azais-corentin/espion/docs/architecture.md

# Architecture

espion tracks markers that reflect or emit infrared light, using several camera boards. Every
board exposes its camera at the same instant, finds the bright blobs in each frame and sends
their subpixel centroids to the host over Ethernet. The host triangulates the markers in 3D.

```mermaid
flowchart LR
  subgraph board["Camera board (×N)"]
    S[OV9281<br/>global shutter, mono] -- "MIPI CSI-2<br/>2 lanes, RAW8" --> P4[ESP32-P4-Core module<br/>capture, blob detection,<br/>UDP, PTP]
    P4 -- "XVS trigger" --> S
    S -- STROBE --> G{{LED gate}}
    S -- "STROBE (ETM capture)" --> P4
    P4 -- LED_EN --> G
    G --> L[850 nm LED ring<br/>12 × Amicc A-SC880IR3C]
    P4 -- RMII --> PHY[IP101G PHY]
    PHY --> J[RJ45 + PoE PD]
    P4 <-- "I2C, INT1" --> IMU[MSA3S02 accelerometer]
  end
  J -- "UDP: espion-proto<br/>PTP (IEEE 1588)" --> SW[(PoE switch,<br/>unmanaged)]
  SW --> H[host:<br/>espion-server, viewer,<br/>calib, sync]
```

## Camera board

A baseboard for a Waveshare ESP32-P4-Core module.

| Part | Role |
|---|---|
| [Waveshare ESP32-P4-Core](https://docs.waveshare.com/ESP32-P4-Core), 16 MB flash (SKU 36096) | ESP32-P4 (rev v3.x) with 32 MB PSRAM: camera control, capture, blob detection, trigger, LED gating, Ethernet MAC with PTP clock |
| OV9281 camera module ([AliExpress](https://fr.aliexpress.com/item/1005012566040263.html)) | 1 MP mono global-shutter sensor, run at 640×400 (2×2 binned), RAW8, 120 fps, triggered on XVS |
| IP101G | 10/100 Ethernet PHY on RMII; supplies the 50 MHz RMII clock |
| HanRun HR871150C RJ45 MagJack | Ethernet jack with magnetics; passes both PoE pair sets to the PD |
| SDAPO DP1435-5V | 802.3af PoE PD module, isolated |
| TI TPS2121 | Picks PoE 5 V or USB-C VBUS, PoE first, no back-feed into USB |
| TI TLV62569 | 3.3 V buck for the module, the PHY and the camera |
| 850 nm LED ring and driver | 12 LEDs in series at a fixed sink current ([hardware/led.md](hardware/led.md)), lit only while `STROBE ∧ LED_EN`, ≤ 0.5 ms per frame at ≤ 120 fps; a hardware timeout cuts a pulse as a backstop |
| USB-C | Bench power, flashing, logs and JTAG (P4 USB Serial/JTAG, no hub) |
| Yongyu YY-0807BRGK26 RGB LED | Status LED (WS2812-type protocol), driven by RMT |
| MEMSensing MSA3S02 accelerometer | 3-axis, no gyroscope. Detects bumps (rig calibration may be stale) and gives the gravity vector |

Board design: [hardware/README.md](hardware/README.md)

## Data flow per frame

```mermaid
sequenceDiagram
  participant P4
  participant S as OV9281
  participant H as Host
  P4->>S: XVS edge at network time T(k)
  S-->>S: expose (STROBE high, LEDs on)
  S->>P4: frame k over MIPI CSI (DMA into a frame buffer)
  P4->>P4: threshold, connected components, weighted centroids (≤ 8.3 ms)
  P4->>H: UDP: espion-proto Centroids packet
  H->>H: group by frame k across boards, triangulate
```

- **Frame numbers match across boards by design.** Frame `k` is the one triggered at network
  time `T(k) = T0 + ⌊k · 10⁹ / 120⌋ ns`. Each packet carries `k` and the capture time
  ([timing.md](timing.md)).
- **Vision budget:** 8.3 ms per frame (1/120 s), end to end on the P4. Capture DMA of the next
  frame runs while the CPU processes the current one. Reference point on the ESP32-P4-ETH dev
  board, 2026-11-11: with live 1280 × 800 RAW8 at 120 fps in 64-line strips, the detector took
  2873 µs per frame on average (2916 µs at most) with the scalar dark skip and 762 µs (806 µs)
  with the PIE one, in a scene with no blob (`firmware/poc-p4-eth/README.md`, "Live strip
  soak, final configuration").
- **Network load:** a few hundred bytes per frame at 120 fps, well under 1 Mbit/s per board on
  a 100 Mbit/s link.

### Memory

The P4 has 768 KB of internal L2 memory, and the flash/PSRAM cache (128, 256 or 512 KB) is
carved out of it. A full frame is 640 × 400 × 1 byte = 250 KiB. With the 128 KiB L2 cache the
bootloader sets, the application has 568 KiB of internal RAM, and one such frame fits beside
`poc-p4-eth`'s other buffers; a 1280 × 800 frame (1000 KiB) is larger than all internal RAM
(`firmware/poc-p4-eth/README.md`, "Chip and memory" and "Detector benchmark (synthetic
frames)"). There is no heap on the P4: every buffer is static.

| Data | Where | Why |
|---|---|---|
| Frame buffers, 2–3 × 250 KiB (DMA fills one while the CPU reads another) | PSRAM | ≈ 61 MB/s at 120 fps (DMA write + one CPU read), under 10 % of the PSRAM's 800 MB/s peak (16-bit DDR, 200 MHz). Espressif's camera driver also keeps P4 frame buffers in PSRAM |
| Ambient mask from dark frames, 1 bit per pixel (32 KB) | Internal | Read for every pixel of every frame |
| Blob and label state, network and PTP buffers, stacks, hot code | Internal | Latency matters. Keeps Ethernet DMA off the PSRAM bus |
| Debug frame captures, calibration snapshots | PSRAM | Not used every frame |

- **Cache coherency:** CSI DMA writes PSRAM behind the CPU caches. Frame buffers are aligned
  and sized to whole cache lines, and the CPU invalidates a buffer's lines before reading a
  new frame from it. Every cache operation of our crates goes through `firmware/esp32p4-cache`,
  which serialises the ROM calls of both cores with one lock; esp-hal's own cache calls
  (Ethernet TX, DMA buffer helpers, `enable_direct`) are outside that lock. `poc-p4-stream`
  runs its own Ethernet DMA rings, which go through it.
- **Measured** (replaces the unverified 200 MB/s assumed here; `firmware/poc-p4-eth/README.md`
  unless named, ESP32-P4-ETH dev board, CPU at 400 MHz, PSRAM at 250 MHz, esp-hal 1.2.2's
  default, with which 200 MHz fails to initialise: "Chip and memory", "PSRAM tuning attempts"):
  - One core reads cold PSRAM at 163 MB/s at most (one load per 64-byte line) and at 120 MB/s
    when it sums every word; internal RAM gives 1424 to 1598 MB/s ("Read speed, one core",
    2026-11-10 and 2026-11-11).
  - The blob detector with the scalar dark skip, frames of 0 to 64 synthetic blobs, no DMA
    running, max of 50 passes ("Detector benchmark (synthetic frames)", 2026-11-10): 640 × 400
    takes 2.7–3.8 ms as a whole frame from PSRAM and 1.3–2.3 ms from 64-line strips in internal
    RAM; 1280 × 800 takes 10.0–10.9 ms from PSRAM and 4.3–5.2 ms from strips. A dark
    1280 × 800 frame costs about 3.8 cycles per pixel from cold PSRAM (about 104 MB/s) against
    1.65 from strips. The PSRAM path runs the same instructions at 0.23 instructions per cycle
    against 0.53 from strips: it waits for memory ("Detector benchmark with counters",
    2026-11-11).
  - Live, 1280-wide whole frames from PSRAM were processed at 85–106 fps instead of 120;
    strips held 120 fps in all four 120 fps modes ("Findings for the camera board").
  - With the L1 data and L2 cache autoload, a whole 1280 × 800 frame from PSRAM took 4.6 ms
    dark and 5.4 ms with 64 blobs, against 9.9 and 10.8 ms without; no DMA ran, and this
    whole-frame autoload has not run under live capture (`firmware/esp32p4-cache/README.md`,
    "Prefetch", 2026-11-11).
  - The detector of 2026-11-11 (span skip, PIE dark skip, hot code in RAM, L1 autoload per
    strip) is measured from strips only: 762 µs per live dark 1280 × 800 RAW8 frame ("Live
    strip soak, final configuration").

  What this means for the two options: at 640 × 400 RAW8, the frame size of this section,
  whole frames in PSRAM fit the 8.3 ms budget without prefetch (2.7–3.8 ms), and strips take
  1.3–2.3 ms. At 1280 × 800 whole frames in PSRAM fit only with prefetch, which is untested
  under live capture; strips fit. Every detector figure above except the last is from the
  scalar detector before the changes of 2026-11-11.
- **Fallback if that pass is too slow:** CSI DMA into a ring of line strips in internal memory
  (e.g. 64 lines, 40 KiB), processed strip by strip as the frame arrives. This also cuts
  latency. Built: the CSI bridge ends a DMA block after a set number of bursts, and
  `esp32p4-csi`'s `CsiStrips` delivers strips from a ring in internal RAM. In `poc-p4-eth` all
  four 120 fps modes ran on 64-line strips with every pixel processed, the centroids ready
  0.1–0.4 ms after the end of the frame ("Findings for the camera board").

## Firmware

| Crate | Chip / target | Runs |
|---|---|---|
| `firmware/cam-p4` | ESP32-P4, `riscv32imafc-unknown-none-elf` | One core runs the vision loop. The other runs embassy tasks: sensor control over SCCB, the XVS edge schedule (RMT), the PPS servo (ETM capture), Ethernet and embassy-net (DHCP, UDP), PTP (statime), the LED gate, and the accelerometer (bump detection, gravity) on a second I2C bus |
| `firmware/esp32p4-cache` | ESP32-P4 (no_std library) | Cache maintenance (invalidate, write-back) through the ROM, every call behind one cross-core spinlock held with interrupts masked on the calling core, because both cores share one set of cache-sync registers; and the hardware prefetch set-up (L1 data and L2 autoload, manual L1 data preload) on the `esp32p4` PAC. No esp-hal, esp-rtos or critical section, so a bare second core can call it. esp-hal's own cache calls (Ethernet TX buffers and descriptors, DMA buffer helpers, `enable_direct`) are not covered. Used by `esp32p4-csi`, `esp32p4-jpeg` and `poc-p4-stream`'s Ethernet rings; its prefetch by `poc-p4-eth` (L1 autoload per strip) and `poc-p4-stream` (L1 preload of the next datagram's bytes) |
| `firmware/esp32p4-csi` | ESP32-P4 (no_std library) | MIPI CSI-2 receiver driver on the `esp32p4` PAC, written in esp-hal style: ISP in bypass, a DW-GDMA (VDMA) channel into whole frames (`Csi`) or a ring of line strips in internal RAM (`CsiStrips`). Used by `cam-p4`, `poc-p4-eth` and `poc-p4-stream` |
| `firmware/esp32p4-jpeg` | ESP32-P4 (no_std library) | Hardware JPEG encoder driver (greyscale, baseline) and the 2D-DMA registers it needs, on the `esp32p4` PAC, in esp-hal style. Tested and measured in `poc-p4-eth` (`JPEG_PLAN`); streams the camera's frames in `poc-p4-stream` |
| `firmware/esp32p4-perf` | ESP32-P4 (no_std library) | Performance counters of the HP cores: cycles, instructions, conditional branches and their mispredictions, stores (CSRs), and the L1/L2 cache hit and miss counters; marker pins through the calling core's dedicated-IO CSRs (`marker`: enable, toggle in three instructions). No esp dependency and no lock, so a bare second core can call it. Used by the benchmarks of `poc-p4-eth`, by `espion-core1` and by the feature `markers` of the PoCs |
| `firmware/esp32p4-pie` | ESP32-P4 (no_std library), encoders host-testable | PIE (Xespv 2.2) vector kernels without compiler support: `const fn` encoders produce the instruction words, `asm!` emits them with `.insn`. `Pie::enable` turns PIE on for the calling core and hands out one token per core; esp-rtos saves no PIE state, so one thread per core may use it and no interrupt handler. Four kernels, each with a scalar reference and a self-test that passed on the board: the dark-skip scan for RAW8 and for RAW10, a copy at any alignment, the Internet-checksum sum. Feature `ram` puts the skip kernels in internal RAM. Used by `espion-vision`, `poc-p4-eth` and `poc-p4-stream` |
| `firmware/espion-core1` | ESP32-P4 (no_std library) | The blob detector on a bare core 1, started through esp-hal's `CpuControl` with no scheduler, no interrupts, no critical section and no logging there: its own trap vector, a loop that polls `esp32p4-csi`'s `StripReader`, runs `espion-vision` (PIE skip on core 1's own token, the L1 data autoload over each strip) or a row-checksum pixel check, and publishes one result per frame through a single-producer single-consumer queue of atomics; core 0's handle hands the reader over, calls `StripControl::service()`, drains the results, logs core 1's figures once a second and watches its heartbeat and trap record. Feature `markers`: core 1 toggles two dedicated-IO channels (strip taken, frame done), and core 0 routes marker channels of either core to pads and reads them back at boot. Used by `poc-p4-eth` (`RUN_CORE1`) and `poc-p4-stream` (`Service::BenchVision`) |
| `firmware/espion-vision` | no_std library, host-testable | The blob detector: threshold, runs per row, 8-connected components with union-find, intensity-weighted centroids in 1/32 pixel, area and peak; RAW8 and CSI-2 RAW10, whole frames or strips of rows. The dark skip is a `Skip` trait passed to each call: `Scalar` (the reference) or, with feature `pie`, `esp32p4-pie`'s token; feature `ram` puts the hot functions in internal RAM. Its tests compare it with a flood-fill reference on random frames. For `poc-p4-eth` (benchmarks and soaks), `espion-core1` (core 1) and `cam-p4` |
| `firmware/poc-p4-eth` | ESP32-P4 on the Waveshare ESP32-P4-ETH, `riscv32imafc-unknown-none-elf` | Throwaway proof of concept, not part of the product, without Ethernet: OV9281 capture in 12 modes (whole frames in PSRAM or strips in internal RAM) and soaks, the detector's benchmarks, the JPEG encoder's test |
| `firmware/poc-p4-stream` | ESP32-P4 on the Waveshare ESP32-P4-ETH, `riscv32imafc-unknown-none-elf` | Throwaway proof of concept, not part of the product: Ethernet with IPv6 link-local only (esp-hal brings the EMAC and the IP101GRI PHY up; the crate's own EMAC DMA rings carry the data, and the stream's datagrams go straight onto the TX ring beside smoltcp, the body copied by PIE), and the `espion-proto` camera stream service on UDP 5009: the OV9281 through `ov9281` and `esp32p4-csi`, frames sent raw or encoded by `esp32p4-jpeg`, every setting taken from the host. Viewed with `host/poc-viewer` |
| `firmware/ov9281` | no_std library, host-testable | OV9281 sensor driver: the mode solver (format, size, crop or binning, frame rate → clock, HTS, VTS and registers, refusing what the measured limits do not allow) and SCCB control over `embedded-hal-async` I2C. For `poc-p4-eth` and `cam-p4` |

`cam-p4` uses `esp-hal` and `esp-rtos` (embassy executor). The XVS edge schedule reuses the
RMT technique from the private
[esp-wifi-sync](https://github.com/azais-corentin/esp-wifi-sync) experiments (`wave.rs`).

### Network

- **Addressing:** DHCP only. The rig network needs a DHCP server (the host or the router).
- **Finding the host:** the host is whoever sent the last Config or FrameEpoch. Until a host
  is known, Status is broadcast ([protocol.md](protocol.md)).
- **PTP:** statime as an ordinary clock over UDP/IPv4 multicast, with hardware timestamps from
  the EMAC ([timing.md](timing.md)). The board joins the PTP multicast group with IGMP
  (embassy-net `multicast`).

## Host

| App | Role |
|---|---|
| `espion-server` | CLI. Receives UDP packets, groups centroids by frame number, triangulates with the current calibration |
| `espion-viewer` | egui live view: blobs per camera, 3D markers, sync health |
| `espion-calib` | Lens model per camera (intrinsics) and rig extrinsics |
| `poc-viewer` | egui live view and control of the `poc-p4-stream` camera stream: every sensor and stream setting, JPEG frames decoded off the UI thread (`zune-jpeg`) and shown through wgpu, statistics; a fake camera that speaks the protocol (`jpeg-encoder`); the board test. Proof of concept, not part of the product |
| `espion-sync` | Watches and coordinates time sync. The network clock is PTP, and the boards elect the grandmaster among themselves. espion-sync sets the frame epoch `T0`, maps network time to host time, and reports the grandmaster and each board's sync health. It never becomes grandmaster |

`crates/espion-proto` is the single source of truth for the UDP wire format
([protocol.md](protocol.md)).

## Pinned versions

Checked on 2026-10-28; the `esp-rom-sys` row and the notes on PIE, cache calls and `memcpy`
added on 2026-11-11. The firmware crates commit their `Cargo.lock`.

| Component | Version | Notes |
|---|---|---|
| Rust | 1.99.1 (stable) | `rust-toolchain.toml`; esp-hal needs ≥ 1.95. rustc's LLVM knows no PIE instructions: `esp32p4-pie` emits encoded words |
| esp-hal | ~1.2.2 | `unstable` feature needed for RMT, DMA, PSRAM and Ethernet. Its ROM cache calls take no cross-core lock (see `esp32p4-cache`) |
| esp-rom-sys | 0.1.5 | Through esp-hal. Binds `memcpy` to the ROM routine, which copies byte by byte when source and destination differ modulo 4 ([gaps](#esp-hal-support-and-gaps)) |
| esp-rtos | 0.4.0 | embassy integration (replaces esp-hal-embassy). Saves no PIE state on a thread switch (see `esp32p4-pie`) |
| esp-bootloader-esp-idf | 0.6.0 | App descriptor for the ESP-IDF second-stage bootloader |
| esp-println / esp-backtrace | 0.18.0 / 0.20.0 | |
| esp32p4 (PAC) | 0.3.x | Same major as esp-hal 1.2.2; used by the CSI driver, ETM, the EMAC PTP clock, and the cache, JPEG and PIE crates |
| embassy-executor / embassy-time / embassy-net | 0.10.0 / 0.5.1 / 0.9.1 | embassy-net with `dhcpv4`, `udp`, `multicast`, `medium-ethernet` (`cam-p4`); `poc-p4-stream`: `proto-ipv6`, `udp`, `medium-ethernet`, `auto-icmp-echo-reply` |
| embassy-sync / embassy-futures / embassy-net-driver | 0.8.0 / 0.1.2 / 0.2.0 | `poc-p4-stream`; the versions esp-hal 1.2.2 and embassy-net 0.9.1 use |
| static_cell | 2.1.1 | Static task and buffer storage (`poc-p4-stream`) |
| statime | 0.4.0 | `default-features = false`: no_std, no `alloc`. Builds for `riscv32imafc-unknown-none-elf` |
| serde / postcard | 1.0.229 / 1.1.3 | `default-features = false` on firmware |
| espflash / probe-rs | 4.6.0 / 0.32.0 | From nixpkgs (flake.lock) |
| embedded-hal-async | 1.0.0 | I2C and delay traits of `firmware/ov9281`; the version esp-hal 1.2.2 implements |
| eframe (egui, wgpu) | 0.37.0 | Host GUI (`poc-viewer`); the `egui_mcp` version in `flake.nix` must match |
| zune-jpeg | 0.5.15 | Host JPEG decoder (`poc-viewer`): pure Rust, SIMD on x86; chosen against libjpeg-turbo by measurement (`host/poc-viewer/README.md`) |
| jpeg-encoder | 0.7.1 | Host JPEG encoder of the fake camera (`poc-viewer`); licence `(MIT OR Apache-2.0) AND IJG` |

## esp-hal support and gaps

Status from the esp-hal 1.2.2 support table and `esp-metadata` (✔ supported, ⚒ partial,
❌ not supported). Only what espion needs is listed.

| Need | esp-hal 1.2.2 | Plan |
|---|---|---|
| MIPI CSI-2 receiver | ❌ | Own driver in `firmware/esp32p4-csi` on the `esp32p4` PAC. Written like an esp-hal driver (`Config`, typed pins, DMA buffers, blocking and async APIs, HIL-testable), but not meant for upstream. On the ESP32-P4-Core the MIPI PHY runs from `ESP_LDO_VO3`, which is 0 V by default: the driver sets it to 2.5 V before starting the CSI host |
| ISP | ❌ | Bypassed: RAW8 goes straight to memory. Blob detection needs no demosaicing (mono sensor). `esp32p4-csi` disables the ISP pipeline; its header and tail stay in the CSI → memory path. Captures worked so in all 12 modes of `poc-p4-eth` |
| DMA for CSI | ⚒ (DMA partial) | The CSI bridge feeds a DW-GDMA ("VDMA") channel. esp-hal has the `VDMA_CH0`..`VDMA_CH3` singletons but no driver for this path, so `esp32p4-csi` programs it: one block per frame into PSRAM, or blocks of strips that the bridge ends after a set number of bursts (see [Memory](#memory)). The driver does the cache invalidation |
| I2C master (SCCB, accelerometer) | ✔ | Two buses: SCCB to the camera, and the accelerometer on its own pins |
| Ethernet (EMAC, RMII) | ⚒ `unstable` ([esp-hal#5556](https://github.com/esp-rs/esp-hal/pull/5556), "basic") | `esp_hal::ethernet::Ethernet` with an `RmiiPinBundle`, `ExternalRefClock` on GPIO50 and its embassy-net driver. **Verified on the ESP32-P4-ETH** (`firmware/poc-p4-stream`, IP101GRI PHY, 100 Mbit/s full duplex, IPv6 only): board to host at the wire limit (11.80 MB/s of 1452-byte UDP datagrams, from internal RAM and from cold PSRAM, none lost or wrong); host to board at the wire limit for 60 s with every byte checked (RX-buffer cache maintenance works) and 100 small datagrams/s beside full-rate TX, none lost. Needs three workarounds in the firmware, each a defect to take upstream: (1) TX store-and-forward, which the driver turns on, breaks frames above a few hundred bytes on the P4 (lost, wrong checksums): switch the DMA to threshold mode, as ESP-IDF does; (2) then the EMAC inserts no checksums (the driver sets CIC 3 and tells smoltcp to skip them), so smoltcp computes the UDP and ICMPv6 checksums (`Checksum::Tx`); (3) the driver's DMA-buffer check takes esp-metadata's DRAM range, which assumes a 256 KiB L2 cache: with the 128 KiB the bootloader sets, statics below 0x4FF40000 panic, so the DMA storage goes in a linker section at or above it. Since 2026-11-11 `poc-p4-stream` uses esp-hal's driver only to bring the EMAC and the PHY up, then starts the DMA on its own rings (`net/eth.rs`, no esp-hal change): threshold mode from the start, one cache call per frame through `esp32p4-cache` where esp-hal's rings made one or two ROM cache calls per token request (about 1 200 cycles), and a TX completion interrupt on every 8th frame instead of every frame; the runner went from 27 100–27 400 to 14 700–15 800 cycles per datagram in the bench (`firmware/poc-p4-stream/README.md`, "Measured: step 2, the Ethernet ring" and "The Ethernet driver"). Workaround (3) then covers only the 3 200 B descriptor storage `Ethernet::new` still needs. `GenericPhy` wakes the runner on every poll and reads three MDIO registers each time: use a PHY driver that polls the link on a timer. smoltcp 0.13 (embassy-net 0.9) can panic in `send_to_with` when a socket's TX metadata ring is the limit: size it above the payload ring. Not verified: 10 Mbit/s and half duplex, link loss and re-negotiation, multicast, PTP |
| EMAC IEEE 1588 (PTP clock, timestamps, PPS) | ❌ | The clock (sub-second increment, addend, time update) and PPS are EMAC registers at the MAC base + 0x700. The `esp32p4` 0.3 PAC has no block for them (only `EMAC_MAC` and `EMAC_DMA`), so `cam-p4` writes them through raw pointers, with the offsets from ESP-IDF. The TRM does not document the PPS control and auxiliary snapshot fields that ESP-IDF's register struct has: check them on the first board. The RX/TX timestamps sit in the DMA descriptors that esp-hal's driver owns, and it ignores descriptor words 4–7. That needs an esp-hal change: carry it as a `[patch.crates-io]` fork and upstream it. Measured alternative: `poc-p4-stream` owns its descriptor rings (32-byte enhanced format) after esp-hal's bring-up, without changing esp-hal ("The Ethernet driver" in its README) |
| Per-packet timestamps to statime | n/a | embassy-net sockets carry no per-packet metadata. The driver matches PTP event frames (UDP 319) to their descriptor timestamps by message type and `sequenceId` and hands them to statime |
| RMT | ⚒ | XVS edge schedule, as in esp-wifi-sync `wave.rs` (TX channel 0), the status LED (WS2812-type protocol, channel 2 or 3) and the 50 kHz `BST_EN` PWM that sets the LED boost's output (a third TX channel in loop mode, [hardware/firmware-rules.md](hardware/firmware-rules.md) FW-8) |
| ETM | ❌ | Needed from day one: the PPS edge and the STROBE edge (GPIO events) trigger timer capture tasks. PAC-level code in `cam-p4`. Per the TRM, SYSTIMER has no capture task; timer 0 of each timer group has one (TG0's is taken by esp-rtos, so TG1 timer 0), and MCPWM capture (three registers per unit, 6.25 ns) is the alternative ([timing.md](timing.md) section 2). The VDMA, the CSI host and bridge, the ISP, the EMAC and RMT have no ETM event or task, so strip and frame completion stay interrupts or polls. Still to measure on the board: ETM latency, and whether a GPIO event fires on a pad the EMAC drives as PPS output (the board also loops PPS into a second GPIO through R34, so either way works) |
| MCPWM / PCNT / LEDC | ❌ (no LEDC or MCPWM driver for the P4) | Not needed: STROBE gates the LEDs, and the `BST_EN` PWM runs on RMT |
| ADC (one-shot) | ⚒ `unstable` | ADC1 channel 7 (`LED_K_SENSE`). It is read late in each LED pulse for the boost headroom loop (FW-22), so the conversion is timed from the STROBE capture; check the one-shot conversion time against that window. It also confirms the boost is up before the LEDs run (FW-7) |
| SYSTIMER, TIMG | ⚒ | Local timebase, embassy time driver |
| PSRAM | ⚒ | Frame buffers (CSI DMA target) and data not used every frame; see [Memory](#memory) |
| USB Serial/JTAG | ⚒ | Flashing and logs. The board has no VBUS sense, so the D+ pull-up stays on ([hardware/firmware-rules.md](hardware/firmware-rules.md), FW-4 removed) |
| Chip revision | v3.0+ only | The ESP32-P4-Core carries an ESP32-P4NRW32X, rev v3.x |
| JPEG codec (hardware encoder) | ❌ (the PAC has the `JPEG` block, but marks the quantisation-table registers `T0QNR`..`T3QNR` read-only, which the TRM and ESP-IDF write) | Own driver in `firmware/esp32p4-jpeg` on the PAC: greyscale baseline JPEG from a frame in PSRAM or internal RAM, header and IJG quality tables built by the CPU, async wait on the `JPEG` interrupt, cache maintenance and error recovery in the driver. Colour formats, decoding and restart markers are not covered |
| 2D-DMA | ❌ (no driver; no register block in the `esp32p4` 0.3 PAC; its interrupt sources 104..=108, 133, 134 are missing from the PAC's `Interrupt` enum, so esp-hal cannot bind them) | Register offsets from ESP-IDF `hw_ver3/soc/dma2d_reg.h` (TRM chapter 8) in `esp32p4-jpeg` (`dma2d` module): TX channel 0 (2D, macroblock reordering) and RX channel 1 (1D) connected to the JPEG codec, nothing else. Its own interrupts are not used: the driver polls their raw bits after the codec's interrupt. PPA and memory-to-memory transfers are not covered |
| PIE (Xespv 2.2 SIMD) | n/a (rustc's LLVM knows no PIE instructions) | `firmware/esp32p4-pie`: `const fn` encoders, the words emitted with `.insn` in `asm!` on stable Rust, checked against Espressif's assembler. Nothing saves PIE state: not the trap entry (riscv-rt, esp-riscv-rt), not esp-rtos 0.4.0's thread switch. So one PIE-using thread per core and none in an interrupt handler; the per-core token enforces the first part |
| Cache maintenance from two cores | ❌ (the ROM cache calls run without a lock; both cores share one set of cache-sync registers) | `firmware/esp32p4-cache`: every call behind one cross-core spinlock, as ESP-IDF does. esp-hal's own calls stay outside it (see [Memory](#memory)) |
| Cache prefetch (L1 data and L2 autoload, L1 data preload) | ❌ (no config key on the P4) | `esp32p4-cache`'s `prefetch` module writes the `CACHE` registers through the PAC. Run under live DMA in `poc-p4-eth` (per strip) and `poc-p4-stream` (per datagram); see its README |
| Performance counters | ❌ (esp-hal 1.2.2 has no API; its source does not touch `mhpmevent`, `minstret` or `mcountinhibit`) | `firmware/esp32p4-perf`: `mcycle`, `minstret`, the branch, misprediction and store counters (their selectors `mhpmevent8/9/13` are 0 at boot, so they count nothing until written) and the `CACHE` block's L1 and L2 hit and miss counters |
| Dedicated IO (CPU GPIO channels) | ⚒ `unstable` (`gpio::dedicated`, 8 channels per core; its drivers pick the signal of the core they are created on and must stay there, so core 0 cannot set up core 1's channels with them) | Marker pins (`esp32p4-perf` `marker`, `espion-core1` `markers`): either core's channel routed from core 0 with `OutputSignal::CPU_GPIO_n::connect_to` (core 0 signals 214 to 221, core 1 222 to 229), the output enabled by the driving core through its own `cpu_gpio_oen` CSR. The enable is active low, as esp-hal and ESP-IDF have it and against the TRM (p.175): checked on the board |
| `memcpy` | n/a (esp-rom-sys 0.1.5 binds it to the ROM routine by a plain assignment, `memcpy = 0x4fc0026c;`, so a definition in a crate does not replace it; only a link option could) | The ROM routine copies byte by byte when source and destination differ modulo 4: 9.06 cycles per byte against 1.71 aligned (`firmware/esp32p4-pie/README.md`, "Kernels"). Hot copies use `Pie::copy`: the stream bench's datagram copy from internal RAM went from 13 041 to 1 349 cycles (`firmware/poc-p4-stream/README.md`, "Measured: step 1, the datagram copy through PIE") |

Tooling: esp-generate 1.4.0 has no ESP32-P4 template. `cam-p4` was adapted from the C9 template
and the esp-hal 1.2.2 examples.
