azais-corentin/espion/docs/hardware/ethernet.md

# Ethernet

10/100 Ethernet for the P4's EMAC: an IP101G PHY (U1) on RMII, and a HanRun HR871150C MagJack
(J1) that also hands both PoE pair sets to the PD module ([power](power.md#poe-input)). The PHY
supplies the 50 MHz RMII clock.

| Signal | U6 pin | GPIO | Use |
|---|---|---|---|
| RMII_CRS_DV | U6.40 | GPIO28 | RMII receive data valid (PHY strap FX_HEN) |
| RMII_RXD0 / RXD1 | U6.41 / U6.42 | GPIO29 / GPIO30 | RMII receive data |
| RMII_TXD0 / TXD1 | U6.46 / U6.47 | GPIO34 / GPIO35 | RMII transmit data (P4 straps) |
| RMII_TX_EN | U6.67 | GPIO49 | RMII transmit enable |
| RMII_REF_CLK | U6.68 | GPIO50 | 50 MHz clock input from the PHY |
| MDC / MDIO | U6.43 / U6.70 | GPIO31 / GPIO52 | PHY management (GPIO matrix) |
| PHY_RST_N | U6.18 | GPIO22 | PHY reset, active low |

Firmware use of these pins and the PHY: [firmware-rules](firmware-rules.md#gpio-map),
[rules](firmware-rules.md#rules).

## PHY

U1 is an IC Plus IP101G (QFN-32, 0.4 mm pitch; the IP101GRI industrial grade, rated to 85 °C ambient,
p.57), on the top side next to J1.
The source is the IP101G datasheet IP101G-DS-R01 (2014-05-20), cited below by page. VDDIO (pin 13) and
AVDD33 (pin 31) are on +3V3, so the 3.3 V I/O and timing rows apply. The PHY and the P4's I/O share
one rail, so neither can back-power the other.

- **Part choice.** IC Plus publishes no MSL or reflow rating for the IP101G. JLCPCB lists MSL 3, but
  that is distributor data. The part is kept, and the missing maker statement is an accepted risk
  (user decision, 2026-10-31: "Keep IP101GRI, accept risk"). There is no drop-in alternative, and a
  0.4 mm QFN can't be hand-soldered reliably.
- **Decoupling.** C7 sits at AVDD33 and C9 at VDDIO, with C8 as the local bulk capacitor. The datasheet
  sets no values here, only "decoupled carefully" (p.18) and "as close as possible" (p.56). The
  `near` entries C9/C7 → U1, C6 → U1.28 and C4 → C6 carry the "close" distance. The exposed pad (pin 33,
  ground) is stitched to GND with vias.
- **Unused pins.** TXD3/TXD2 (pins 6/7) and TXER (pin 1) go to GND (p.16). RXD2/RXD3 and RXER/INTR_32
  are outputs and stay open. TEST_ON (pin 24) stays open on its internal pull-down (p.18).

### Crystal

Y1 is a 25 MHz Epson TSX-3225. RMII with a crystal takes 25 MHz (Table 3, p.45).

| Item | Y1 (Epson p.1) | IP101G needs (Table 14, p.58) |
|---|---|---|
| Load capacitance C_L | 12 pF | — |
| ESR | ≤ 40 Ω | ≤ 40 Ω |
| Drive level | 10–100–200 µW | 100 µW typ |
| C0 / C1 | 1.39 pF / 3.78 fF | C0 ≤ 7 pF |
| Tolerance | ±10 ppm at 25 °C, ±20 ppm over −40…+85 °C | ±50 ppm |

Load capacitors C2 and C5 (C0G):

- C = 2 × (C_L − C_stray). C_stray is assumed to be 3 pF for the pin and trace, because the IP101G
  gives no pin capacitance.
- Pulling: Δf/f = (C1/2) × (1/(C0 + C_L,a) − 1/(C0 + C_L,b)), with C_L,a the effective load and C_L,b
  the nominal C_L. The effective load is C_L,eff = C/2 + C_stray, with C_stray taken over an assumed
  2–5 pF range.
- Worst sum: pull + initial tolerance (±10 ppm) + temperature tolerance (±20 ppm) must stay within the
  PHY's and RMII's ±50 ppm.

Placement:

- Y1 sits next to U1, and both XTAL lines are short. At 25 MHz both lines are electrically short.
  XTAL_X1 loops round the crystal's north side to Y1.1.
- There is no GND guard trace round the crystal. The datasheet asks for one "if possible" (§6.1 p.56),
  and here it isn't possible. The crystal relies on distance and the In1/In2 GND planes. The nearest
  other copper is a +32V track at C2's X1 pad, and the LED switch Q1's drain copper (`kicad_query distance`;
  [layout](layout.md#ethernet-and-poe-isolation)).
- MDC, MDIO, R14's +3V3 feed and the COL/RMII strap cross under Y1, C5 and the X1/X2 traces on B.Cu,
  with the In1 and In2 GND planes between. MDC crosses the X2 traces, under the Y1.3 and C5.1 pad
  corners; it runs along a clock trace only under U1.2's pad and its X1 stub, against §6.1 p.56 ("Avoid
  signals path parallel to clock signals path … such as MDC and X1"). There is no other way: U1's
  management pins face east, U6 lies south-west, and the RMII fan-out, MDI, Q1's drain zone and the
  board edge close every other B.Cu path. ETH_LED_G crosses only the X1 link C2–Y1, once, at right angles
  ([layout](layout.md#ethernet-and-poe-isolation)).

### REGOUT and ISET

- **REGOUT** (pin 28) is the PHY's internal 1.1 V regulator output, 1.07–1.18 V (p.57). C4 and C6
  decouple it, as the datasheet asks ("A 10uF and 0.1uF should be connected", p.18). Pin 28 lies between
  the two MDI pairs, so its track leaves north and reaches C6 over B.Cu through vias, then the C6/C4
  pour; C6 is close to the pin edge to edge (`near` entry C6.1 → U1.28,
  [layout](layout.md#phy-side-decoupling)). A first-board check scopes REGOUT at C6.
- **ISET** (pin 25) sets the transmit amplitude. R6 to GND is the ISET resistor; the datasheet asks
  for 6.19 kΩ ±1 % (p.18, p.53). R6 is the nearest fee-free value at ±1 % (user decision
  2026-11-09); its band ends slightly above the datasheet's (an [accepted risk](#accepted-risks)).
- Both pins sit next to the MDI pads at the 0.4 mm pitch, so their tracks leave between the MDI pairs
  (see [MagJack and MDI](#magjack-and-mdi)).

### Reset

- PHY_RST_N runs from GPIO22 (U6.18) to RESET_N (U1.32), with no pull on the board: R8, the
  pull-down that held the PHY in reset through the P4 boot, was removed (user decision
  2026-11-11, board simplification; the reset pulse moved to firmware).
  - RESET_N has an internal 222 kΩ pull-up (p.12). GPIO22 has no pull and its input is disabled
    at and after reset (ESP32-P4 datasheet v0.7 p.15). So RESET_N rises with the supply at
    power-up, and the PHY runs from then on, through the whole P4 boot.
  - That rise is not a complete reset: the IP101G wants RESET_N low ≥ 10 ms (p.54) with the
    25 MHz clock running ≥ 10 cycles before the rising edge (p.18). So the firmware resets the PHY
    before it uses it: PHY_RST_N low ≥ 10 ms with the crystal running, release, wait ≥ 2.5 ms
    (FW-11, [firmware-rules](firmware-rules.md#rules)).
  - Between power-up and that pulse the PHY drives 50 MHz (50M_CLKO, through R13) into GPIO50 and
    its receive lines (RXD0, RXD1, CRS_DV, straight from its pins) into GPIO28–30. None of these is a
    P4 strap (the straps are GPIO34–38, ESP32-P4 datasheet §3 p.36), and all have input and pulls off
    at reset (p.15–16).
  - The straps are static resistors (R1, R10) or the PHY's own pulls ([Straps](#straps)), so the
    PHY latches the same values at its power-up and at the firmware's pulse. FX_HEN (on CRS_DV)
    latches at power-up with GPIO28 high impedance (the P4 in reset or booting, no pull).
- TP1 (silkscreen "PRST") is on the net.
- **Firmware order.** While in reset, the PHY drives no 50 MHz clock (50M_CLKO is Hi-Z), and the
  EMAC has no other clock. So after the reset pulse the firmware waits ≥ 2.5 ms before it touches
  the EMAC or MDIO ([firmware-rules](firmware-rules.md#rules)).
- PHY_RST_N is a long net with several vias. It runs round the lens inside the LED ring, partly close
  to the ring pads. Until the firmware drives it, only the PHY's 222 kΩ pull-up holds it high, while
  the LEDs are still off (their enables default off, [led](led.md#bst_en)). Once driven it
  is a low-impedance push-pull line. A first-board check confirms the LED pulses don't disturb it.

## MagJack and MDI

### J1

J1 is a HanRun HR871150C: an RJ45 with magnetics (1CT:1CT), PoE centre taps
brought out, Bob-Smith termination, two LEDs and a shield. It is a through-hole part on the bottom
side at the east edge, soldered by hand ([layout](layout.md#assembly)).

- **J1 pin field.** HanRun rates the jack at 2250 V dc from the cable side to the chip side (p.1),
  which is why the "PoE isolation" rule exempts pad pairs inside J1
  ([layout](layout.md#ethernet-and-poe-isolation)).
  - The J1 lands are trimmed below the stock pad sizes, so the gaps between the chip-side pins, the
    cable-side pins and the shield stay open (`kicad_query distance`).
- **PoE.** J1.7–J1.10 (VC1+, VC1−, VC2+, VC2−) carry the cable voltage from both pair sets (mode A
  and mode B) to U2 pins 1–4 (POE_VA1, POE_VA2, POE_VB1, POE_VB2). These four nets are class POE_CABLE:
  tracks sized for the jack's 350 mA centre-tap rating (p.1), in a lane of their own on In1. The PD
  side and the board's isolation (some isolation only, no level rated or tested) are in
  [power](power.md#poe-input).
- **Chip-side centre tap.** J1.3 (ETH_CT) goes only to C3, to GND. The IP101G has internal
  terminations and wants no bias on the centre tap ("Do not connect to any power", p.7), and it asks
  for decoupling there (p.56).
- **Shield.** J1's shield (J1.SH) is tied straight to GND: its through-hole pads join the In1/In2 GND
  planes. There is no RC network to GND (user decision 2026-11-09, "replace R2, R3 and C1 by a
  wire"); the Bob-Smith termination stays inside the jack (HanRun p.1). Cable-shield and ESD
  currents return through board GND ([Accepted risks](#accepted-risks)).
- **Hand-soldering trial.** J1's lands are close to a reflowed part, C3. J1's hand-assembly note
  asks for a conical tip ≤ 1 mm and Kapton over it.

### MDI pairs crossed at J1

The pairs are swapped at J1, and inside each pair P and N are inverted on purpose, so that both pairs
route on F.Cu without crossing each other or themselves, and without vias:

| U1 pin | PHY function | Net | J1 pin | Jack function |
|---|---|---|---|---|
| U1.30 | MDI_TP (transmit +) | ETH_RD_N | J1.5 | RD− (RJ45 6) |
| U1.29 | MDI_TN (transmit −) | ETH_RD_P | J1.4 | RD+ (RJ45 3) |
| U1.27 | MDI_RP (receive +) | ETH_TD_N | J1.2 | TD− (RJ45 2) |
| U1.26 | MDI_RN (receive −) | ETH_TD_P | J1.1 | TD+ (RJ45 1) |

- The PHY transmits on RJ45 pins 3/6. That is MDI-X wiring, and it works because the IP101G swaps its
  pairs itself.
- The net names follow the J1 pin they reach. Each PHY + pin reaches the jack's − pin and each − pin
  its + pin, so both pairs are P/N-inverted between U1 and J1. In each pair the U1 pin that leaves on
  the west ends on the south lane at J1 (J1.5, J1.2), so the pair runs straight.

IP101G register facts the wiring relies on:

- "Supports Auto MDI/MDIX function" (p.1).
- Page 16, register 16 bit 11, AUTO_MDIX_DIS: R/W, default 0. "Set high to disable the automatic switch
  of MDI and MDI-X modes" (p.25).
- With auto-MDIX on, the PHY "will switch TX and RX pairs automatically", in auto-negotiation and in
  forced mode (§5.1.6 p.46).
- Register 18 bit 9 (MDI/MDIX) and bit 8 (POLARITY) are read-only status bits (p.27). Bit 8:
  "To indicate the polarity of twist pair N/P is reversed".
- Page 16, register 30 bit 3, FORCE_MDIX: default 0, which means MDI when auto-MDIX is off (p.29).

So the firmware must never set AUTO_MDIX_DIS. If auto-MDIX ever has to be off, it must set
FORCE_MDIX = 1, because the board's wiring is the PHY's MDI-X channel
([firmware-rules](firmware-rules.md#rules)).

The P/N inversion rests on a user decision (2026-11-04): "The IP101GRI datasheet on page 27 explicitly
says: POLARITY — To indicate the polarity of twist pair N/P is reversed … This obviously means that
polarity reversion is supported." Until then each P line hopped under its N line on B.Cu through two
vias to keep P on P. Consequences:

- The PHY's receive pair arrives inverted whichever pair auto-MDIX picks. At 10 Mbit/s register 18
  bit 8 (POLARITY) is expected to read 1. At 100 Mbit/s the data doesn't depend on polarity and the
  bit may read 0 or 1: it can only come from the auto-negotiation link pulses, and p.27 doesn't say
  when it updates. The firmware must not treat a reversed reading as a fault
  ([firmware-rules](firmware-rules.md#rules)).
- Residual: the polarity-sensitive parts are 10BASE-T (Manchester data and its link pulses) and the
  auto-negotiation link pulses (FLP), which are exchanged before a 100 Mbit/s auto-negotiated link
  too. So both the IP101G (for our receive pair, p.27) and the link partner (for our transmit pair)
  must handle reversed link pulses for auto-negotiation at either speed, and reversed data at
  10 Mbit/s. 100BASE-TX data itself is unaffected: "Wrong polarity affects 10BASE-Te connections.
  100BASE-TX is immune to polarity problems because 100BASE-TX uses MLT-3 encoding" (TI DP83822
  datasheet Rev. H, https://www.ti.com/lit/ds/symlink/dp83822i.pdf, §7.4.5.4 p.41). The first-board
  link check runs at 10 and 100 Mbit/s with a straight and a crossover cable
  ([First-board checks](#first-board-checks)).

### MDI routing

- **Geometry.** Net class MDI, on F.Cu over the In1 GND plane: the same geometry as the MIPI pairs,
  100 Ω differential nominal ([layout](layout.md#impedance)). The MDI lines are short enough for
  100BASE-TX that the impedance spread without impedance control doesn't matter.
- **Vias.** IP101G §6.2 (p.56) says "it is best not use via to place anywhere other than in close
  proximity to device". The MDI lines have none: both pairs run on F.Cu only, from U1's pins to J1's,
  with no P/N crossing.
- **Length matching.** TI SNLA387 (p.2, "MDI Traces") asks for P/N matching within 50 mil for
  100 Mbit/s; the DRC rule "MDI intra-pair skew" holds it. J1.1 and J1.5 sit further west than J1.2 and
  J1.4, so TD_P and RD_N have the longer way to the jack; TD_N and RD_P carry 45° trapezoid bumps to
  match them ([layout](layout.md#mdi)).
- **Spacing.** IP101G §6.2 asks for "three times space" between an MDI pair and other signals. The DRC
  rule "MDI spacing" holds it (3 × the track width, rounded up).
  - Inside U1's escape area (the F.Cu rule area "U1 MDI escape" and U1's courtyard) the 0.4 mm pitch
    makes that impossible. ISET (pin 25), REGOUT (pin 28) and AVDD33 (pin 31) sit next to the MDI pads,
    so only the default clearance applies there. This is an accepted deviation; the datasheet grants no
    exception.
  - Outside it the closest pads (J1.13/J1.14) stay just above the rule's limit
    (`kicad_query distance`); pours keep the rule's clearance.
  - The TX and RX pairs keep 3W from each other outside the same U1 exemption (DRC rule "MDI pair to
    pair"). The closest spot is the RD_P–TD_N diagonal pair west of R6, which the DRC passes.

### LEDs

| LED | J1 pins | Driven by | Mode 1 meaning (Table 7, p.53) |
|---|---|---|---|
| Green | LEDG+ J1.13 = +3V3, LEDG− J1.14 → R4 → PHY_LED0 (U1.11) | LED0 sinks (active low) | Link |
| Yellow | LEDY+ J1.11 ← R5 ← PHY_LED3 (U1.12), LEDY− J1.12 = GND | LED3 sources (active high) | 100 Mbit/s link, blinking with traffic |

- The LED pad driver limits the current to its default 1.62 mA (LED_DRIVE, p.35). R4 and R5 limit it
  if the firmware raises the drive: I ≤ (+3V3 max − V_F)/R, with +3V3 at the top of its ±5 % envelope,
  V_F the jack LED's forward voltage, and R4/R5 as R. Each resistor's dissipation I² × R must stay
  within its 0402 rating with derating.
- Each LED's polarity follows its pin's strap value (Fig. 12, p.47): the LED goes to VDD on a pin
  strapped 1 (AD0) and to GND on a pin strapped 0 (AD3). See [Straps](#straps).

## RMII

The PHY makes the RMII clock. With COL/RMII strapped to RMII and a 25 MHz crystal, 50M_CLKO (U1.14)
puts out 50 MHz (p.45). The path:

- 50M_CLKO → R13 → net RMII_REF_CLK.
- At R13.2 the net splits in a star to U1.10 (50M_CLKI, the PHY's own timing reference, p.16) and to
  U6.68 (GPIO50, EMAC_CLK_EXT_IN). GPIO50 is input only, so the MAC can't drive the clock.

This is the datasheet's internal-clock topology (Fig. 8, p.44) and the one on Espressif's
ESP32-P4-Function-EV-Board. Its buffer (Fig. 10, p.45) is needed only for a third clock load, which
this board doesn't have.

### RMII drive and termination

R13 on REF_CLK is the only series resistor: Espressif's design guidelines recommend one on the RMII
clock (§1.3.14, p.20); it sits at the PHY's 50M_CLKO (`near` entry R13 → U1).

- **No series terminations on the data lines** (user decision 2026-11-11, board simplification; R13
  stays). RXD0, RXD1 and CRS_DV run from U1 straight to U6, TXD0, TXD1 and TX_EN from U6 straight to
  U1, each one net from driver pin to receiver pin.
- **The drivers set the edge.** Without a source resistor the edge at the receiver, and any overshoot,
  depend on the driver alone:
  - PHY outputs: the IP101G pad drive registers on page 16 register 26, RXD0_DRIVE (bits 2:0),
    RXD1_DRIVE (bits 5:3) and RXDV_DRIVE (bits 14:12, the RXDV/CRS_DV pad), default 3'b001 =
    3.24 mA, settable from 1.62 to 22.68 mA (p.39–40).
  - MAC outputs: the P4 pad drive strength, 20 mA by default (ESP32-P4 datasheet p.17 note 3), up to
    IOH 40 mA at PAD_DRIVER = 3 (Table 5-4 p.89).
  - Neither datasheet gives an edge rate or an output impedance (no IBIS model), so overshoot and
    ringing at the receivers are a first-board check ([First-board checks](#first-board-checks)).
    Remedies, without a board change: lower RXD0/RXD1/RXDV_DRIVE on the PHY, a lower pad drive on
    the P4.
- **Line lengths** are held by the [Timing](#timing) budget ([Data line lengths](#data-line-lengths)).
- **BOOT tap.** TXD0/TXD1 are also the P4's strapping pins GPIO34/GPIO35. The BOOT button through R39
  taps the TXD1 line where R36 used to sit ([mcu](mcu.md#reset-and-boot)); GPIO35 has only its
  internal pull-up. The branch to R39 is unterminated, so its round trip stays within a tenth of the
  fastest RMII edge: 2 × L × v ≤ 0.1 × 1 ns, with the 1 ns edge from RMII 1.2 §7.4.3, the factor of one
  tenth the project's heuristic for a stub that can be treated as lumped, and v the propagation delay per mm
  below ([REF_CLK branches](#ref_clk-branches)). No pad sits at the tap, so the `paths` entry "BOOT
  stub" measures U6.47 → tap → R39.1, longer than the branch itself; its limit therefore holds for
  the branch.

### REF_CLK branches

The datasheet asks for equal clock lengths to the PHY and the MAC (§6.1, p.56) but gives no
tolerance, so the difference between the two branches is kept as a note. The limit comes from signal
integrity, not from timing, and it is on the MAC branch:

- **Near-end ledge.** U1.10 sits near the source end of a source-terminated line. The incident edge
  reaches it after t_PHY, and the reflection from U6.68 after 2 × t_MAC + t_PHY, so its edge sits on
  a ledge for 2 × v × L_MAC, with L_MAC measured from the star at R13.2. No ledge forms while that
  round trip is no longer than the fastest RMII edge, 1 ns (RMII 1.2 §7.4.3): L_MAC ≤ 1 ns/(2 × v),
  with v ≈ 7.1 ps/mm as the conservative propagation delay (field-solver estimate for the MDI/RMII
  geometry, [layout](layout.md#impedance); F.Cu is faster). An allowance of 10 mm is
  reserved for the unpublished trace inside the P4 module and comes off L_MAC. The limit is the
  `paths` entry "REF_CLK MAC branch" (R13.2 → U6.68).
- **Timing.** RX/TX timing alone tolerates a far larger branch difference ([Timing](#timing)).

The clock is kept off the data lines (§6.1, "avoid signals path parallel to clock signals path"): it
shares only short stretches with CRS_DV and TXD0, and its longest close neighbour is the +3V3 trunk.
GND return vias sit at the RMII layer changes wherever one fits
([layout](layout.md#ethernet-and-poe-isolation)).

### Data line lengths

The data lines, driver pin to receiver pin, are limited by the `lengthGroups` entry "RMII data lines"
(RXD0, RXD1, CRS_DV, TXD0, TXD1, TX_EN, each measured whole). Its derivation is the
[Timing](#timing) budget below.

TI SNLA387's 50 mil matching inside the RX and TX groups is a generic checklist value. The timing
below gives no matching need: that skew is picoseconds against margins of nanoseconds. So the lines
are not meandered.

### Timing

Inputs:

- IP101G (Tables 18/19, p.61; measured with the PHY's own 50M_CLKO clock, as here):
  - TX setup Ts ≥ 4 ns and hold Th ≥ 2 ns at 50M_CLKI;
  - RX output delay Td 6–13 ns at VDDIO 3.3 V;
  - clock period T = 20 ns ± 50 ppm.
- P4 MAC: setup, hold and output delay are **not published**. The ESP32-P4 datasheet v0.7, TRM
  chapter 55 and the hardware design guidelines §1.3.14 were searched. The RMII 1.2 figures (§7.4:
  Tsu 4 ns, Thold 2 ns) are assumed for its inputs.
- Board: Δ = clock arrival at U6.68 minus at U1.10 = v × (L_MAC − L_PHY), with L_PHY and L_MAC the
  R13.2 → U1.10 and R13.2 → U6.68 lengths and v as above.

| Path | Formula | Board input |
|---|---|---|
| RX setup (PHY → MAC) | T + Δ − Td,max − t_flight − Tsu | longest RX line |
| RX hold | Td,min + t_flight − Δ − Th | shortest RX line |
| TX setup (MAC → PHY) | T − Δ − Tco,max − t_flight − Ts | longest TX line |
| TX hold | Δ + Tco,min + t_flight − Th | shortest TX line |

The lines are found with `kicad_query`.

- RX has margin of nanoseconds on setup and hold.
- TX depends on the P4's output delay Tco. The board takes a budget of 5 % of the 20 ns period (a
  heuristic) for the MAC clock branch plus one TX line: (L_MAC,max + L_data,max) × v. That budget sets
  the `paths` entry "REF_CLK MAC branch" and the `lengthGroups` entry "RMII data lines". The
  routed board stays inside it.

**Open item: RMII TX timing.** The board can't be proven by calculation until Espressif publishes the
P4 EMAC's output delay. Also unknown are the IP101G's 50M_CLKO edge rate and output impedance (no
figure and no IBIS model; default drive 4.86 mA, page 4 register 22 bits 15:13 RXC_DRIVE, p.39) and the
trace lengths inside the Waveshare module. The first-board checks close this item. If a ledge shows on
U1.10, the remedies, in order:

1. raise RXC_DRIVE;
2. lengthen the PHY branch toward equal branches;
3. give each branch its own series resistor (a schematic change).

### MDC and MDIO

- MDC (GPIO31) and MDIO (GPIO52) reach the P4 through the GPIO matrix. R14, a pull-up to +3V3, pulls up
  MDIO alongside the pin's internal pull-up (p.16). MDC is always driven by the MAC and has no pull. R14
  is the same part as the strap resistors R1 and R10 (one BOM line; user decision 2026-11-09,
  replacing the SCCB pull-up part to lower the sink current). Whichever side drives MDIO low sinks
  (+3V3 max − VOL) / R14 at R14's low tolerance. R14 sets no edge rate: it only holds MDIO while
  neither side drives it (idle and the first turnaround bit of a read, which the MAC does not
  sample); every sampled bit is driven by the MAC or the PHY (inference from IEEE 802.3 clause 22
  framing; the IP101G and P4 documents don't state their MDIO driver type).
- **Levels.** The P4's outputs into the PHY (TXD0, TXD1, TX_EN, MDC, MDIO) guarantee only
  VOH ≥ 0.8 × VDD (ESP32-P4 datasheet Table 5-4 p.89) against the IP101G's VIH ≥ 0.8 × VDDIO (p.57),
  both on +3V3: no margin on paper. PHY_RST_N has its own RESETB threshold, 0.4–0.6 × VDDIO (p.57),
  with margin. The PHY's inputs are CMOS with µA loads, so the P4 output sits
  near its rail (inference: the P4 publishes no VOH-versus-current curve). The other way the PHY's
  VOH ≥ 0.9 × VDDIO and VOL ≤ 0.1 × VDDIO (p.57) clear the P4's VIH 0.75 × VDD and VIL 0.25 × VDD.
- MDC must stay at or below 3.33 MHz: period ≥ 300 ns, high and low ≥ 150 ns (Table 20, p.62). That is a
  firmware setting ([firmware-rules](firmware-rules.md#rules)).
- MDC and MDIO are slow signals, so length doesn't matter. Both cross under the crystal on B.Cu
  ([Crystal](#crystal)).

## Straps

The IP101G latches its straps when RESET_N rises (pp.16–18):

- Internal pull-downs are 104 kΩ and pull-ups 222 kΩ (p.12). The external straps R1 and R10 use the
  datasheet latch resistor, 5.1 kΩ (Table 13, p.58). PHY_AD3 and LEDMOD have no board resistor: R7
  and R9, which set them to 0 and 1, were removed (user decision 2026-11-11, board simplification;
  the PHY address stays 1, the LEDs take the PHY's default mode 1). Their internal pull-downs set
  both to 0 (p.17, p.18).
- VIH ≥ 0.8 × VDDIO at the bottom of the +3V3 ±5 % envelope (p.57). These strap checks apply at
  reset and use the generic ±5 % envelope, which is wider than the DC set point
  ([Rails](README.md#rails)).
- LED0 and LED3 are Hi-Z during reset (p.18), so only R1, LED3's internal pull-down and the LED paths
  set them. Both LED paths pull the same way as their strap.

| Strap | U1 pin | Set by | Level | Result |
|---|---|---|---|---|
| PHY_AD0 | 11 (LED0) | R1 to +3V3 (+ green LED to +3V3) | 1 | PHY address bit 0 = 1 |
| PHY_AD3 | 12 (LED3) | internal 104 kΩ pull-down only (+ yellow LED to GND) | 0 | PHY address bit 3 = 0 |
| | | | | **PHY address 1** (Table 4, p.47, 32-pin package) |
| COL/RMII | 4 | R10 to +3V3: V = VDD,min × 104 kΩ/(104 kΩ + R10) ≥ 0.8 × VDDIO | 1 | RMII mode (p.17) |
| CRS/LEDMOD | 20 | internal 104 kΩ pull-down only; U1.20 not connected | 0 | LED mode 1 (default): LED0 link, LED3 100 Mbit/s link and activity (Table 7, p.53) |
| FX_HEN (RXDV/CRS_DV) | 19 | internal 104 kΩ pull-down only; GPIO28 has no pull at reset | 0 | Twisted-pair (copper) mode (p.16, p.55) |
| RESET_N | 32 | internal 222 kΩ pull-up only; GPIO22 high impedance at reset | 1 from power-up | PHY runs from power-up; FW-11's pulse gives it the complete reset ([Reset](#reset)) |

- The firmware addresses the PHY at MDIO address 1.
- The firmware must not enable GPIO28's internal pull-up while RESET_N rises: it fights the 104 kΩ
  pull-down and can latch FX_HEN = 1 (fiber mode).

## Accepted risks

- **IP101G without a maker MSL or reflow statement** (JLCPCB lists MSL 3 from distributor data).
  User decision, 2026-10-31: "Keep IP101GRI, accept risk".
- **RMII TX timing unproven.** The P4 EMAC output delay is unpublished, so the 5 % board budget is a
  heuristic. The 50M_CLKO edge rate is unknown too, so the `paths` entry "REF_CLK MAC branch" rests on
  the 1 ns fastest-edge assumption. See the open item under [Timing](#timing).
- **No series terminations on the RMII data lines** (user decision 2026-11-11; R13 on REF_CLK stays,
  HDG §1.3.14). The edges reach the receivers as the drivers make them; overshoot is checked on the
  first boards and lowered with the drive registers ([RMII drive and termination](#rmii-drive-and-termination)).
- **MDI relies on auto-MDIX.** The pairs are crossed at J1, so a firmware that disables auto-MDIX
  without setting FORCE_MDIX gets no link.
- **MDI spacing inside U1's escape** falls short of the "three times space" (rule "MDI spacing"),
  forced by the 0.4 mm pitch; the rule area "U1 MDI escape" marks it.
- **MDI relies on the IP101G's polarity handling.** Both pairs are P/N-inverted between U1 and J1
  (user decision 2026-11-04, [MDI pairs crossed at J1](#mdi-pairs-crossed-at-j1)); the link partner
  also receives our transmit pair inverted.
- **Crystal without a guard trace**, with a +32V track and Q1's drain copper as the nearest other copper
  (`kicad_query distance`). Q1's drain copper may get hot at full LED scale ([led](led.md#thermal)), and
  Y1's ±20 ppm holds only to 85 °C. U1 is rated to 85 °C ambient (p.57).
- **ISET resistor beside the datasheet band.** R6's ±1 % band ends slightly above the 6.19 kΩ ±1 %
  the IP101G asks for (p.53), shifting the transmit amplitude by the same small fraction (user
  decision 2026-11-09); the first-board link test covers it.
- **MDC and MDIO under the crystal** on B.Cu, behind both GND planes; MDC crosses X2 and runs along
  X1 only under U1.2's pad and stub ([Crystal](#crystal)).
- **P4 → PHY logic high at zero datasheet margin** (VOH and VIH both 0.8 × the shared rail); relies on
  the light CMOS load ([MDC and MDIO](#mdc-and-mdio)). The throughput and reset-order checks cover it.
- **Unequal crystal traces.** X1 runs round Y1 to its far-corner pin, X2 is short; the traces
  enclose a small loop over In1 GND (user decision 2026-11-03,
  [layout](layout.md#ethernet-and-poe-isolation)).
- **PHY_RST_N inside the LED ring**, close to the ring pads over part of its length; held only by
  the PHY's internal pull-up until the firmware drives it.
- **J1 lands close to a reflowed part** (C3), to be checked in the
  hand-soldering trial.
- **Shield tied straight to GND** (user decision 2026-11-09): cable-shield and ESD currents return
  through board GND, and a cable whose far end grounds its shield closes a ground loop.

## First-board checks

1. **Link at 10 and 100 Mbit/s, with both cable types.** Bring up a link at each speed (forced on the
   link partner, then auto-negotiated), once with a straight cable and once with a crossover cable.
   The auto-negotiated links must come up at full duplex at both speeds with both cables; a
   half-duplex result means the reversed link pulses weren't recognised. Read page 16 register 18
   each time: bit 9 (MDI/MDIX) must show both states across the two cables; bit 8 (POLARITY) must
   read 1 on the 10 Mbit/s links (the receive pair is inverted on purpose), and at 100 Mbit/s record
   its value.
2. **Throughput.** Run iperf at 100 Mbit/s full duplex in both directions with zero CRC errors on the
   link partner. This is the test for the RMII TX timing open item.
3. **REF_CLK.** Count the clock at R13: 50 MHz ± 50 ppm. Probe U1.10 and U6.68 for a ledge between
   0.2 and 0.8 × VDDIO on the edges. If one shows, use the remedies under
   [Timing](#timing).
4. **Straps and LEDs.** The PHY answers on MDIO address 1, the EMAC gets its clock in RMII mode, the
   green LED shows link, and the yellow LED lights at 100 Mbit/s only and blinks with traffic.
5. **Reset order.** With the firmware's reset pulse (PHY_RST_N low ≥ 10 ms, then released
   ≥ 2.5 ms before the EMAC starts, FW-11), Ethernet comes up on every boot, also after a power
   cycle and after a reset of the P4 alone (RESET button).
6. **LED interference.** Run the LEDs at 0.5 ms, 120 fps. Scope TP1: PHY_RST_N stays above
   0.6 × VDDIO. Watch the link: it never drops while the LEDs pulse.
7. **Temperatures.** In the LED thermal test (0.5 ms, 120 fps, 30 min, 30 °C ambient), put
   thermocouples on Y1 and U1 too. Accept if Y1 stays at least 5 °C under its 85 °C rating (Epson
   TSX-3225 p.1) and REF_CLK stays within ± 50 ppm; if not, lower the LED current or duty, or pull
   the east edge of the Q1 drain copper on B.Cu back from Y1
   ([layout](layout.md#thermal)).
8. **J1 hand soldering.** After soldering J1 as its assembly note says, inspect C3 for
   bridges and a shifted part.
9. **PoE.** Bring up the link on PoE power from a mode A and a mode B source.
10. **REGOUT.** With the link up at 100 Mbit/s and traffic running, scope REGOUT at C6 (short ground
    spring to C6.2): it must stay inside 1.07–1.18 V, ripple included (IP101G DS p.57). The path from
    U1.28 to C6 runs through vias ([REGOUT and ISET](#regout-and-iset)).
11. **RMII edges.** With traffic running both ways at 100 Mbit/s, scope RXD0, RXD1 and CRS_DV at
    U6.40–U6.42 and TXD0, TXD1 and TX_EN at U1.9, U1.8 and U1.5 (short ground spring): overshoot
    and undershoot must stay within the receivers' input ratings (IP101G input −0.3 to 3.63 V, p.57;
    ESP32-P4 VIH max VDD + 0.3 V and VIL min −0.3 V, Table 5-4 p.89) and the ringing must settle before the
    sampling edge. If not, lower RXD0/RXD1/RXDV_DRIVE (page 16 register 26, p.40) on the PHY side or
    the P4 pad drive strength on the MAC side
    ([RMII drive and termination](#rmii-drive-and-termination)).
