azais-corentin/espion/docs/hardware/layout.md

# espion-cam board layout

How the board is built and why: outline, stack-up, fabrication and design rules, impedance, routing style, the
placement and routing intent of each block, assembly, and the check findings that are accepted on purpose. This page
holds the requirements, decisions, reasons and risks. It holds no coordinates, measured lengths, counts or rule values:
the KiCad files are the source for those.

| What | Where it lives |
|---|---|
| Parts, positions, tracks, vias, pours, rule areas | `hardware/espion-cam/espion-cam.kicad_pcb` (`kicad_query`) |
| Track widths, clearances, diff-pair geometry | the net classes in `espion-cam.kicad_pro` |
| Spacing and fab-limit rules | `espion-cam.kicad_dru` (`kicad_query rules`) |
| Board-setup minimums | the board setup in the `.kicad_pcb` |
| Measurable placement constraints | the `layout` section of `.omp/kicad.json` (`near`, `lengthGroups`, `paths`, `viaParity`, `copperArea`, `heightZones`), enforced by `kicad_check layout` |

Distances are copper edge to edge unless stated (pad edge to pad edge for parts), as `kicad_query distance` measures
them. Where a datasheet says "as close as possible", the `near` entry holds this project's heuristic limit for "close";
it is not a source value.

## Board and stack-up

### Outline and holes

| Item | Requirement | Reason |
|---|---|---|
| Outline | 64 × 64 mm, (100, 100)–(164, 164), corners r 1 mm | Smallest outline that fits the floorplan the user approved (user decisions 2026-10-31: 64 × 64 mm, J1 on the right, DP1435 on the left, J4 at an edge) |
| FFC notch | Top edge, 18 mm wide, 3 mm deep, centred on the lens axis, inner corners rounded | The camera FFC wraps round the top edge into J4 (user decision 2026-10-31: "J4 at an edge", no slot); a 16 mm cable has 1 mm each side |
| Lens cutout | Ø16 mm round cutout; lens axis at (129.7, 130.3) | The camera module sits behind the board (bottom side) with its lens on this axis; see [Camera and CSI-2](#camera-and-csi-2) |
| Mounting holes H1–H4 | M3, Ø3.2 mm plated, Ø6.4 mm GND pad, 3.5 mm in from both edges at the four corners; no via ring round the hole (the plated barrel joins the pads and planes) | User decision 2026-10-31: "4 × M3 corners"; via ring dropped for JLCDFM's via-to-PTH spacing (user decision 2026-11-10) |
| Tooling holes TOOL1–TOOL3 | Ø1.152 mm NPTH, 0.148 mm mask expansion, in three corners | Required for Economic PCBA; see [Assembly](#assembly) |
| Other NPTH | J1 and J2 locating pegs | Part datasheets |

M3 washer clearance: no copper other than GND within the ISO 7089 M3 washer radius (Ø7.0 mm, r 3.5 mm) plus 0.3 mm, so
r 3.8 mm, of a mounting hole's centre. Parts keep their courtyards outside it too. H1 is the tight one: the +3V3 loop
at J2's west shield pads runs closest to it, which is why that loop is routed where it is ([Power](#power)). H2–H4 were
first held to a larger r 4.6 mm radius clear of non-GND copper (an earlier design margin beyond the washer); H3 does not
keep that larger radius, and only r 3.8 mm is required.

The board carries "espion-cam" with its revision and `${ISSUE_DATE}` on the bottom silkscreen. The date text follows the
title block's date, which `kicad_edit` `set_board_setup {date}` sets to the release date before the fab output is made.
Below them, a "JLCJLCJLCJLC" text on the bottom silkscreen is where JLCPCB prints its order number (user decision
2026-11-09: placeholder rather than a paid removal or a spot of JLCPCB's choosing); the order sets "Mark on PCB" to
"Order number (specify position)".

### Stack-up

JLCPCB stack-up JLC04161H-7628, 4 layers, 1.6 mm, ENIG, green mask. Source: JLCPCB "Controlled Impedance PCB Layer
Stackup" (https://jlcpcb.com/impedance) and the impedance calculator (https://jlcpcb.com/pcb-impedance-calculator),
both read 2026-10-31. The dielectric and copper thicknesses are in the board's stack-up setup.

| Layer | Use on this board |
|---|---|
| F.Cu (L1, 1 oz) | Parts (all machine-placed parts), signals, power |
| In1.Cu (L2, 0.5 oz) | GND plane, except the PoE lane ([Ethernet and PoE isolation](#ethernet-and-poe-isolation)) |
| In2.Cu (L3, 0.5 oz) | Unbroken GND plane, no tracks |
| B.Cu (L4, 1 oz) | Bottom parts (U2, U6, J1), signals |

- Solder mask is LPI on both sides and covers every impedance-controlled track.
- JLCPCB's stack-up page labels the finished thickness below 1.6 mm; its capabilities page gives ± 10 %
  (read 2026-11-02). KiCad sums the layers a little above 1.6 mm.
- Why this stack-up: it is JLCPCB's default ("No requirement" on the order page), the only 4-layer 1.6 mm stack-up its
  calculator tags "Standard", it costs no stack-up fee, and Economic PCBA accepts "standard stack-up only"
  (https://jlcpcb.com/capabilities/pcb-assembly-capabilities, read 2026-10-31; JLCPCB does not publish which named
  stack-ups count as standard).
- The loss tangent in KiCad's stack-up is a placeholder; JLCPCB publishes none. It does not affect geometry.
- Via heights count in every length on this board (`use_height_for_length_calcs`).

## Fabrication rules

Board rules in the board setup and the custom rules, with the JLCPCB entry behind each. Source unless stated: JLCPCB PCB
capabilities, https://jlcpcb.com/capabilities/pcb-capabilities, read 2026-11-02 (4-layer, 1 oz outer, 0.5 oz inner; the
page gives no separate figures for 0.5 oz inner copper). The values are in the board setup or the named rule; read them
with `kicad_query rules` and `kicad_query stats`.

| Rule | Held by | JLCPCB entry | Notes |
|---|---|---|---|
| Minimum track width / clearance | Board-setup minimums | Multilayer 0.09 / 0.09 mm; pad to track 0.1 mm | Set slightly stricter than JLCPCB's multilayer minimum; the design's narrowest track and closest copper stay above it |
| Copper to board edge | Board-setup minimum | Routed edge 0.2 mm; PCBA FAQ part 2 (https://jlcpcb.com/help/article/pcb-assembly-faqs-part-2, read 2026-10-31): "edges of the traces and components must be more than 0.3mm away from the edge" (≈ 0.2 mm routing tolerance at depanelling) | Also the plane pull-back at the FFC notch and the lens cutout |
| Via size | Board-setup minimum | "0.2mm or 0.25mm hole size with via diameter less than 0.45mm, will cost more"; preferred minimum via hole 0.2 mm | Signal vias use the minimum; power and thermal vias are larger |
| Via annular ring | Board-setup minimum | "Via diameter should be 0.1mm(0.15mm preferred) larger than Via hole size" (0.05 / 0.075 mm ring) | The signal via's ring is above the minimum |
| Via types | Rule "Through vias only" | Microvias "only available for board thickness ≤1mm"; blind and buried vias are HDI only | |
| Hole to copper | Board-setup minimum; rule "PTH hole to copper" for through-hole pads | Via hole to track 0.2 mm; inner-layer PTH hole to copper 0.3 mm (PTH to track 0.28 mm minimum) | |
| Hole to hole | Board-setup minimum (DRC severity error); rule "Pad hole to hole" for pads | Via hole-to-hole 0.2 mm; pad hole-to-hole 0.45 mm | KiCad's hole-to-hole check skips milled (oval) holes, so J2's slots are not covered |
| PTH annular ring | Rule "PTH annular ring"; the board-setup minimum covers vias | ≥ 0.15 mm absolute (1 oz multilayer), 0.20 mm recommended | J2's shell slots sit exactly at the rule's limit (stock HRO land pattern), under JLCPCB's recommended ring |
| NPTH | Rules "NPTH hole size", "NPTH slot width" | Non-plated holes ≥ 0.50 mm; non-plated slots ≥ 1.0 mm | The board has no non-plated slot |
| Plated slot | Rule "Plated slot width" | "Multi-layer: 0.35mm" and "The minimum plated slot width is 0.5mm"; slot length at least 2 × its width | J2's shell slots are over twice as long as wide. The board setting `min_groove_width` is KiCad's creepage groove width, not a slot check |
| SMD pad to pad, different nets | The net classes; rule "U12 LGA pads" | 0.15 mm | |
| Minimum SMD pad | Rule "Minimum SMD pad"; user decision 2026-11-02: "Use 0.1mm×0.1mm for minimum pad size" | "Minimum SMD pad: 0.25mm × 0.25mm" (a note under SMD pad to pad clearance) | U1's and U4's QFN pads, the manufacturers' land patterns for 0.4 mm pitch, are under JLCPCB's note and kept; the same page makes 0.2–0.25 mm BGA pads with ENIG. Custom-shape pads (U1's corner anchors) are the smallest |
| Solder mask | Board setup (`solder_mask_min_width` and mask-to-copper) | "Pad size:soldermask opening can be 1:1"; keep 0.09 mm between openings and neighbouring traces; minimum pad spacing for a mask bridge 0.10 mm (green, 1 oz) | Openings 1:1 with pads; vias tented on both sides. KiCad flags and merges openings closer than the minimum web |
| Silkscreen | Rule "Silk line width"; text height and thickness (DRC severity error) | Line width ≥ 0.15 mm, text height ≥ 1.0 mm, width:height 1:6 preferred, pad to silkscreen 0.15 mm | All silk lines and texts are at the minimum; that stroke on 1.0 mm text is slightly thinner than the preferred 1:6. The board's defaults for new silk items (Board Setup › Text & Graphics) are still below the minimum, so set new items by hand |
| Silk clearance | Board-setup edge clearance; rules "Board silk to pads" and "Silk to silk" | Pad to silkscreen 0.15 mm; no silkscreen-to-silkscreen figure | See below |
| Tolerances | | Track width ± 20 %, board thickness ± 10 %, hole position ± 0.075 mm, plated holes +0.13 / −0.08 mm | Width tolerance drives [Impedance](#impedance) |

Vias next to pads: the quote page turns "tented" into "plugged" for free, but JLCPCB plugs a via with ink only if it
is ≥ 0.35 mm from any pad opening (https://jlcpcb.com/help/article/pcb-via-covering). Signal, power and decoupling vias
are never placed in pads. Where a via must sit closer than that, its drilled hole stays outside the pad opening by at
least the mask bridge (`solder_mask_min_width`); the vias that do this (C15.2, C37.2, C40.2/U11.2, U6.55 beside C47.2 and
C6.2) are GND vias on the same net as the pad.

A via beside a pad of its own net, but not touching it, keeps a copper gap of at least 0.1 mm to that pad (user
decision 2026-11-10). JLCDFM flags a narrower gap under pad spacing and via to pad: it may not etch, and the sliver
left between the pad opening and the tented via is too thin. Three vias don't keep it, because no site nearby holds
the clearances: C18.2's, held in by a USB_C_D_P B.Cu track and the copper round it; the GND via shared by U9.1 and
U6.27 (B.Cu), which the MIPI_CSI spacing to U6.28 and R56.1 (LED_EN) hold in place; and the C40.2/U11.2 via above.

Thermal vias are the exception: they sit inside the pads they cool, open (unfilled, unplugged) on the pad side and tented
on the far side. They are in U1's exposed pad (GND) and U10's exposed pad (GND; TPS61170 DRV0006A land pattern p.35 draws
them there). Solder paste over them can wick into the holes and leave voids under the pad; that is
accepted (user decision 2026-11-03: "Accept and document"): no windowpane paste, no filled and capped vias. Inspect those
two joints on the first boards ([Assembly](#assembly)). Q1's thermal vias sit in its drain pour beside the pad, not in it.

Silk against pads: KiCad 10's `min_silk_clearance` board setting covers silk to silk and silk to the board edge, and checks
silk against pads only for overlap on the mask layer; a custom `silk_clearance` rule covers more. Rule "Board silk to
pads" holds board-level silk (texts, marks) clear of pads. Footprint silk is exempt: the stock silk stays where it is
closer (0402 resistor and capacitor outlines to their own pads, test-point rings, J4's outline to its mounting pad);
JLCPCB clips legend at pads (user decision 2026-11-02: "Keep stock silk, JLC clips it") and at holes, so stock silk
over tented vias stays too (user decision 2026-11-10). Polarity marks inside
footprints are held ≥ 0.15 mm (JLCPCB pad to silkscreen) from pads by hand ([Assembly](#assembly)). Because JLCPCB gives no silk-to-silk figure, the rule
"Silk to silk" lets two silk items touch; without it, widening the stock silk to JLCPCB's minimum line width put
neighbouring 0402/SOT outlines closer than KiCad's silk clearance, and KiCad would flag every pair.

## Net classes

Track widths and diff-pair geometry come from the net classes in `espion-cam.kicad_pro`; the spacing that depends on what
is next to a net is in [Custom rules](#custom-rules). Where a width is sized for current, the temperature rise uses
Brooks & Adam's curve fit to the IPC-2152 data for an external layer, as coded in KiCad's source
(`track_width_calculations.cpp`, coefficients `EXTERNAL_COEFFS {215.3, 2.0, −1.15, −1.0}`,
https://docs.kicad.org/doxygen/track__width_calculations_8cpp_source.html, read 2026-11-01): ΔT = 215.3 · I² · W^−1.15 ·
Th^−1, W and Th in mil, ΔT in °C. (The released KiCad 9 track-width calculator uses IPC-2221 instead, which gives lower
rises; the fit is the more conservative of the two.)

| Class | Nets | Reason |
|---|---|---|
| Default | Every signal net not listed below | Robust, yet narrow enough to enter 0.4–0.5 mm pitch pins after a short neck |
| PWR_3V3 | +3V3 | Espressif ESP32-P4 Hardware Design Guidelines (HDG) §1.4.1: module supply "at least 25 mil"; temperature rise at the +3V3 load current by the fit above |
| PWR_5V | +5V, VBUS, +5V_POE | Sized for the DP1435's 2.6 A maximum output, which the fit above keeps within a reasonable rise ([power](power.md#5v-loads)) |
| LED_PWR | +32V, LED_K, ISNS, RING_1–RING_11 | Worst-case LED pulses ([led](led.md#current-sink)); the boost output is high enough that exposed pads need extra spacing (rule "LED_PWR pad spacing") |
| POE_CABLE | POE_VA1, POE_VA2, POE_VB1, POE_VB2 | Centre-tap current 350 mA (HanRun HR871150C p.1); routed on In1 only (0.5 oz), so the width is chosen for that copper ([PoE isolation](#poe-isolation)); extra spacing from rule "PoE isolation" |
| MIPI_CSI | CSI_* pairs | 100 Ω differential ([Impedance](#impedance)); spacing from rules "MIPI_CSI spacing" and "MIPI_CSI to clocks and high-speed" |
| MDI | ETH_TD_P/N, ETH_RD_P/N | 100 Ω differential; spacing from rules "MDI spacing" and "MDI pair to pair" |
| USB | USB_C_D_P/N (connector side), USB_D_P/N (module side) | 90 Ω differential (HDG §1.4.3) |

Tracks narrower than their class are allowed only where a reason is recorded; every such case is in
[Accepted deviations](#accepted-deviations).

## Custom rules

The `.kicad_dru` rules (`kicad_query rules`; the clearances, skews and sizes are in the file), with the purpose and
source of each. The JLCPCB fabrication rules are described in [Fabrication rules](#fabrication-rules).

| Rule | Applies to | Purpose | Reason and source |
|---|---|---|---|
| MIPI_CSI spacing | MIPI_CSI copper against everything except its own partner | Clearance of 2W | HDG, PCB layout, MIPI: "maintain a minimum spacing of 2W between MIPI trace pairs". Keeps the GND pours 2W away too, which the 100 Ω geometry assumes |
| MDI spacing | MDI copper against non-MDI copper | Clearance of 3W | IP101G datasheet §6.2 p.56 "three times space". Exempt: MDI items touching U1's courtyard or lying wholly inside the F.Cu rule area "U1 MDI escape", where U1's 0.4 mm pitch puts pins 25 (ISET), 28 (REGOUT) and 31 (AVDD33) next to the MDI pads ([Ethernet and PoE isolation](#ethernet-and-poe-isolation)). A segment crossing the area edge is not exempt |
| PoE isolation | POE_CABLE copper against other nets, same layer | Same-layer gap | Keeps the PoE cable side (J1's centre taps to U2.1–U2.4) apart from the rest of the board. The layout is meant to give some isolation only; no isolation level is rated or tested (user decision 2026-11-02). The gap is a chosen value. Pad pairs inside J1 exempt: that pin field is the jack's own (HanRun HR871150C p.1 rates it 2250 V dc, cable side to chip side). Copper across layers is not checked by KiCad: see [PoE isolation](#poe-isolation) |
| MIPI_CSI intra-pair skew | Each MIPI_CSI pair | Maximum P/N skew | HDG §1.4.6 allows 10 mil P/N skew per lane; a lane is one pair from U6 to J4 |
| U12 LGA pads | Pad pairs inside U12 | Clearance between neighbouring pads | MSA3S02 land pattern keeps JLCPCB's SMD pad-to-pad minimum between different-net pads (corner lands shortened at their inner end for it); JLCPCB's mask bridge sets the lower bound |
| LED_PWR pad spacing | An exposed pad of LED_PWR or BST_SW against any other net (not POE_CABLE or MDI, which have stricter rules) | Pad clearance for the boost voltage | IPC-2221A Table 6-1, 31–50 V row: A6 (external component terminations, uncoated) for exposed pads; B4 (solder mask) 0.13 mm, so mask-covered tracks keep the class clearance. Exempt: pad pairs inside U10 (TI land pattern) and inside each LED D4–D15 (one forward voltage apart) |
| MIPI_CSI to clocks and high-speed | MIPI_CSI against USB, MDI, every /Ethernet/RMII_* net, XVS/XVS_CAM and STROBE/STROBE_CAM | Clearance of 3W | Espressif ESP32-P4 HDG, MIPI PCB layout: 3W from other high-speed and fast signals; includes both sides of the XVS series resistor R40 and of the STROBE buffer U7, and all RMII nets, with no exemptions |
| PTH hole to copper | Through-hole pads | Hole clearance | JLCPCB inner-layer PTH hole to copper 0.3 mm (PTH to track 0.28 mm minimum) |
| Pad hole to hole | Pad against pad | Hole to hole | JLCPCB pad hole-to-hole spacing 0.45 mm (vias: 0.2 mm, the board minimum) |
| Power neck-down at fine-pitch pads | PWR_5V and LED_PWR tracks touching the courtyard of U4 or U10 | Minimum track width | A class-width track cannot enter U4's fine-pitch pads (0.3 mm gaps, TI TPS2121 land pattern p.39) or U10's WSON pads (TPS61170 DRV0006A, p.35) at the class clearance; the neck is short enough that its resistance and heat are negligible ([Power](#power)) |
| LED_PWR pad spacing (other pads) | An exposed pad of any other net against LED_PWR or BST_SW copper (tracks and vias included) | Pad clearance, mirrored | The mirror of "LED_PWR pad spacing", which only fires when the exposed pad is the LED_PWR item; same IPC-2221A source. Exempt: U10's own pads against BST_SW copper inside U10's courtyard (pin 4's exit keeps TI's DRV0006A land gaps, 0.35 mm to pin 5 and 0.25 mm to the exposed pad) and ISNS_K against ISNS (the Kelvin tap through net tie NT1, same node, small drop) |
| Silk to silk | Two non-pad items on the same silk layer | Silk clearance of zero | JLCPCB gives no silkscreen-to-silkscreen spacing; see [Fabrication rules](#fabrication-rules) |
| MDI pair to pair | RD pair (ETH_RD_P/N) against TD pair (ETH_TD_P/N); same U1 exemption as "MDI spacing" (either item touching U1's courtyard or wholly inside "U1 MDI escape") | Clearance of 3W | IP101G §6.2 p.56 "three times space" also between the RX and TX pairs. The closest spot is the RD_P/TD_N diagonals west of R6, right at the limit (`kicad_query distance`); DRC passes |
| MDI intra-pair skew | Each MDI pair | Maximum P/N skew | TI SNLA387 p.2 "MDI Traces": length-match the two lines of a pair within 50 mil for 100BASE-TX |
| PTH annular ring | Plated through-hole pads | Annular width | JLCPCB absolute minimum for 1 oz multilayer (a larger ring is recommended) |
| Plated slot width | Plated pads with an oval hole | Hole size | JLCPCB "The minimum plated slot width is 0.5mm" (also "Multi-layer: 0.35mm") |
| NPTH hole size | Round non-plated holes | Hole size | JLCPCB "Min. Non-plated holes 0.50mm" |
| NPTH slot width | Non-plated oval holes | Hole size | JLCPCB "Min. Non-Plated Slots 1.0mm". A guard for future parts: the board has no non-plated slot, so nothing exercises it yet. Its condition joins the two tested ones of "NPTH hole size" (non-plated) and "Plated slot width" (oval hole) |
| Through vias only | Every via | Micro, blind and buried vias disallowed | JLCPCB: microvias only on boards ≤ 1 mm, blind/buried vias HDI only |
| Silk line width | Graphic items on F.SilkS / B.SilkS | Line width assertion | JLCPCB "Minimum Line Width ≥0.15mm"; KiCad has no board setting for it |
| Board silk to pads | Board-level silk (not in a footprint) against pads | Silk clearance | JLCPCB pad to silkscreen; footprint silk exempt by user decision ([Fabrication rules](#fabrication-rules)) |
| 0402 pour pads thermal | C17.1, R17.2 | Zone connection: thermal reliefs | Each is an 0402 with one pad inside a solid-connected local pour and the other on a thin track: a relief lets both pads heat alike in reflow (tombstoning; board review 2026-11-04). The other 0402s of the review are joined without a pour instead ([Ground and return](#ground-and-return)) |
| Minimum SMD pad | SMD pads | Size X and Y assertion | User decision 2026-11-02, below JLCPCB's note ([Fabrication rules](#fabrication-rules)). Custom-shape pads are checked on their anchor, which is smaller than the whole pad |

## Impedance

Method: JLCPCB's impedance calculator (https://jlcpcb.com/pcb-impedance-calculator, read 2026-10-31) for stack-up
JLC04161H-7628, cross-checked with an independent 2-D quasi-static field solver (trapezoidal 35 µm track with etch-back,
JLCPCB's conformal mask). Every pair runs on an outer layer over the adjacent GND plane: F.Cu over In1, B.Cu over In2
(both the same distance from their plane, so both give the same geometry). The width and gap in each net class come from
this method.

| Use | Net class | Target |
|---|---|---|
| MIPI_CSI, MDI | MIPI_CSI, MDI | 100 Ω ± 10 % (HDG, MIPI) |
| USB | USB | 90 Ω ± 10 % (HDG §1.4.3) |
| Single-ended reference | none | 50 Ω; not used: RMII is short and runs at the Default width |

- The geometry holds only with solder mask over the pairs and a solid GND plane on the adjacent layer;
  `return_path` checks the plane under every MIPI_CSI, MDI and USB track.
- Propagation delay per mm (v) for the timing budgets: see [ethernet](ethernet.md#timing).
- Where it matters: MIPI CSI-2 at its full lane rate ([camera](camera.md#csi-2-link)). USB full speed (12 Mbit/s, edges
  ≥ 4 ns) and 100BASE-TX MDI are electrically short on this board.
- No impedance control is ordered (user decision 2026-11-01: "No impedance control"). JLCPCB's ± 20 % width tolerance
  puts the MIPI pairs outside the HDG's ± 10 % at the width extremes (field solve at the extremes of width and gap); a
  ± 10 % width spread would stay inside it. Controlled impedance (± 10 %, about USD 33 more) was offered and declined;
  whether Economic PCBA accepts it on this stack-up is not known.
- First-board check: run the CSI link at full rate (2 lanes, 800 Mbit/s per lane) and count frame errors before the design is released
  ([camera](camera.md#csi-2-link)).

## Routing style

User instruction (2026-11-01, repeated 2026-11-02, exact): "For the routing, youre only allowed to 45° bends, except when
its impossible otherwise. Avoid 90° bends." Applied as:

- every straight track segment runs at a multiple of 45°; no arc tracks;
- every bend (a direction change between two consecutive segments of one net on one layer, with no via at the joint)
  is exactly 45°; a 90° direction change is two 45° bends whose 45° leg is at least the track width; no acute bends;
- T-junctions and track ends in pads or vias are not bends.

Pad and via entries (user instruction 2026-11-02, with example images):

- every track ends at the centre of the pad or via it joins, not at its edge;
- a track enters a round pad or a via radially, and a rectangular pad along one of the pad's axes, at right angles to the
  edge it crosses; its last bend lies outside the pad or via, at least max(0.2 × track width, 0.04 mm) beyond its copper;
- no acute angle between two tracks, or between a track and a pad edge;
- where power pins of one net sit close together, a pour joins them instead of several tracks
  ([Ground and return](#ground-and-return)).

Exceptions only where nothing else is possible, each recorded with location and reason: the LED ring links
([LED driver and ring](#led-driver-and-ring)) and the entries that placement blocks ([Pad entries](#pad-entries)).
Reaching a pad centre from a lane a few hundredths of a millimetre off can leave a short jog (two opposite 45° bends with
a diagonal shorter than the track width); the rules allow it.

Joints and stubs:

- every track end lies on a pad, a via, a pour of its net or exactly on another track's centreline (overlapping joints
  are rebuilt on the centreline; a 45° T keeps its angle);
- no track piece lies wholly inside one pad or via of its net with an end that joins nothing; the pours already join
  those pads and vias;
- collinear segments of one width are merged, except the U1.27 escape, whose split keeps the lower segment wholly inside
  "U1 MDI escape" as the "MDI spacing" exemption needs.

Hooks and detours (user instruction 2026-11-02, with example images of CC2 looping round J2's shield pad and XVS_CAM
hooking into TP8): a track runs from its pad or via toward where it goes, never leaving the other way and looping back,
and a via that only serves one stub sits on its pad's axis (or radial ray) so the stub is one straight segment. The
loops that stay are forced, each with its reason: U5.5 → C25.1 (round U5.4), C16.2's GND via (+5V, VBUS and +5V_POE
round it), the +5V EN feed into U3.1 (round C18.1),
+32V from C46.1 (MDC), LED_K_SENSE (round C48.2), PHY_RST_N (round R8.2's former pad: kept as
routed when R8 was removed, user decision 2026-11-11), RMII_REF_CLK on B.Cu
(+3V3), RMII_TX_EN (U6.67 drops south on B.Cu to its via, whose place U6's pad field forces, and comes back north-east
on F.Cu; kept when R37 was removed, user decision 2026-11-11), RMII_TXD1 (its via sits east of where the line turns
north and TXD0's via blocks the straight way up, so the F.Cu leg steps back west to the R39 tap before turning north;
kept when R36 was removed, user decision 2026-11-11), and the length-matched diff pairs.

The MDI pin escapes at U1 are 45°-only ([Ethernet and PoE isolation](#ethernet-and-poe-isolation)); the CSI bus crosses
its narrowest plane neck at 45° rather than the ideal 58° ([Camera and CSI-2](#camera-and-csi-2)).

## Power

Parts: U2 SDAPO DP1435-5V PoE PD module (bottom, west edge, hand-soldered), C13 bulk on +5V_POE, U4 TI TPS2121 power
mux, U3 TI TLV62569 3.3 V buck with L2. Circuit: [power](power.md).

### Placement constraints

TPS2121 (SLVSEA3F §11 p.33 "as close as possible", §12.2 layout example): `near` entries

| Pair | Reason |
|---|---|
| C15.1–U4.7 | IN1 bypass |
| C16.1–U4.2 | IN2 bypass |
| C20.1–U4.1 | OUT bypass |
| R22.1–U4.10 | R_ILM beside ILM, as the layout example draws it |

U4's periphery: OUT pins 1 and 8 tied straight across; C20 on the west OUT flare, C16 west, C15 east, C21 (SS) and
R22 straight north of U4.11/U4.10, the PR1 divider row (R18, R75, R19) south, and U4.3 (CP2) tied by a short track to
the GND of U4.4/U4.5.

C22 is `+5V` bulk, not a U4 bypass, and sits at the south of the west column, well away from U4. There was no top-side
site for it closer in when it was placed: the input filter (removed 2026-11-11) and C13 filled the west and north of U4,
the PR1 row and the boost stage the south, the LED ring the east. Its feed is a F.Cu track at the PWR_5V width from the
pour "C20/U4 +5V": west and down a 45° diagonal, through the site of the removed filter inductor, then into C22.1 (kept
as routed, user decision 2026-11-11: no footprint moves).

The west column runs C13 and C22 from north to south, with the empty sites of the removed filter parts (the π filter's
inductor and aluminium bulk, user decision 2026-11-11) north of C13 and between C13 and C22. C13's `+5V_POE` link to
its two vias is a track at the PWR_5V width.

TLV62569 buck loop (SLVSDG1C §10.1 p.13, Fig. 20; U3 is turned 180° against Fig. 20): `near` entries. Each `max` is the
placed distance rounded up, so the loop shape cannot drift.

| Pair | Reason |
|---|---|
| C10.1–U3.4 | Input capacitor's VIN end at VIN |
| C10.2–U3.5 | C10's GND end away from SW, beside the FB row where the GND copper and vias are |
| C18.2–U3.2 | Output capacitor's GND end at the GND pin (C2 in Fig. 20) |
| C18.1–L2.2 | Output capacitor's +3V3 end toward the inductor output |
| L2.1–U3.3 | Short SW node (two entries: the loop limit and the heuristic "close" limit) |
| R16.2–U3.5, R17.1–U3.5, C17.2–U3.5 | FB divider and feed-forward capacitor at FB |

C10 (the input capacitor) sits at VIN, in the role of the one input capacitor of TI's Fig. 20. The small extra input and
output capacitors C12 and C19 were removed (user decision 2026-11-11, board simplification).

### Vias at the mux

`copperArea` entries, counted on F.Cu near U4's pads (TPS2121 §12.1: vias under the input and output pins;
§12.2 p.33 draws two vias per IN pin and four on OUT; land pattern p.39 "VIA TYP" in pads 1, 2, 7, 8; one via per
ampere of input and output current):

| Entry | Net | Note |
|---|---|---|
| U4 IN1 vias | +5V_POE | |
| U4 IN2 vias | VBUS | |
| U4 OUT vias | +5V | Larger vias do not fit beside C15.2 or U4.9 at the class clearance |

U2.6 (through-hole, so on B.Cu as well) feeds the B.Cu `+5V_POE` trunk directly: a B.Cu track at the PWR_5V width runs
east past U2.5 and C11's GND via, then north onto the trunk (user decision 2026-11-11: it replaces the removed filter
inductor's path; a straight bridge across that inductor's pads would have crossed the `+5V` feed to C22 on F.Cu). C11
sits on U2.6 on F.Cu. C13 hangs off the trunk's west end through two power vias, a spur with no load current through
it.

### Track widths

Widths come from the net classes; this lists where a run is not at its class width, or is a pour, and why. Temperature
rises use the fit in [Net classes](#net-classes); the currents are in [power](power.md#5v-loads).

| Run | Width | Reason |
|---|---|---|
| +5V and +5V_POE trunks on F.Cu | PWR_5V class | Common +5V trunk carries the boost-limited and board-peak current; the DP1435 maximum bounds the class |
| +5V_POE B.Cu leg, from the U2.6 feed to U4's IN1 vias (and west of it the C13 spur to its vias) | Narrower than the class | The class width does not pass the VBUS IN2 via at U4 ([Accepted deviations](#accepted-deviations)) |
| +5V into U3: the B.Cu trunk ends at a via; the F.Cu pour "C10/U3 +5V" joins it, the via of the U11/R63 branch, C10.1 and U3.4 | Pour | Buck input peak |
| +5V B.Cu branch to R63/C44/U11 | Narrow | Only U11's supply and the R63 divider |
| +5V common node where the LED-supply switch was: the trunk vias and TP5.1 in the F.Cu pour "+5V pour 100", joined through a class-width track across the switch's site to the boost-input pour "U10/C36/L3 +5V" (user decision 2026-11-11); the B.Cu pour "+5V pour 105" brings the common trunk to the via pair | Pours | Boost and buck together, the highest +5V current |
| From "+5V pour 100" east to the buck trunk vias (pours "+5V pour 101"/"+5V pour 104" round them) and the B.Cu trunk toward U3.4 | Class width; narrower between the east via pair and leaving "+5V pour 100" | Buck branch peak only |
| +3V3 trunks | PWR_3V3 class | |
| Necks inside the U4 and U10 courtyards | The minimum of rule "Power neck-down at fine-pitch pads" | Short; their resistance and heat are negligible |
| Branches carrying no load current (enable pins, dividers, FB sense, op-amp supply, pull-up feeds, short stubs into pins) | Narrow | µA–mA |

The +3V3 feed to the north and west parts (U5, C25, J4.15 with C32, R41/R42, D1/C24) cannot take a shorter
route: the USB pair, the camera bundle, XVS and +5V_POE fence it on B.Cu, the PoE lane and U2 on F.Cu. It is fed from
the U3/U6 area by a B.Cu feed (narrowed beside a GND via), a loop along
the west edge and a F.Cu loop round J2's north side, narrow because it carries mA loads only (camera, D1, pull-ups).
Past H1 the loop drops east of J2's north-west shield pad and runs SW between the two west shield pads, then round the
south-west shield pad's top in short 45° steps, outside H1's washer clearance, with CC1 parallel on its south-east side.
There, between H1's washer clearance and that pad, both run as close as their clearances allow and the loop is narrowed
(the tightest gap on the board's top edge). The R41/R42 branch's B.Cu feed from the +3V3 via is wider
except beside CAM_IO1's former via (kept as routed when CAM_IO1 was removed, user decision 2026-11-11). The west-edge loop crosses the west column on B.Cu from a via north of the removed aluminium bulk's site down to
below C13 (routed when that 10 × 10 can left no F.Cu way past it; kept as routed when it was removed, user decision 2026-11-11), under U2's magnetics ([B.Cu under U2](#bcu-under-u2)). The
drop to J4.15 (the camera supply pin, straight on +3V3: no link, user decision 2026-11-11) follows from the network
resistance (`kicad_query copper`) and those loads.

### Ground and return

- In2 is one unbroken GND plane; In1 is GND everywhere except the PoE lane. Both pours: clearance raised by the custom
  rules near MIPI, MDI and PoE copper, thermal reliefs, islands removed.
- Local pours (on F.Cu and B.Cu, above the planes in priority) join power pins of one net that sit close together and
  carry the high-current nodes: BST_SW (U10.4, L3.2, D3.2), LED_K (Q1.3 with its thermal vias, D15.1) and ISNS (Q1.2, R69.1;
  NT1 keeps its Kelvin tap from R69.1, in a lobe of the pour that carries no load current). Each pour: clearance 0 (the
  class and custom rules still set the gap; KiCad fills to the larger), solid pad connection (no thermal reliefs),
  islands removed; names "<parts> <net>" or "<net> pour N". The In1/In2 planes keep their thermal reliefs.
- 0402 parts get no solid pour pad beside a thin-track pad (tombstoning): rule "0402 pour pads thermal" gives C17.1 and
  R17.2 reliefs; C21.2 and R22.2 join their shared GND via by two narrow tracks
  (no pour); R16.1 takes +3V3 from the trunk ending on it and a narrow neck from "C17/R16 +3V3", which stops clear of the
  pad.
- Where a rule is waived for parts' own pads, the pours are clipped to what the pads keep: "BST_SW pour 120" stays at the
  "LED_PWR pad spacing" distance off U10's other pads (pin 4 itself keeps TI's land gaps, 0.35 mm to pin 5 and 0.25 mm to the exposed pad), "U1 GND" keeps the exposed-pad
  distance off U1's MDI pins and "MDI spacing" off the MDI tracks. F.Cu pours keep the 1.0 mm sideways distance from the In1
  PoE copper ([PoE isolation](#poe-isolation), Across layers); "LED_K pour 121" stays clear of the crystal copper, so its edge
  stays the closest F.Cu LED_K copper to C2.1.
- Every decoupling capacitor's GND pad has a GND via within 1 mm, never in the pad: on its own short stub or through a
  GND pour that holds pad and via. The buck capacitors C10 and C18 and U3.2 share the F.Cu pour
  "C18/U3 GND" with their GND vias.
- U4.12 has its own GND via on a short F.Cu stub.
- `decoupling_placement` (decoupling capacitor ≤ 3 mm from its power pin, GND via ≤ 1 mm from its GND pad) is clean.

### B.Cu under U2

U2 is a bottom-side module; its flyback magnetics sit over a B.Cu box with no plane between them and the B.Cu tracks.
XVS's west run is kept out of it: B.Cu just west of the box, across on F.Cu behind the In1/In2 planes
([Ethernet and PoE isolation](#rmii)). What stays in the box on B.Cu, because the camera module area, the lens cutout
and the CSI bus leave no other way from J2 and J4 to U6: VBUS (the PWR_5V trunk), USB_C_D_P/N, CAM_EN, SCCB_SDA, a short XVS
hop, STATUS_LED, STROBE and a stub of SCCB_SCL (user decision 2026-11-04: "Partial + document"). Added on
2026-11-11 (user decision 2026-11-11): the module's own output, the B.Cu `+5V_POE` feed from U2.6 to the trunk at the
box's south end, the same net as the trunk already there. Added with the BOM
change of 2026-11-09 (user decision 2026-11-09: "Accept"): the +3V3 west-edge loop, a decoupled DC rail, runs on
B.Cu down the west column just east of XVS's west run. The aluminium bulk's larger can then closed its F.Cu way; the
loop stays as routed after that part was removed (user decision 2026-11-11: no rerouting beyond the removed parts'
copper), and west of it XVS's run and the board edge leave no B.Cu lane. First-board check
([power](power.md#first-board-checks) 9): at the PoE input's peak load (LEDs 0.5 ms / 120 fps, camera streaming,
Ethernet up), scope XVS and SCCB_SCL/SDA edges at J4 for ringing or extra edges, and run USB enumeration and a bulk
transfer; repeat on USB power alone as the reference.

## MCU and USB

Parts: U6 Waveshare ESP32-P4-Core module on the bottom, hand-soldered with the hand-solder footprint variant
([mcu](mcu.md#module)); J2 HRO TYPE-C-31-M-12 USB-C at the top edge; U5 SRV05-4 and D2 H7VHD3UA ESD protection at J2; SW1
(RESET) and SW2 (BOOT) on the bottom edge, locked like the other edge-bound parts (the enclosure reaches them there).
Circuit: [mcu](mcu.md).

### Placement constraints

`near` entries:

| Pair | Reason |
|---|---|
| C29.1–U6.75 | HDG §1.4.1: capacitor at the power entry (ESP_3V3) |
| R33.2–U6.1, C27.1–U6.1 | HDG §1.3.3: RC at CHIP_PU (ESP_EN), short trace |
| R31.2–U6.38, R32.2–U6.37 | HDG §1.3.12 / §1.4.3: USB series resistors at the chip end (D+ / D−) |
| C48.1–U6.19 | HDG §1.3.10: filter capacitor at an ADC pin (LED_K_SENSE). Smaller than the HDG's 0.1 µF, so the reading settles within an LED pulse ([led](led.md#led_k-sense)) |
| U5–J2.A6 | TI SLVA680A p.4: protection as near to the connector as design rules allow, short I/O tracks. The limit was raised when J2 moved out to its overhang: U5 cannot follow it north, D2's courtyard abuts it (user decision 2026-11-04: "Raise the limit") |
| D2.1–J2.A4, D2.1–J2.A9 | TI SLVA680A p.4: "place the TVS as near to the connector as design rules allow"; the limit reaches both VBUS pad pairs |
| `paths` "BOOT stub": U6.47 → R39.1 | The BOOT strap R39 hangs on the 50 MHz RMII_TXD1 line as an unterminated branch from a tap at the former R36 position; its round trip stays within a tenth of the fastest RMII edge: 2 × L × v ≤ 0.1 × 1 ns (the 1 ns edge from RMII 1.2 §7.4.3; the factor of one tenth is the project's heuristic for a stub that can be treated as lumped; v the propagation delay per mm, [ethernet](ethernet.md#ref_clk-branches)), rounded down to whole millimetres. No pad sits at the tap, so the entry measures driver → tap → R39.1, longer than the branch, and the bound holds for the branch |

C29 sits over U6.74–76, beside the +3V3 via pair that feeds pins 74–76 on B.Cu; its ground end joins U6.73's GND via on
F.Cu. BST_EN crosses the +3V3 trunk on B.Cu north of U6.76's pad and hops to F.Cu between two vias to pass the +3V3 B.Cu
feed.

GPIO assignments that moved to make the routing possible are listed in
[firmware rules](firmware-rules.md#gpio-changes-in-this-revision).

### USB

- J2 is locked and machine-placed at the top edge with its shell overhanging the edge by HRO's recommended amount: the
  board edge on the drawing's PCB EDGE line, 5.79 mm from the pegs (HRO drawing p.1), so a plug overmold seats fully
  (user decision 2026-11-04: "HRO recommended", "Keep machine-placed, add an order note"). That puts J2 closer to the
  routed edge than JLCPCB's ≥ 0.3 mm for components (PCBA FAQ part 2); the order carries a note ([Assembly](#assembly)).
  The footprint's silk stops short of that edge line (`hardware/lib/README.md`).
- Connector side (USB_C_D_P/N, J2 → U5 → R31/R32): narrow tracks, mostly uncoupled. Full speed is electrically short here
  (edge ≥ 4 ns), so width, coupling and skew don't matter; impedance is not controlled.
- Both lines flow through U5 (TI SLVA680A p.4: no stub between the TVS and the protected line). D+: J2.A6 → U5.6 on
  F.Cu (no via), a link under the package to U5.1 (SRV05-4 pins 1 and 6 are separate channels, R+O datasheet p.1; this
  link joins them), then a via off U5.1. D−: the J2 run comes up at a via just beside U5.4's pad; a F.Cu link runs under
  the package to U5.3 (pins 3 and 4 are separate channels too; this link joins them), and the run to R32 leaves U5.3
  through a via. Each of those vias has a GND return via beside it.
- Module side (USB_D_P/N, R31/R32 → U6.38/U6.37): short, one via each, sharing a GND return via (HDG §1.4.3: return vias at
  USB via transitions).
- USB vias near U5 stay the PoE-isolation gap away from the In1 PoE copper.
- USB_C_D_N's J2 branch leaves U5's pocket on B.Cu through a via; no GND via fits within 1 mm of it (D2, the VBUS link
  and the D+ track surround it), In2 is solid GND under it. USB_C_D_P's link to U5 crosses the In1 gap of the PoE lane,
  with In2 GND below. Both are accepted for full-speed edges ([Accepted deviations](#accepted-deviations)).
- VBUS: J2.A9/B4 (one pad, west) and a power via share the F.Cu pour "J2 VBUS"; a B.Cu link reaches a second via, and a
  narrow F.Cu stub runs from it into the centre of J2.A4/B9 (one pad, east). From there a F.Cu run goes south into D2.1's
  centre. The protected feed leaves inside D2.1's east side, bends 45°, then reaches a power via. A B.Cu return goes
  north, north-west, west and south-west; only there does the PWR_5V trunk start toward U4's IN2 via. Thus neither J2 VBUS
  contact bypasses D2.1's junction (TI SLVA680A p.4: flow-through TVS routing, no protected-line stub); D2.2's short GND
  via is unchanged. The narrow connector stub is the only exit between J2's pegs and pads ([Accepted deviations](#accepted-deviations)).
- U5.5 (clamp supply) reaches C25.1 on F.Cu; U5.2 has a GND via between the pin rows.
- CC1 and CC2 (Rd R25/R23): CC2 runs from R23.1 east under J2's pad row and 45° up into B5's centre. CC1 leaves A5
  north-west into the corridor between J2's west shield pads, then steps SW round the south-west shield pad, parallel to
  the +3V3 loop on its south-east side ([Power](#power)), down into R25.1.
  R23's GND pad joins J2's west shield pad through the pour "GND pour 96".

### Buttons and boot

- SW1 (RESET) and SW2 (BOOT) stay on the bottom edge (user decision 2026-11-01: "Keep on the bottom edge"); the enclosure
  must give access to both there. Labels "BOOT" and "RST" sit between them.
- BOOT_SW leaves SW2's west pin-1 pad westward on F.Cu directly to a via; SW2's two pin-1 pads keep their F.Cu link. The
  button has no clamp (user decision 2026-11-09: D16 removed, [mcu](mcu.md#reset-and-boot)). On B.Cu the net runs
  south-east, south, then east along the bottom edge below U6's bottom pad row, tented, with copper clear of the edge.

### Module pads

- U6's GND pads 20, 27, 34 and 55 have their own GND vias. U6.55's via touches C47.2's pad edge (same net; the REF_CLK
  F.Cu leaves no other spot), U6.27's via sits against U9.1 (same net).
- Top-side reflowed parts lie above U6's pads (C47, C50, U12 among them). U6 is soldered with an iron only, pad by
  pad, no hot air (user decision 2026-11-01: "Iron only, pad by pad"), so they are not reflowed again.

## Camera and CSI-2

Parts: J4 JUSHUO AFA07-S15FCA-00 (bottom-contact 15-way 1.0 mm FFC connector) at the notch, rotated 180°; the camera
module behind the board on the lens axis. Circuit and cable: [camera](camera.md); cable
orientation: [camera](camera.md#ffc-orientation).

### Keep-outs

Rule areas in the board file (`kicad_query` lists them with their regions):

| Rule area | Layers | Keeps out | Reason |
|---|---|---|---|
| Camera module | B.Cu | Footprints | Module 25 ± 0.2 × 23.86 ± 0.2 mm around the lens axis, FFC edge toward the notch (module drawing WX-1M-9281-79). U2's body face sits close to the module's west edge (it fits at the module tolerance); J1's body starts beyond its east edge |
| FFC lane | B.Cu | Footprints | The cable's path from the notch to the module edge (16 mm cable; width assumed, not on the drawing) |
| FFC notch | F.Cu, B.Cu | Tracks, vias, pours | Cable wrap at the edge |
| FFC notch inner | In1, In2 | Tracks, vias | Same; the In1/In2 GND pours run to the board-edge clearance (user decision 2026-11-01: "Pull planes to 0.3 mm") |
| Lens cutout | All copper | Tracks, vias, pads, pours, footprints | The Ø16 cutout plus margin; the planes end at the board-edge clearance from the cutout |
| CSI link vias south | F.Cu | Footprints | Keeps the CSI via field south of the former link row free (name from the links removed by user decision 2026-11-11) |
| CSI link vias north | F.Cu | Footprints | Keeps the J4-side via-2 corner free |

### Lens view cone

`heightZones` entry "lens view cone", centred on the lens axis. A top-side part h mm tall must keep its courtyard at
least r0 + slope · h from the lens axis, so it stays out of the lens's field of view:

- slope = tan(79.3° / 2) (lens view angle, module drawing);
- r0 = lens rim 2.5 mm + slope × 5.4 mm: the lens tip may sit up to 5.4 mm below the top face (user decision 2026-10-31:
  "Tip ≤ 5.4 mm below top face"; the module's front face is ≥ 2.1 mm behind the board because its FFC connector, 2.1 mm
  high, is on the lens face);
- bottom-side parts (U2, U6, J1) do not count;
- heights are the current parts' datasheet maxima, in the entry's `heights` map; a new part type needs a height there.

Every top part, the 12 ring LEDs included, passes; `layout` is clean.

### Lane order

The ESP32-P4 cannot remap CSI lanes or swap P/N (ESP32-P4 TRM v0.7 Register 42.2 p.2611, §42.5.3.2 p.2603), and the
camera's lane order at J4 differs from U6's:

- U6 pads west → east: D0_N, D0_P, CLK_P, CLK_N, D1_N, D1_P.
- J4 west → east: CLK_P (pin 9), CLK_N (8), D1_P (6), D1_N (5), D0_P (3), D0_N (2).

Each lane is one pair, CSI_*, from J4 to U6, with no series-resistor positions (user decision 2026-11-11, board
simplification; Espressif's HDG §1.3.15 recommends reserving them, [camera](camera.md#no-series-resistor-positions)).
The lanes pass in U6 order, west → east D0_N, D0_P, CLK_P, CLK_N, D1_N, D1_P, through a short straight F.Cu run where
the links stood (the former link row). The reordering is done on B.Cu between J4 and that row, without crossings:

- D1 runs north of J4's pads, east under J4 and back south into the row; the U-turn mirrors the pair, so P (west at J4)
  arrives east, as U6's order needs.
- CLK runs on F.Cu north under J4 to its vias; on B.Cu N wraps west of the P via to swap sides, then the pair runs east
  and south into the row.
- D0 goes south of J4's pads as a B.Cu serpentine (west and back); the U-turn mirrors the pair, so D0_N (east at J4)
  arrives west, as U6's order needs.

### Via fields and return vias

Via counts are equal within each pair (`viaParity` entry "CSI lanes", TI SPRAAR7J §3.9 p.12):

| Stretch | Vias per leg | Where |
|---|---|---|
| J4 → the former link row | The same on every leg | One under J4's body north of its pad, on the pad axis; one north of the row. The lane-order crossing happens on this stretch |
| The former link row → U6 | The same on every leg | One south of the row (D0_N's via is fed west from the row, because the PoE lane leaves no legal spot for its return via on the row's own axis) |

Every signal via has a GND through via within 1.0 mm centre to centre (`via_return` limit; the D0/D1 via-1s sit on J4's
pad axes; TI SPRAAR7J §3.9 p.12: a return via at each transition, p.8: stitching vias "within 200 mils" of the signal
vias). Neighbouring legs share one where the in-row spots are taken. The GND vias under J4 have F.Cu stubs to J4's GND
pads 10/7/4/1.

### CSI bus and the plane neck

The CSI legs run on B.Cu over In2 to U6.28–U6.33 as a three-pair bus, CLK between D0 and D1. Spacing: 2W to everything but
the partner, 3W to USB, MDI, all RMII, XVS/XVS_CAM and STROBE/STROBE_CAM (rules "MIPI_CSI spacing" and "MIPI_CSI to
clocks and high-speed"). The CLK pairs have no GND guard copper (HDG §1.4.6 p.28 asks for the MIPI CLK pair to be
surrounded by ground copper); a B.Cu guard each side would widen the bus and leave less room at the neck below (user
decision 2026-11-01: "Accept 2W, no guard").

The bus passes through a neck of the In2 reference between the lens plane edge and the antipad of J1.9. The neck is
narrower than TI SPRAAR7J p.9's 90 mil from bus to plane edge on each side asks for. Widening it would mean moving J1
(locked at the edge) or the lens and ring (approved floorplan). The bus crosses the neck at 45° (route rule) rather than
the ideal 58°, which costs a little more plane-edge distance on each side (user decision 2026-11-01: "Use 45°, accept
71.7 mil"; the ideal crossing gave more room).

At the FFC notch the In1/In2 planes end at the board-edge clearance. The pairs' B.Cu run under J4 keeps less than
SPRAAR7J p.9's 90 mil from that plane edge; the D1 pair is the one materially short (CSI_D1_P over a few millimetres of
its run under J4), the CLK pair is close to the limit. Meeting it needs a new crossing plan under J4. Accepted with the
user decision above.

The J1 antipads in In2 are voids, not plane edges, and SPRAAR7J p.9 asks for ≥ 1.5 W from voids. CSI_D1_P's via antipad
joins J1.3's ETH_CT void on In1 and In2 (the web between them is under the pour's minimum width, so it is not filled): the
leg leaves its via inside that void. Further on it passes J1.5's, J1.7's and J1.9's antipads at increasing distance.

The planes stay solid under J4's MIPI pads except where the MIPI via antipads reach under them, against TI
SPRAAR7J §3.10 p.13 ("voiding the SMD mounting pads of the reference plane by 100%"):

- J4's MIPI pads 2, 3, 5, 6, 8, 9: the via-1 antipads take a sliver off pads 2, 3, 5 and 6.
- Adjacent antipads join into one slot void along each via row.

The link pads went with the links (user decision 2026-11-11). The In1/In2 voids there are the antipads of the CSI vias
north and south of the former link row; they stay and serve those vias, and the straight F.Cu runs between them lie over
solid In1/In2.

The excess capacitance of a voided pad is estimated with the parallel-plate approximation C = ε₀ · Dk · backed area /
dielectric height (Dk and height of the 7628 prepreg in the stack-up), as the part of the pad that is still backed. The
effect is a reflection of a few percent at a 150 ps edge (rectangular-pad/circular-antipad estimate, not measured);
accepted at design review 2026-11-01, covered by the first-board CSI test.

### Lengths and skew

Tracks and gap come from net class MIPI_CSI. Skew compensation uses trapezoid bumps (45° legs, a flat ≥ 0.45 mm, ≥ 0.45 mm
of straight track between same-sense bends, no copper overlap), placed next to the mismatch, so the pad-to-pad copper
path equals the net length. Lengths count via heights; pad to pad equals net length on every MIPI net. Rule "MIPI_CSI
intra-pair skew" holds each pair; read the lengths with `kicad_query lengths`.

CSI_CLK_P takes up its length difference on F.Cu between J4 and its via by a detour north of CSI_CLK_N, so the pair runs
uncoupled there instead of coupled with bumps (user decision 2026-11-04: "Accept + record"; re-coupling needs trapezoid
bumps drawn in pcbnew; [Accepted deviations](#other-accepted-deviations)).

`lengthGroups` "CSI lanes": the pair-mean spread of the whole lanes, U6 to J4, stays within the HDG §1.4.6 pair-to-pair
limit (30 mil end to end).

### Other parts near the former link row

C3 (ETH_CT) ties its GND end to a GND via by a short F.Cu track; ETH_CT runs on F.Cu from C3.1 to J1.3. J4 is marked "1"
and "CONTACTS DOWN" on the top silk.

First-board check: full-rate CSI frame-error test ([Impedance](#impedance)); FFC fit, bend and insertion depth
([camera](camera.md#ffc-orientation)).

## Ethernet and PoE isolation

Parts: U1 IP101G PHY with its MDI pins north; J1 HanRun HR871150C MagJack on the bottom, rotated −90°, locked,
hand-soldered; Y1 25 MHz crystal; U2 PoE PD module. Circuit: [ethernet](ethernet.md), [power](power.md#poe-input).

### MDI

- U1 sits next to J1 so MDI is short (IP101G §6.2 p.56: keep vias out of MDI except "in close proximity to device"). MDI
  runs on F.Cu only, with no vias, from U1 up the east strip and diagonally between J1's pegs and LED pins to J1 pins 1,
  2, 4, 5.
- The two pairs are swapped at J1 so they reach it without crossing, and each pair is P/N-inverted on purpose so it runs
  straight (U1.30/29 → J1.5/4, U1.27/26 → J1.2/1; net names follow the J1 pin: U1.30 ETH_RD_N, U1.29 ETH_RD_P, U1.27
  ETH_TD_N, U1.26 ETH_TD_P). This relies on the PHY's auto-MDIX, which firmware must never disable, and on its
  polarity handling (IP101G p.27, register 18 bit 8 POLARITY; user decision 2026-11-04)
  ([ethernet](ethernet.md#magjack-and-mdi), [firmware rules](firmware-rules.md#rules)). The inversion needs no swap vias
  and no skew bumps on the N lines. Each pair jogs east once, at 45° as a coupled pair, onto the lanes of the diagonals
  toward J1. The U1.27 escape (ETH_TD_N) keeps its split so its lower segment stays wholly inside "U1 MDI escape".
- Spacing: MDI keeps 3W to other nets (rule "MDI spacing") and RD keeps 3W from TD edge to edge (rule "MDI pair to
  pair"; the closest spot is the RD_P/TD_N diagonals west of R6, right at the limit, which DRC passes). At U1's north
  row the 0.4 mm pitch makes 3W impossible: pins 25 (ISET), 28 (REGOUT) and 31 (AVDD33, +3V3) sit next to the MDI pads and
  their tracks leave between or beside the pairs. Each MDI pin escapes a short way north inside U1's courtyard, then
  45°-only inside the F.Cu rule area "U1 MDI escape", where the rule "MDI spacing" is waived. Inside it only U1's own pin
  nets come closer than 3W: the pads (land pattern), the REGOUT track and its via, ISET's vertical, +3V3, the PHY_RST_N via.
  Every MDI point outside the area meets the rule (DRC; closest are J1.14 and J1.13, then the GND via by TD_P's
  jog). This is a deviation from IP101G §6.2's "three times space", which has no exception.
- Lengths (`kicad_query lengths`, U1 pad → J1 pad, no vias; pad to pad equals the net length): each pair is matched
  within TI SNLA387 p.2's 50 mil for 100 Mbit/s, which the rule "MDI intra-pair skew" enforces. J1.1 and J1.5 sit further
  west than J1.2 and J1.4, so TD_P and RD_N have the longer way; TD_N and RD_P carry 45° trapezoid bumps next to the
  mismatch at J1.
- Return path: In1 GND lies under every MDI track except where the tails at J1.2/J1.4 cross J1's own MDI antipads;
  accepted ([Accepted deviations](#accepted-deviations)).
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
