azais-corentin/espion/docs/hardware/led.md

# LED driver and ring

The 850 nm ring lights the markers only while the camera exposes. The chain:
+5V feeds the boost directly, the boost makes +32V, the string of
12 LEDs runs from +32V into a linear current sink, and the sink's setpoint is on only while the
sensor's STROBE and the P4's `LED_EN` are both high and the STROBE pulse is younger than a
hardware timeout. Firmware runs the boost just above what the string needs, by PWM on `BST_EN`
and a reading of the sink's drain (`LED_K_SENSE`), so the sink drops only the headroom it needs
instead of everything between +32V and the string ([Headroom control](#headroom-control)).
Sheets: *LED driver* and *LED ring*. Every passive value, result and placement figure is in the
KiCad files; this page keeps the requirements, the formulas with their datasheet constants, the
decisions, the accepted risks and the checks.

| Block | Parts | Control (U6 pin) | Test point |
|---|---|---|---|
| [LED supply](#led-supply) | – (no switch) | – | – |
| [Boost converter](#boost-converter) | U10 TPS61170, L3, D3, C36, C39, C41, C43, C45, C46, C47, R62, R65, R66 | `BST_EN` GPIO53 (U6.71), PWM | TP13 `+32V` |
| [Current sink](#current-sink) | U11 TLV9061, Q1 HL2310A, R69, NT1, R60, R61, R63, R64, R67, R68, C40, C42, C44 | – | TP12 `LED_ON`, TP14 `ISNS` |
| [STROBE gating and timeout](#strobe-gating-and-timeout) | U9 SN74LVC1G97, C33, R55, R56, R58, C37 | `LED_EN` GPIO11 (U6.13), STROBE GPIO12 (U6.14) | TP11 `LED_EN`, TP9 `STB` |
| [LED ring](#led-ring) | D4–D15 A-SC880IR3C | – | – |
| Sense | R70, R76, C48 (`LED_K_SENSE`) | GPIO23 ADC1_CH7 (U6.19) | – |

The product limits that set every number below:

- **Pulse:** ≤ 0.5 ms per frame at ≤ 120 fps, so the LED duty is t_pulse × fps (user decision
  2026-10-31: "≤ 0.5 ms at ≤ 120 fps (6 %)").
- **Ambient:** 15–30 °C, indoor (user decision 2026-10-31).
- **LED current:** on the Amicc DC derating curve at the ambient maximum (user decision
  2026-10-31, [Current sink](#current-sink)).
- **USB power alone:** the LEDs stay off by a firmware rule, with no extra hardware gate
  (user decision 2026-10-31).

Firmware rules for this block are in [firmware-rules.md](firmware-rules.md#rules). Layout details
are in [layout.md](layout.md#led-driver-and-ring).

## LED supply

The boost input is `+5V` itself, with no switch (user decision 2026-11-11, board simplification:
the load switch, its input and slew capacitors and its pull-down were removed, and its `LED_PWR_EN`
GPIO with them). A boost converter has a DC path from input to output through L3 and D3 even while
it is not switching, so whenever the board is powered +32V idles at `+5V` minus D3's drop and the
output bank is charged to that through L3 and D3 at plug-in (the inrush is under U4's soft start,
[power](power.md#current-limit-and-soft-start)). The LED side is off by `BST_EN` (U10's internal
pull-down, [BST_EN](#bst_en)) and `LED_EN` (R56).

- **The string cannot conduct at idle.** Per LED the idle rail gives (V(`+5V`) − VF(D3)) / 12;
  the Amicc IF–VF curve (ADE-880-017 p.4 Fig. 3) shows nothing below 1 mA, which it reaches far
  above that voltage, so the string current there is negligible (an extrapolation of the curve:
  an inference). The string's 1 A minimum is 12 × VF min (p.3).
- **Standing current on +32V:** V(+32V) / (R65 + R66) through the feedback divider, plus the
  `LED_K_SENSE` divider's (V(+32V) − 12 × VF(µA)) / (R70 + R76) through the string, about zero at
  idle ([LED_K sense](#led_k-sense)).

### Boost input range

The LEDs run only on PoE (firmware rule), so the boost input range is the one on PoE:

| Rail | Formula |
|---|---|
| `+5V` on PoE | `+5V_POE` range ([Rails](README.md#rails)) minus the TPS2121 drop: RON ≤ 85 mΩ at 85 °C (TPS2121, SLVSEA3F p.7) × the board peak current ([power mux](power.md#power-mux)) |

During a PoE → USB switchover `+5V` dips to the power mux's minimum at U4 OUT for a moment
([power mux](power.md#power-mux)). The boost loses regulation then, and firmware shuts the LEDs
down on the same `PWR_SRC` edge.

### Enable order

The enable order is stated once, as **FW-7** in [firmware rules](firmware-rules.md#rules). This is
a summary of it. `PWR_SRC` comes from the [power mux](power.md#power-mux); low means USB.

**Power-up (on PoE only)**
1. `BST_EN` steady high.
2. Wait until the between-pulse `LED_K_SENSE` reading has left the zero band (the ADC error) and
   then stopped rising, or for the start-up time's upper bound
   ([Recovery and start-up](#recovery-and-start-up)). There is no +32V sense: the reading follows
   +32V minus the string's µA forward voltage ([LED_K sense](#led_k-sense)), so it stays at zero
   until +32V passes about 12 × VF at µA currents. A reading still in the zero band at the
   timeout is a fault: a dead boost and an open string look the same.
3. `LED_EN` pulses.

**Normal power-down**
1. `LED_EN` low.
2. `BST_EN` low. The TPS61170 shuts down only after CTRL has been low for more than 2.5 ms
   (SLVS789D p.5, §8.3.5 p.10). In PWM mode a shorter low only lowers the reference, through a
   180 µs filter (p.5, §8.4.2 p.11).

**`PWR_SRC` falling edge (PoE lost, now on USB), taken as an interrupt**
- `LED_EN` and `BST_EN` go low back to back, with no wait.
- With no switch on the boost input, `+5V` is VBUS after the switchover and does not collapse:
  USB carries the boost from the switchover until `BST_EN` drops, plus the 180 µs t_REF filter
  (§8.4.2 p.11, p.5), and the TPS61170 shuts down once CTRL has been low for t_off, more than
  2.5 ms (p.5, §8.3.5 p.10). Accepted ([power](power.md#accepted-risks)): `LED_EN` is already
  low, so no LED current flows.

Why this order (design reasoning, apart from the datasheet timings above):

- **`LED_EN` first:** no LED pulse starts while the supply is going away.
- **`LED_EN` only once +32V is up:** a pulse on a rail that is still rising does not have the
  string's headroom.

## Boost converter

U10 (TPS61170, TI SLVS789D) boosts `+5V` to +32V for the LED string. It has an integrated
40 V switch, runs at 1.2 MHz (1.0–1.5 MHz) and limits the switch current to 0.96–1.44 A (p.5).
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
