azais-corentin/espion/hardware/espion-cam/espion-cam.kicad_pcb

## KiCad design hardware/espion-cam/espion-cam.kicad_pcb (2026-11-11)

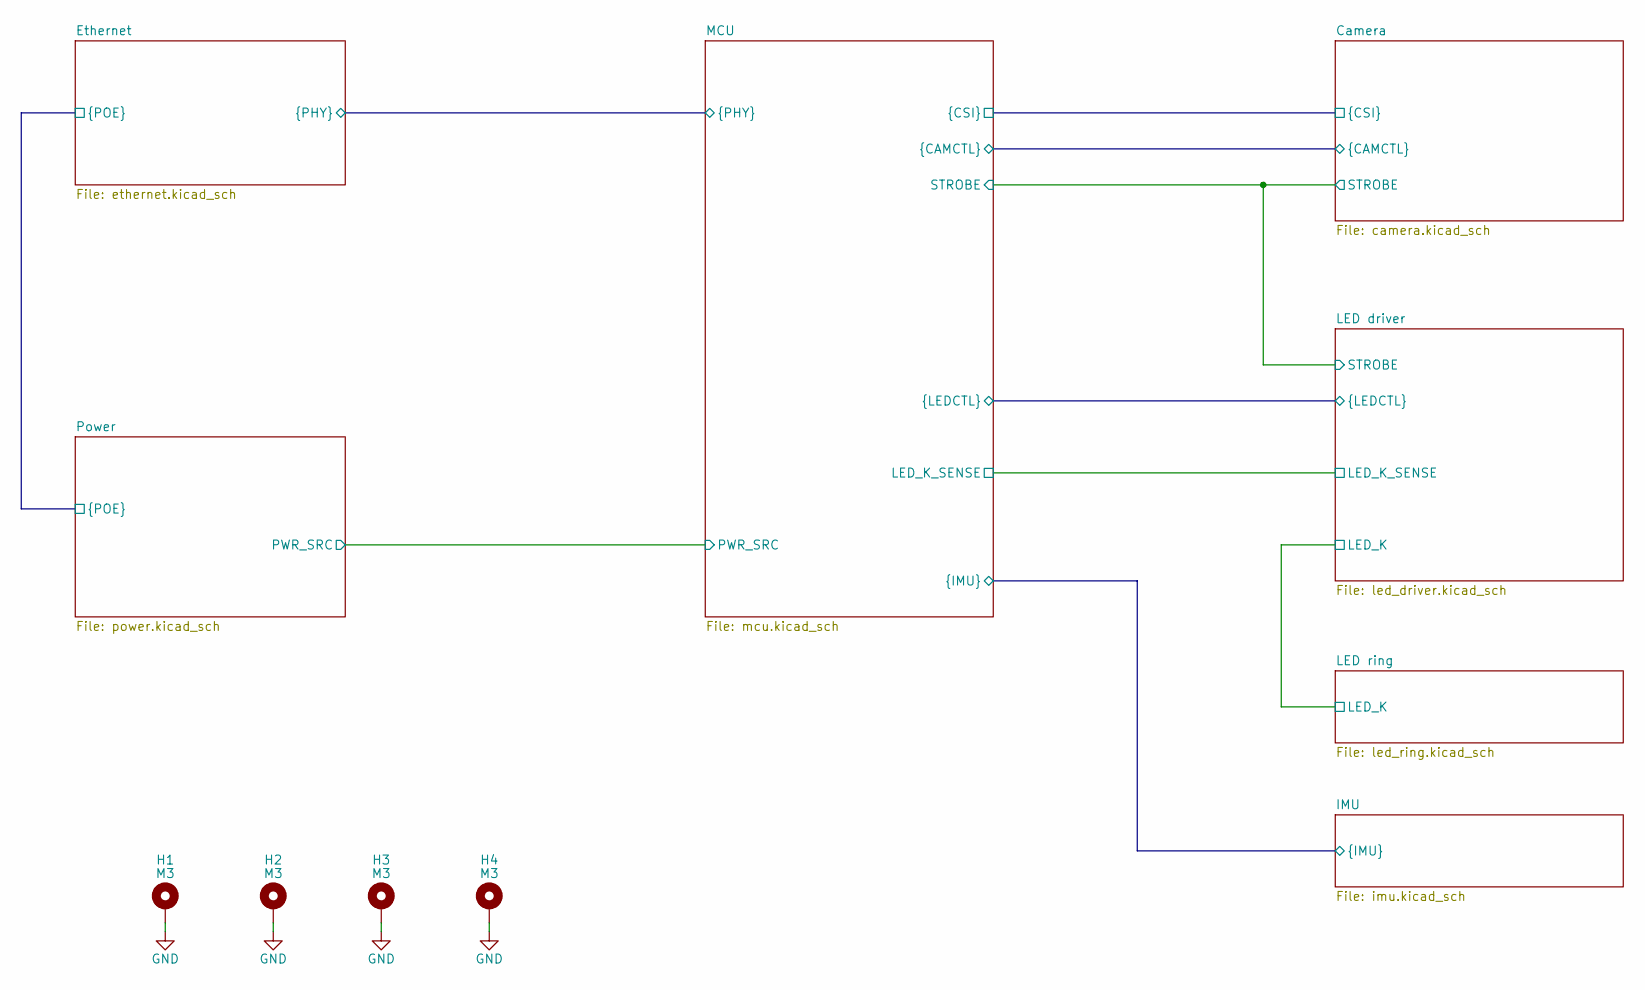
[picture p1: schematic espion-cam.kicad_sch]

Parts:
H1, H2, H3, H4: M3; MountingHole_3.2mm_M3_Pad

Connections:
GND: H1.1 (1_1), H2.1 (1_1), H3.1 (1_1), H4.1 (1_1); also elsewhere on the board

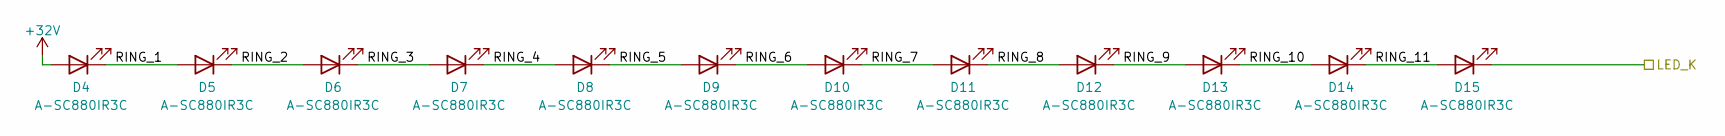
[picture p2: schematic led_ring.kicad_sch, espion-cam — LED ring]

Parts:
D4, D5, D6, D7, D8, D9, D10, D11, D12, D13, D14, D15: A-SC880IR3C; LED_Amicc_A-SC880IR3C_3.85x3.85mm; MPN A-SC880IR3C-P03-1T; LCSC C5355470

Connections:
+32V: D4.2 (A); also elsewhere on the board
/LED driver/LED_K: D15.1 (K); also elsewhere on the board
/LED ring/RING_1: D4.1 (K), D5.2 (A)
/LED ring/RING_2: D5.1 (K), D6.2 (A)
/LED ring/RING_3: D6.1 (K), D7.2 (A)
/LED ring/RING_4: D7.1 (K), D8.2 (A)
/LED ring/RING_5: D8.1 (K), D9.2 (A)
/LED ring/RING_6: D9.1 (K), D10.2 (A)
/LED ring/RING_7: D10.1 (K), D11.2 (A)
/LED ring/RING_8: D11.1 (K), D12.2 (A)
/LED ring/RING_9: D12.1 (K), D13.2 (A)
/LED ring/RING_10: D13.1 (K), D14.2 (A)
/LED ring/RING_11: D14.1 (K), D15.2 (A)

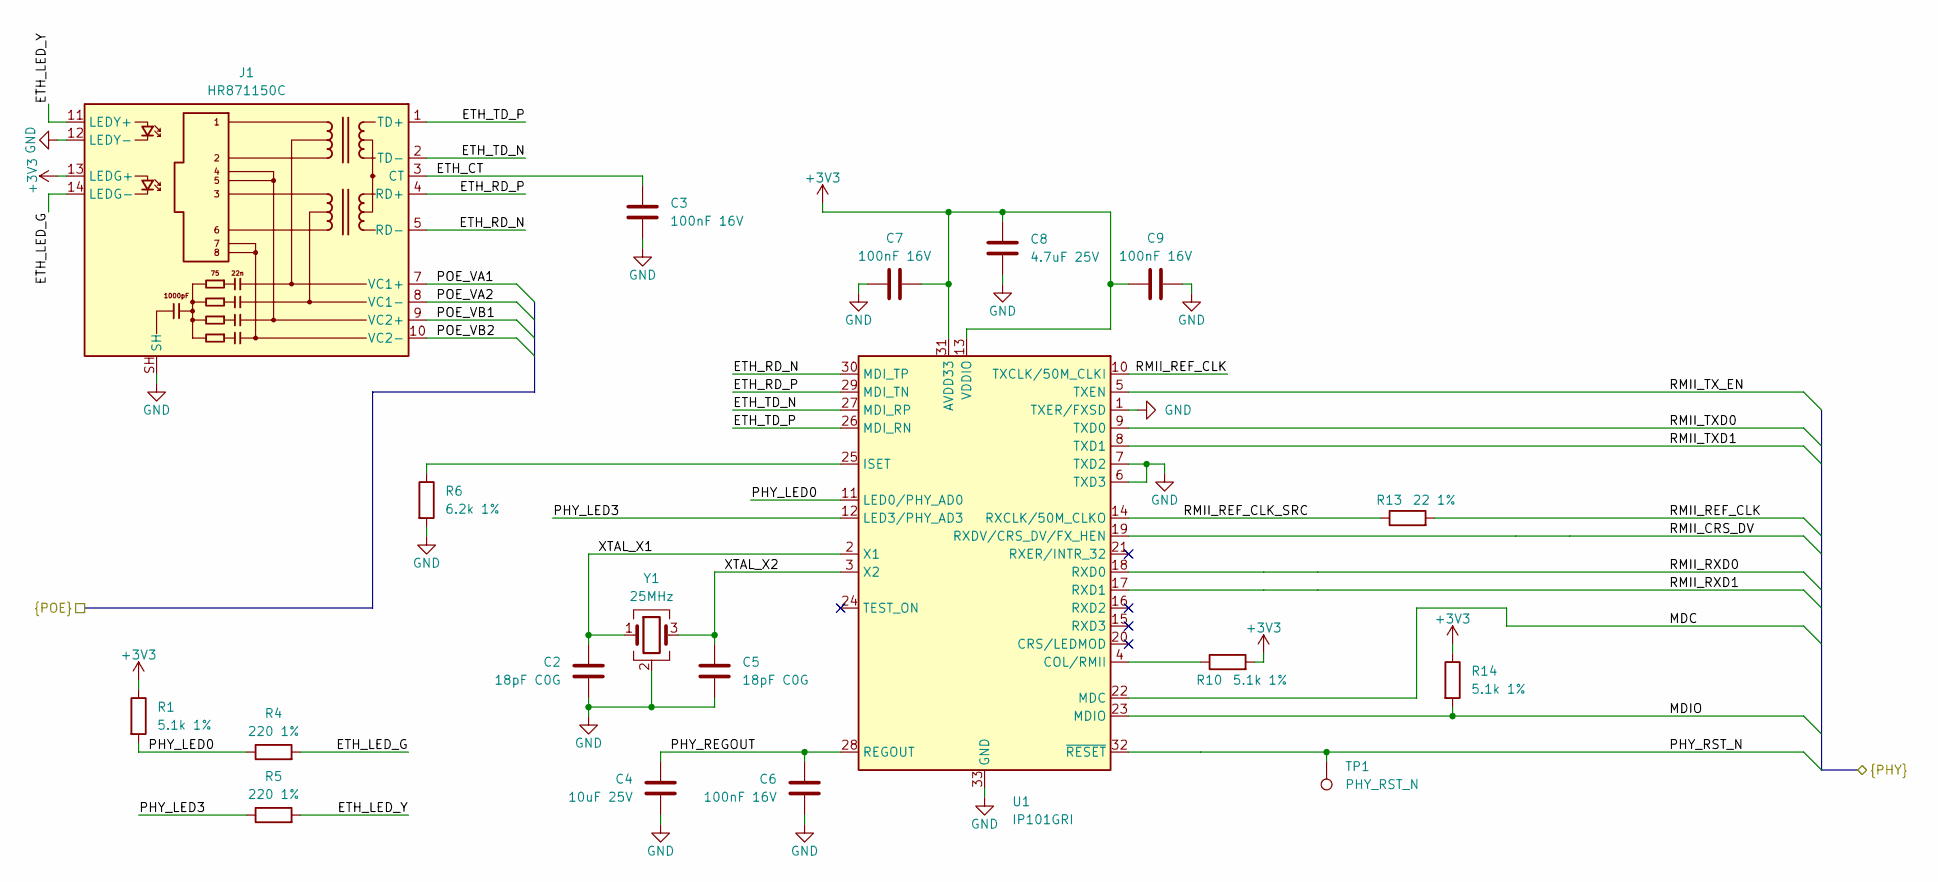
[picture p3: schematic ethernet.kicad_sch, espion-cam — Ethernet]

Parts:
C2, C5: 18pF C0G; C_0402_1005Metric; MPN 0402CG180J500NT; LCSC C1549
C3, C6, C7, C9: 100nF 16V; C_0402_1005Metric; MPN CL05B104KO5NNNC; LCSC C1525
C4: 10uF 25V; C_0805_2012Metric; MPN CL21A106KAYNNNE; LCSC C15850
C8: 4.7uF 25V; C_0805_2012Metric; MPN CL21A475KAQNNNE; LCSC C1779
J1: HR871150C; RJ45_HanRun_HR871150C_Horizontal; MPN HR871150C; LCSC C19724786
R1, R10, R14: 5.1k 1%; R_0402_1005Metric; MPN 0402WGF5101TCE; LCSC C25905
R4, R5: 220 1%; R_0402_1005Metric; MPN 0402WGF2200TCE; LCSC C25091
R6: 6.2k 1%; R_0603_1608Metric; MPN 0603WAF6201T5E; LCSC C4260
R13: 22 1%; R_0402_1005Metric; MPN 0402WGF220JTCE; LCSC C25092
TP1: PHY_RST_N; TestPoint_Pad_D1.0mm
U1: IP101GRI; QFN-32-1EP_4x4mm_P0.4mm_EP2.65x2.65mm; MPN IP101GRI; LCSC C703537
Y1: 25MHz; Crystal_SMD_3225-4Pin_3.2x2.5mm; MPN X1E0000210139; LCSC C91750

Connections:
+3V3: C7.1, C8.1, C9.1, J1.13 (LEDG+), R1.1, R10.2, R14.1, U1.13 (VDDIO), U1.31 (AVDD33); also elsewhere on the board
/Ethernet/ETH_CT: C3.1, J1.3 (CT)
/Ethernet/ETH_LED_G: J1.14 (LEDG-), R4.2
/Ethernet/ETH_LED_Y: J1.11 (LEDY+), R5.2
/Ethernet/ETH_RD_N: J1.5 (RD-), U1.30 (MDI_TP)
/Ethernet/ETH_RD_P: J1.4 (RD+), U1.29 (MDI_TN)
/Ethernet/ETH_TD_N: J1.2 (TD-), U1.27 (MDI_RP)
/Ethernet/ETH_TD_P: J1.1 (TD+), U1.26 (MDI_RN)
/Ethernet/MDC: U1.22 (MDC); also elsewhere on the board
/Ethernet/MDIO: R14.2, U1.23 (MDIO); also elsewhere on the board
/Ethernet/PHY_LED0: R1.2, R4.1, U1.11 (LED0/PHY_AD0)
/Ethernet/PHY_LED3: R5.1, U1.12 (LED3/PHY_AD3)
/Ethernet/PHY_REGOUT: C4.1, C6.1, U1.28 (REGOUT)
/Ethernet/PHY_RST_N: TP1.1 (1_1), U1.32 (~RESET); also elsewhere on the board
/Ethernet/POE_VA1: J1.7 (VC1+); also elsewhere on the board
/Ethernet/POE_VA2: J1.8 (VC1-); also elsewhere on the board
/Ethernet/POE_VB1: J1.9 (VC2+); also elsewhere on the board
/Ethernet/POE_VB2: J1.10 (VC2-); also elsewhere on the board
/Ethernet/RMII_CRS_DV: U1.19 (RXDV/CRS_DV/FX_HEN); also elsewhere on the board
/Ethernet/RMII_REF_CLK: R13.2, U1.10 (TXCLK/50M_CLKI); also elsewhere on the board
/Ethernet/RMII_REF_CLK_SRC: R13.1, U1.14 (RXCLK/50M_CLKO)
/Ethernet/RMII_RXD0: U1.18 (RXD0); also elsewhere on the board
/Ethernet/RMII_RXD1: U1.17 (RXD1); also elsewhere on the board
/Ethernet/RMII_TXD0: U1.9 (TXD0); also elsewhere on the board
/Ethernet/RMII_TXD1: U1.8 (TXD1); also elsewhere on the board
/Ethernet/RMII_TX_EN: U1.5 (TXEN); also elsewhere on the board
/Ethernet/XTAL_X1: C2.1, U1.2 (X1), Y1.1
/Ethernet/XTAL_X2: C5.1, U1.3 (X2), Y1.3
GND: C2.2, C3.2, C4.2, C5.2, C6.2, C7.2, C8.2, C9.2, J1.12 (LEDY-), J1.SH, R6.2, U1.1 (TXER/FXSD), U1.6 (TXD3), U1.7 (TXD2), U1.33 (GND), Y1.2 (G), Y1.4 (G); also elsewhere on the board
unnamed: R10.1, U1.4 (COL/RMII)
unnamed: R6.1, U1.25 (ISET)

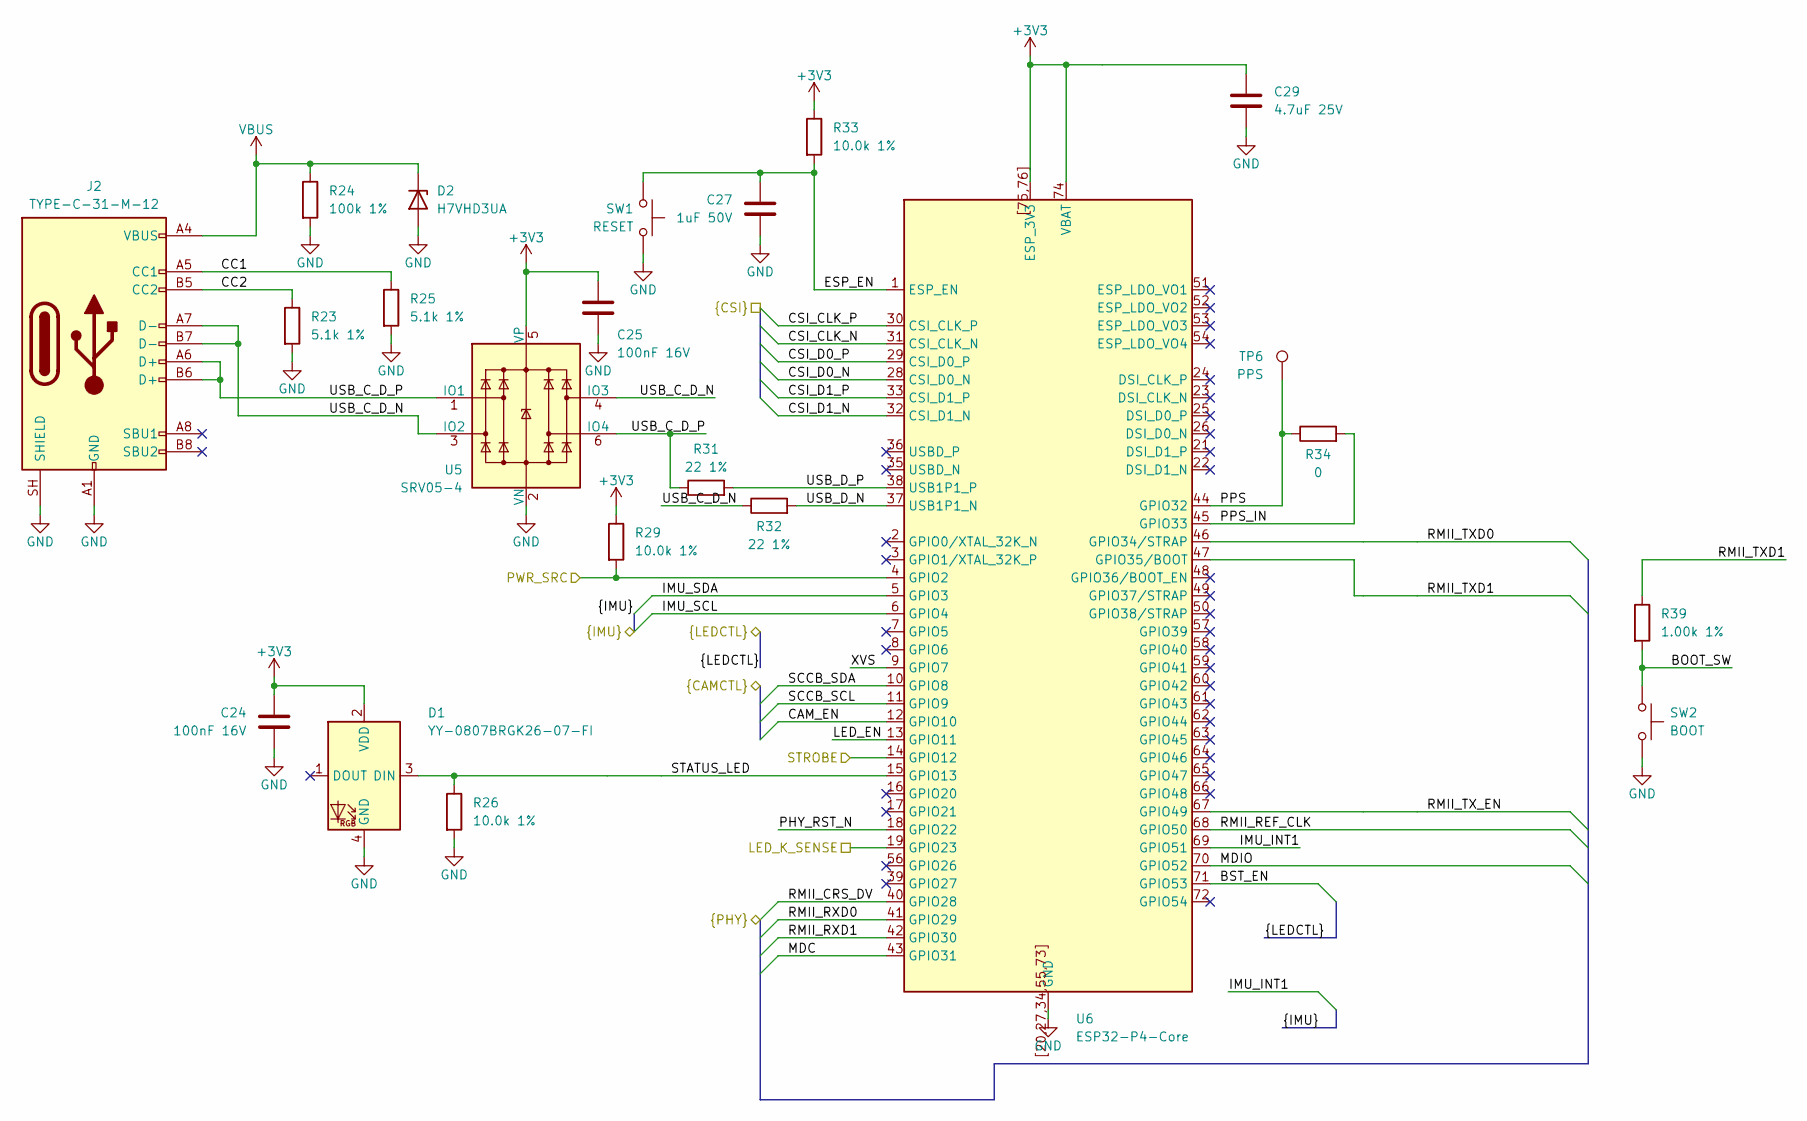
[picture p4: schematic mcu.kicad_sch, espion-cam — MCU]

Parts:
C24, C25: 100nF 16V; C_0402_1005Metric; MPN CL05B104KO5NNNC; LCSC C1525
C27: 1uF 50V; C_0805_2012Metric; MPN CL21B105KBFNNNE; LCSC C28323
C29: 4.7uF 25V; C_0805_2012Metric; MPN CL21A475KAQNNNE; LCSC C1779
D1: YY-0807BRGK26-07-FI; LED_Yongyu_YY-0807_2.0x1.7mm; MPN YY-0807BRGK26-07-FI; LCSC C54796802
D2: H7VHD3UA; D_SOD-323_HandSoldering; MPN H7VHD3UA; LCSC C20615807
J2: TYPE-C-31-M-12; USB_C_Receptacle_HRO_TYPE-C-31-M-12; MPN TYPE-C-31-M-12; LCSC C165948
R23, R25: 5.1k 1%; R_0402_1005Metric; MPN 0402WGF5101TCE; LCSC C25905
R24: 100k 1%; R_0402_1005Metric; MPN 0402WGF1003TCE; LCSC C25741
R26, R29, R33: 10.0k 1%; R_0402_1005Metric; MPN 0402WGF1002TCE; LCSC C25744
R31, R32: 22 1%; R_0402_1005Metric; MPN 0402WGF220JTCE; LCSC C25092
R34: 0; R_0402_1005Metric; MPN 0402WGF0000TCE; LCSC C17168
R39: 1.00k 1%; R_0402_1005Metric; MPN 0402WGF1001TCE; LCSC C11702
SW1: RESET; SW_Push_1P1T_XKB_TS-1187A; MPN TS-1187A-B-A-B; LCSC C318884
SW2: BOOT; SW_Push_1P1T_XKB_TS-1187A; MPN TS-1187A-B-A-B; LCSC C318884
TP6: PPS; TestPoint_Pad_D1.0mm
U5: SRV05-4; SOT-23-6; MPN SRV05-4; LCSC C7420376
U6: ESP32-P4-Core; Waveshare_ESP32-P4-Core_HandSolder; MPN ESP32-P4-Core (SKU 36096)

Connections:
+3V3: C24.1, C25.1, C29.1, D1.2 (VDD), R29.1, R33.1, U5.5 (VP), U6.74 (VBAT), U6.75 (ESP_3V3), U6.76 (ESP_3V3), U6.[75,76] (ESP_3V3); also elsewhere on the board
/Camera/CAM_EN: U6.12 (GPIO10); also elsewhere on the board
/Camera/CSI_CLK_N: U6.31 (CSI_CLK_N); also elsewhere on the board
/Camera/CSI_CLK_P: U6.30 (CSI_CLK_P); also elsewhere on the board
/Camera/CSI_D0_N: U6.28 (CSI_D0_N); also elsewhere on the board
/Camera/CSI_D0_P: U6.29 (CSI_D0_P); also elsewhere on the board
/Camera/CSI_D1_N: U6.32 (CSI_D1_N); also elsewhere on the board
/Camera/CSI_D1_P: U6.33 (CSI_D1_P); also elsewhere on the board
/Camera/SCCB_SCL: U6.11 (GPIO9); also elsewhere on the board
/Camera/SCCB_SDA: U6.10 (GPIO8); also elsewhere on the board
/Camera/STROBE: U6.14 (GPIO12); also elsewhere on the board
/Camera/XVS: U6.9 (GPIO7); also elsewhere on the board
/Ethernet/MDC: U6.43 (GPIO31); also elsewhere on the board
/Ethernet/MDIO: U6.70 (GPIO52); also elsewhere on the board
/Ethernet/PHY_RST_N: U6.18 (GPIO22); also elsewhere on the board
/Ethernet/RMII_CRS_DV: U6.40 (GPIO28); also elsewhere on the board
/Ethernet/RMII_REF_CLK: U6.68 (GPIO50); also elsewhere on the board
/Ethernet/RMII_RXD0: U6.41 (GPIO29); also elsewhere on the board
/Ethernet/RMII_RXD1: U6.42 (GPIO30); also elsewhere on the board
/Ethernet/RMII_TXD0: U6.46 (GPIO34/STRAP); also elsewhere on the board
/Ethernet/RMII_TXD1: R39.1, U6.47 (GPIO35/BOOT); also elsewhere on the board
/Ethernet/RMII_TX_EN: U6.67 (GPIO49); also elsewhere on the board
/LED driver/LED_K_SENSE: U6.19 (GPIO23); also elsewhere on the board
/MCU/BOOT_SW: R39.2, SW2.1
/MCU/BST_EN: U6.71 (GPIO53); also elsewhere on the board
/MCU/CC1: J2.A5 (CC1), R25.1
/MCU/CC2: J2.B5 (CC2), R23.1
/MCU/ESP_EN: C27.1, R33.2, SW1.1, U6.1 (ESP_EN)
/MCU/IMU_INT1: U6.69 (GPIO51); also elsewhere on the board
/MCU/IMU_SCL: U6.6 (GPIO4); also elsewhere on the board
/MCU/IMU_SDA: U6.5 (GPIO3); also elsewhere on the board
/MCU/LED_EN: U6.13 (GPIO11); also elsewhere on the board
/MCU/PPS: R34.1, TP6.1 (1_1), U6.44 (GPIO32)
/MCU/PPS_IN: R34.2, U6.45 (GPIO33)
/MCU/PWR_SRC: R29.2, U6.4 (GPIO2); also elsewhere on the board
/MCU/STATUS_LED: D1.3 (DIN), R26.1, U6.15 (GPIO13)
/MCU/USB_C_D_N: J2.A7 (D-), J2.B7 (D-), R32.1, U5.3 (IO2), U5.4 (IO3)
/MCU/USB_C_D_P: J2.A6 (D+), J2.B6 (D+), R31.1, U5.1 (IO1), U5.6 (IO4)
/MCU/USB_D_N: R32.2, U6.37 (USB1P1_N)
/MCU/USB_D_P: R31.2, U6.38 (USB1P1_P)
GND: C24.2, C25.2, C27.2, C29.2, D1.4 (GND), D2.2 (A), J2.A1 (GND), J2.A12 (GND), J2.B1 (GND), J2.B12 (GND), J2.SH (SHIELD), R23.2, R24.2, R25.2, R26.2, SW1.2, SW2.2, U5.2 (VN), U6.20 (GND), U6.27 (GND), U6.34 (GND), U6.55 (GND), U6.73 (GND), U6.[20,27,34,55,73] (GND); also elsewhere on the board
VBUS: D2.1 (K), J2.A4 (VBUS), J2.A9 (VBUS), J2.B4 (VBUS), J2.B9 (VBUS), R24.1; also elsewhere on the board

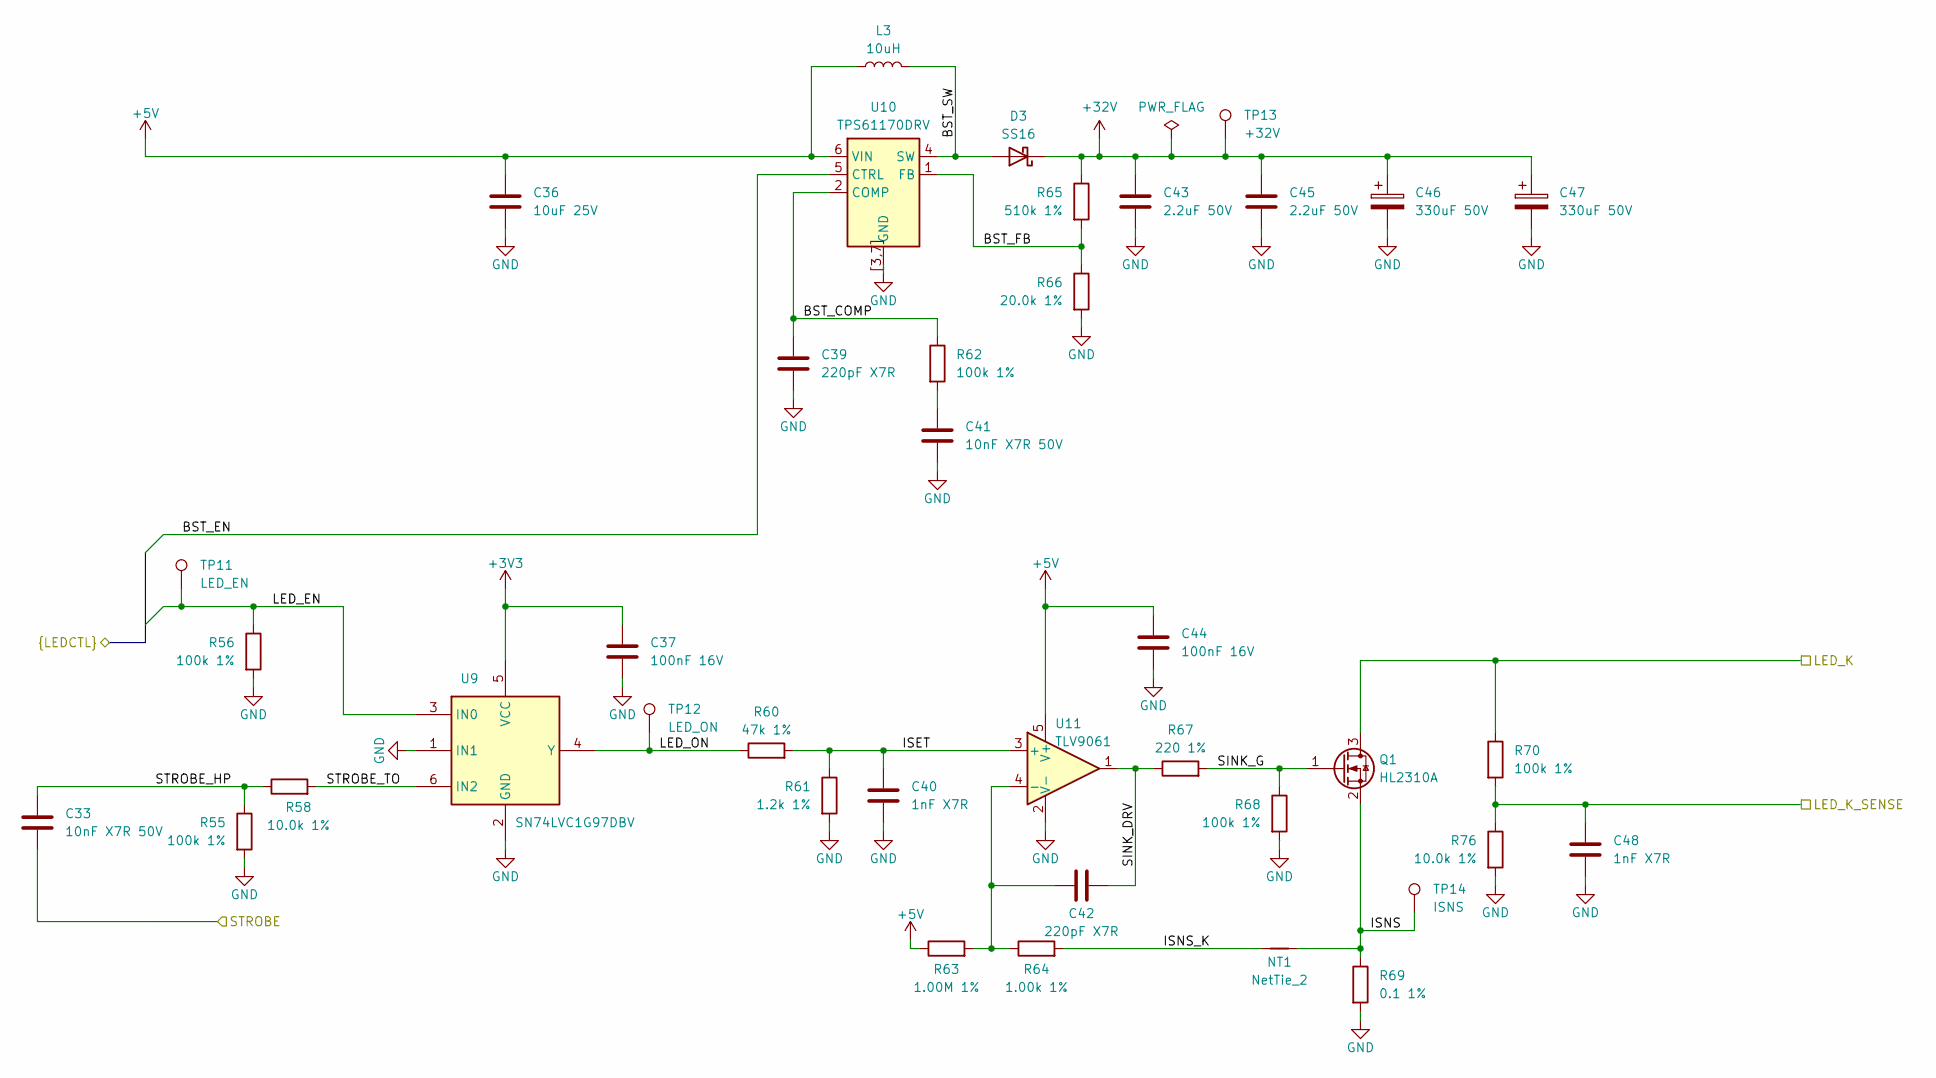
[picture p5: schematic led_driver.kicad_sch, espion-cam — LED driver]

Parts:
C33, C41: 10nF X7R 50V; C_0603_1608Metric; MPN 0603B103K500NT; LCSC C57112
C36: 10uF 25V; C_0805_2012Metric; MPN CL21A106KAYNNNE; LCSC C15850
C37, C44: 100nF 16V; C_0402_1005Metric; MPN CL05B104KO5NNNC; LCSC C1525
C39, C42: 220pF X7R; C_0402_1005Metric; MPN 0402B221K500NT; LCSC C1530
C40, C48: 1nF X7R; C_0402_1005Metric; MPN 0402B102K500NT; LCSC C1523
C43, C45: 2.2uF 50V; C_1206_3216Metric; MPN CL31B225KBHNNNE; LCSC C50254
C46, C47: 330uF 50V; CP_Elec_10x10; MPN GVZ1H337M1010CN; LCSC C22383763
D3: SS16; D_SMA; MPN SS16; LCSC C18199176
L3: 10uH; L_Changjiang_FNR4030S; MPN FNR4030S100MT; LCSC C167879
NT1: NetTie_2; NetTie-2_SMD_Pad0.5mm
Q1: HL2310A; SOT-23; MPN HL2310A; LCSC C7420347
R55, R56, R62, R68, R70: 100k 1%; R_0402_1005Metric; MPN 0402WGF1003TCE; LCSC C25741
R58, R76: 10.0k 1%; R_0402_1005Metric; MPN 0402WGF1002TCE; LCSC C25744
R60: 47k 1%; R_0402_1005Metric; MPN 0402WGF4702TCE; LCSC C25792
R61: 1.2k 1%; R_0402_1005Metric; MPN 0402WGF1201TCE; LCSC C25862
R63: 1.00M 1%; R_0402_1005Metric; MPN 0402WGF1004TCE; LCSC C26083
R64: 1.00k 1%; R_0402_1005Metric; MPN 0402WGF1001TCE; LCSC C11702
R65: 510k 1%; R_0603_1608Metric; MPN 0603WAF5103T5E; LCSC C23192
R66: 20.0k 1%; R_0402_1005Metric; MPN 0402WGF2002TCE; LCSC C25765
R67: 220 1%; R_0402_1005Metric; MPN 0402WGF2200TCE; LCSC C25091
R69: 0.1 1%; R_1206_3216Metric; MPN 1206W4F100LT5E; LCSC C25334
TP11: LED_EN; TestPoint_Pad_D1.0mm
TP12: LED_ON; TestPoint_Pad_D1.0mm
TP13: +32V; TestPoint_Pad_D1.5mm
TP14: ISNS; TestPoint_Pad_D1.0mm
U9: SN74LVC1G97DBV; SOT-23-6; MPN SN74LVC1G97DBVR; LCSC C128411
U10: TPS61170DRV; Texas_DRV0006A_WSON-6-1EP_2x2mm_P0.65mm_EP1x1.6mm; MPN TPS61170DRVR; LCSC C15163
U11: TLV9061; SOT-23-5; MPN TLV9061IDBVR; LCSC C398358

Connections:
+3V3: C37.1, U9.5 (VCC); also elsewhere on the board
+5V: C36.1, C44.1, L3.1, R63.1, U10.6 (VIN), U11.5 (V+); also elsewhere on the board
+32V: C43.1, C45.1, C46.1, C47.1, D3.1 (K), R65.1, TP13.1 (1_1); also elsewhere on the board
/Camera/STROBE: C33.1; also elsewhere on the board
/LED driver/BST_COMP: C39.1, R62.1, U10.2 (COMP)
/LED driver/BST_FB: R65.2, R66.1, U10.1 (FB)
/LED driver/BST_SW: D3.2 (A), L3.2, U10.4 (SW)
/LED driver/ISET: C40.1, R60.2, R61.1, U11.3 (+)
/LED driver/ISNS: NT1.1, Q1.2 (S), R69.1, TP14.1 (1_1)
/LED driver/ISNS_K: NT1.2, R64.2
/LED driver/LED_K: Q1.3 (D), R70.1; also elsewhere on the board
/LED driver/LED_K_SENSE: C48.1, R70.2, R76.1; also elsewhere on the board
/LED driver/LED_ON: R60.1, TP12.1 (1_1), U9.4 (Y)
/LED driver/SINK_DRV: C42.2, R67.1, U11.1
/LED driver/SINK_G: Q1.1 (G), R67.2, R68.1
/LED driver/STROBE_HP: C33.2, R55.1, R58.1
/LED driver/STROBE_TO: R58.2, U9.6 (IN2)
/MCU/BST_EN: U10.5 (CTRL); also elsewhere on the board
/MCU/LED_EN: R56.1, TP11.1 (1_1), U9.3 (IN0); also elsewhere on the board
GND: C36.2, C37.2, C39.2, C40.2, C41.2, C43.2, C44.2, C45.2, C46.2, C47.2, C48.2, R55.2, R56.2, R61.2, R66.2, R68.2, R69.2, R76.2, U9.1 (IN1), U9.2 (GND), U10.3 (GND), U10.7 (GND), U10.[3,7] (GND), U11.2 (V-); also elsewhere on the board
unnamed: C41.1, R62.2
unnamed: C42.1, R63.2, R64.1, U11.4 (-)

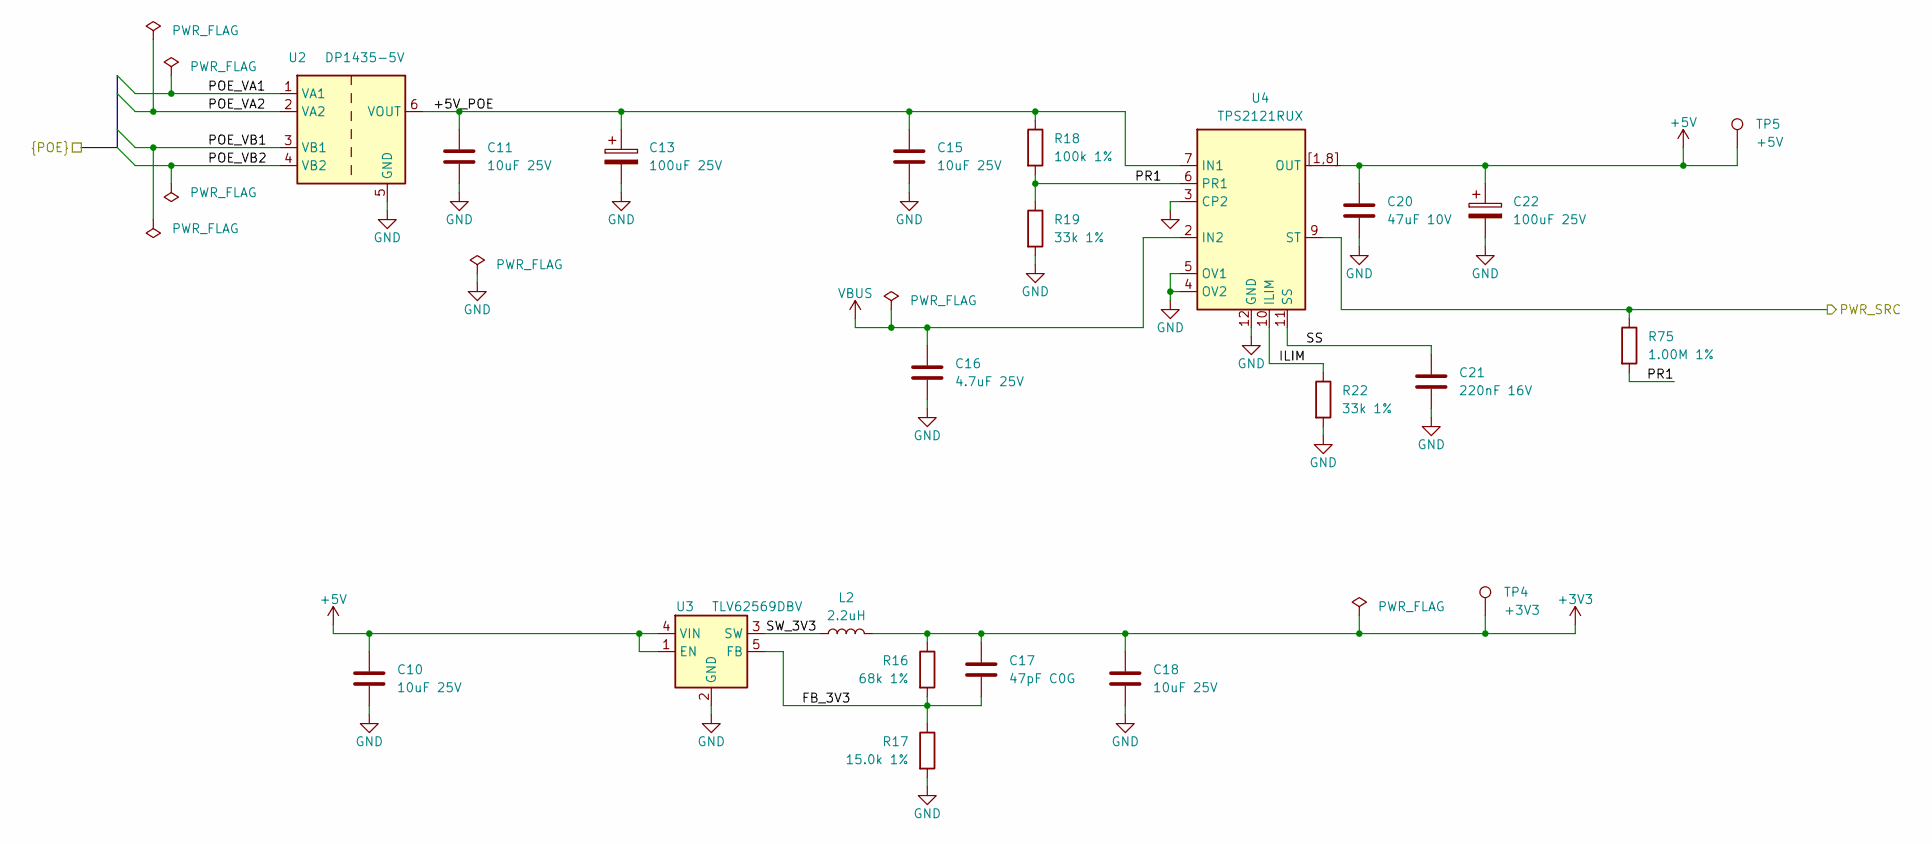
[picture p6: schematic power.kicad_sch, espion-cam — Power]

Parts:
C10, C11, C15, C18: 10uF 25V; C_0805_2012Metric; MPN CL21A106KAYNNNE; LCSC C15850
C13, C22: 100uF 25V; CP_Elec_6.3x5.8; MPN MA25V100M6x6; LCSC C46550465
C16: 4.7uF 25V; C_0805_2012Metric; MPN CL21A475KAQNNNE; LCSC C1779
C17: 47pF C0G; C_0402_1005Metric; MPN 0402CG470J500NT; LCSC C1567
C20: 47uF 10V; C_1206_3216Metric; MPN CL31A476MPHNNNE; LCSC C96123
C21: 220nF 16V; C_0402_1005Metric; MPN CL05B224KO5NNNC; LCSC C16772
L2: 2.2uH; L_Changjiang_FXL0630; MPN FXL0630-2R2-M; LCSC C167218
R16: 68k 1%; R_0402_1005Metric; MPN 0402WGF6802TCE; LCSC C36871
R17: 15.0k 1%; R_0402_1005Metric; MPN 0402WGF1502TCE; LCSC C25756
R18: 100k 1%; R_0402_1005Metric; MPN 0402WGF1003TCE; LCSC C25741
R19, R22: 33k 1%; R_0402_1005Metric; MPN 0402WGF3302TCE; LCSC C25779
R75: 1.00M 1%; R_0402_1005Metric; MPN 0402WGF1004TCE; LCSC C26083
TP4: +3V3; TestPoint_Pad_D1.5mm
TP5: +5V; TestPoint_Pad_D1.5mm
U2: DP1435-5V; Converter_DCDC_SDAPO_DP1435_THT; MPN DP1435-5V; LCSC C5380097
U3: TLV62569DBV; SOT-23-5; MPN TLV62569DBVR; LCSC C141836
U4: TPS2121RUX; Texas_RUX0012A_VQFN-HR-12_2x2.5mm_P0.5mm; MPN TPS2121RUXR; LCSC C485916

Connections:
+3V3: C17.1, C18.1, L2.2, R16.1, TP4.1 (1_1); also elsewhere on the board
+5V: C10.1, C20.1, C22.1, TP5.1 (1_1), U3.1 (EN), U3.4 (VIN), U4.1 (OUT), U4.8 (OUT), U4.[1,8] (OUT); also elsewhere on the board
/Ethernet/POE_VA1: U2.1 (VA1); also elsewhere on the board
/Ethernet/POE_VA2: U2.2 (VA2); also elsewhere on the board
/Ethernet/POE_VB1: U2.3 (VB1); also elsewhere on the board
/Ethernet/POE_VB2: U2.4 (VB2); also elsewhere on the board
/MCU/PWR_SRC: R75.1, U4.9 (ST); also elsewhere on the board
/Power/+5V_POE: C11.1, C13.1, C15.1, R18.1, U2.6 (VOUT), U4.7 (IN1)
/Power/FB_3V3: C17.2, R16.2, R17.1, U3.5 (FB)
/Power/ILIM: R22.1, U4.10 (ILIM)
/Power/PR1: R18.2, R19.1, R75.2, U4.6 (PR1)
/Power/SS: C21.1, U4.11 (SS)
/Power/SW_3V3: L2.1, U3.3 (SW)
GND: C10.2, C11.2, C13.2, C15.2, C16.2, C18.2, C20.2, C21.2, C22.2, R17.2, R19.2, R22.2, U2.5 (GND), U3.2 (GND), U4.3 (CP2), U4.4 (OV2), U4.5 (OV1), U4.12 (GND); also elsewhere on the board
VBUS: C16.1, U4.2 (IN2); also elsewhere on the board

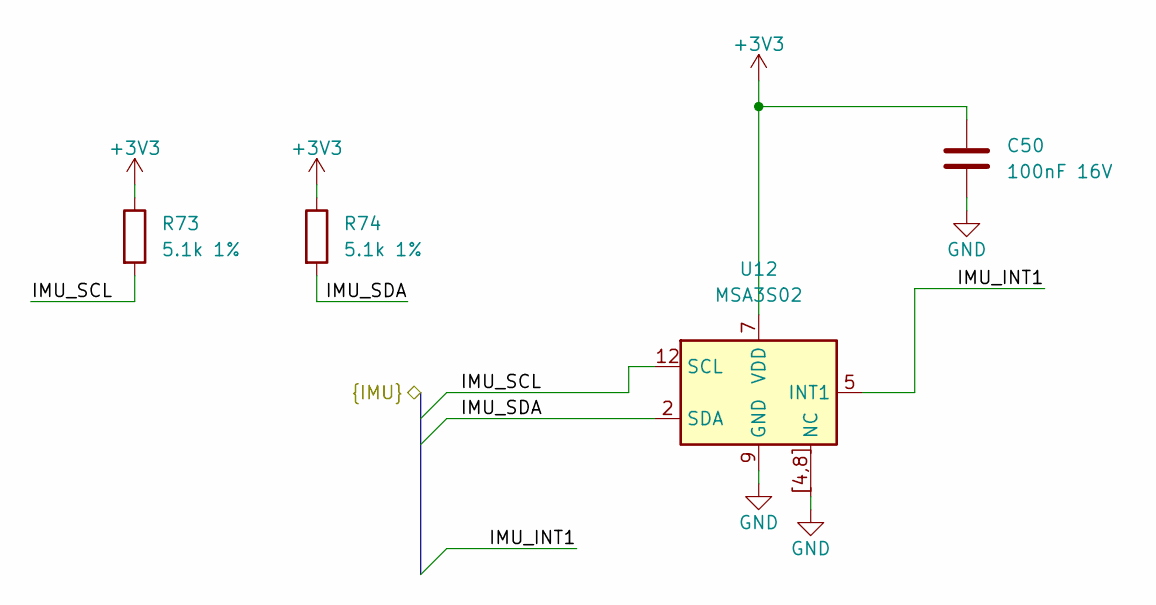
[picture p7: schematic imu.kicad_sch, espion-cam — IMU]

Parts:
C50: 100nF 16V; C_0402_1005Metric; MPN CL05B104KO5NNNC; LCSC C1525
R73, R74: 5.1k 1%; R_0402_1005Metric; MPN 0402WGF5101TCE; LCSC C25905
U12: MSA3S02; MEMSensing_LGA-12_2x2mm_P0.5mm_LayoutBorder2x4y; MPN MSA3S02; LCSC C51928204

Connections:
+3V3: C50.1, R73.1, R74.1, U12.7 (VDD); also elsewhere on the board
/MCU/IMU_INT1: U12.5 (INT1); also elsewhere on the board
/MCU/IMU_SCL: R73.2, U12.12 (SCL); also elsewhere on the board
/MCU/IMU_SDA: R74.2, U12.2 (SDA); also elsewhere on the board
GND: C50.2, U12.4 (NC), U12.8 (NC), U12.9 (GND), U12.[4,8] (NC); also elsewhere on the board

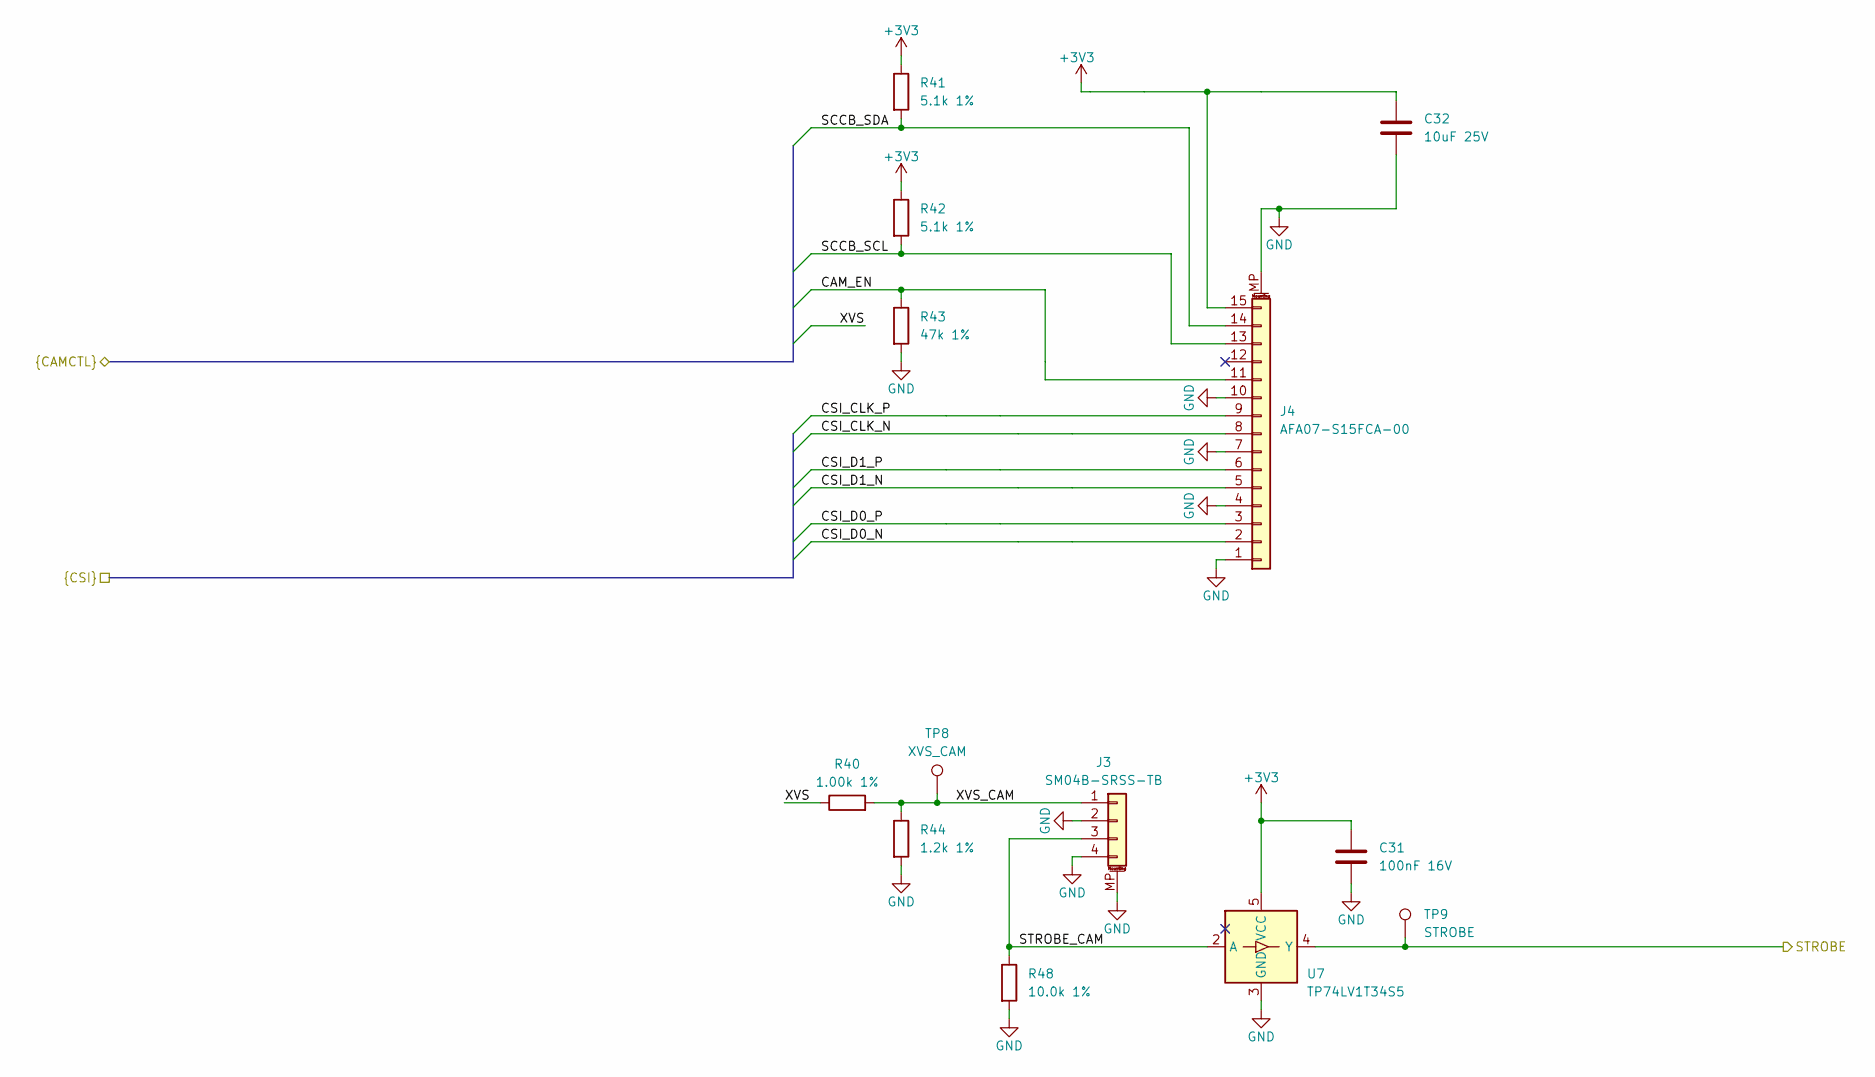
[picture p8: schematic camera.kicad_sch, espion-cam — Camera]

Parts:
C31: 100nF 16V; C_0402_1005Metric; MPN CL05B104KO5NNNC; LCSC C1525
C32: 10uF 25V; C_0805_2012Metric; MPN CL21A106KAYNNNE; LCSC C15850
J3: SM04B-SRSS-TB; JST_SH_SM04B-SRSS-TB_1x04-1MP_P1.00mm_Horizontal; MPN SM04B-SRSS-TB(LF)(SN); LCSC C160404
J4: AFA07-S15FCA-00; JUSHUO_AFA07-S15FCA-00_1x15-1MP_P1.0mm_Horizontal; MPN AFA07-S15FCA-00; LCSC C262721
R40: 1.00k 1%; R_0402_1005Metric; MPN 0402WGF1001TCE; LCSC C11702
R41, R42: 5.1k 1%; R_0402_1005Metric; MPN 0402WGF5101TCE; LCSC C25905
R43: 47k 1%; R_0402_1005Metric; MPN 0402WGF4702TCE; LCSC C25792
R44: 1.2k 1%; R_0402_1005Metric; MPN 0402WGF1201TCE; LCSC C25862
R48: 10.0k 1%; R_0402_1005Metric; MPN 0402WGF1002TCE; LCSC C25744
TP8: XVS_CAM; TestPoint_Pad_D1.0mm
TP9: STROBE; TestPoint_Pad_D1.0mm
U7: TP74LV1T34S5; SOT-23-5; MPN TP74LV1T34S5; LCSC C47117591

Connections:
+3V3: C31.1, C32.1, J4.15, R41.1, R42.1, U7.5 (VCC); also elsewhere on the board
/Camera/CAM_EN: J4.11, R43.1; also elsewhere on the board
/Camera/CSI_CLK_N: J4.8; also elsewhere on the board
/Camera/CSI_CLK_P: J4.9; also elsewhere on the board
/Camera/CSI_D0_N: J4.2; also elsewhere on the board
/Camera/CSI_D0_P: J4.3; also elsewhere on the board
/Camera/CSI_D1_N: J4.5; also elsewhere on the board
/Camera/CSI_D1_P: J4.6; also elsewhere on the board
/Camera/SCCB_SCL: J4.13, R42.2; also elsewhere on the board
/Camera/SCCB_SDA: J4.14, R41.2; also elsewhere on the board
/Camera/STROBE: TP9.1 (1_1), U7.4 (Y); also elsewhere on the board
/Camera/STROBE_CAM: J3.3, R48.1, U7.2 (A)
/Camera/XVS: R40.1; also elsewhere on the board
/Camera/XVS_CAM: J3.1, R40.2, R44.1, TP8.1 (1_1)
GND: C31.2, C32.2, J3.2, J3.4, J3.MP (MountPin), J4.1, J4.4, J4.7, J4.10, J4.MP (MountPin), R43.2, R44.2, R48.2, U7.3 (GND); also elsewhere on the board
