azais-corentin/espion/hardware/espion-cam/espion-cam.kicad_pcb

## KiCad design hardware/espion-cam/espion-cam.kicad_pcb (continued)

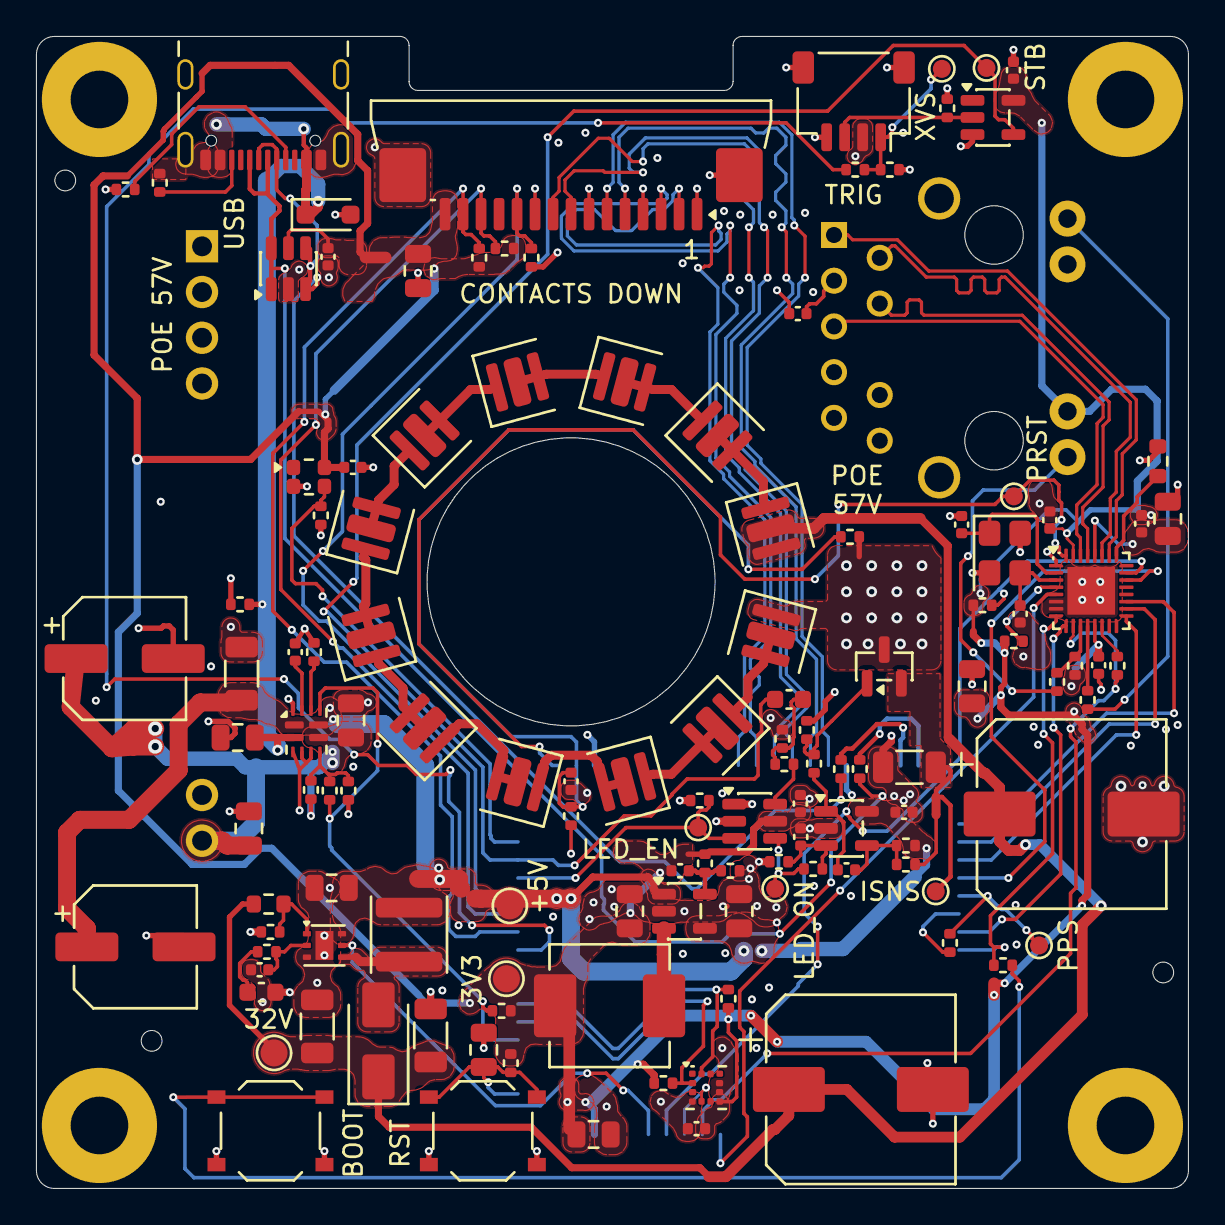
[picture p9: board espion-cam.kicad_pcb from above]

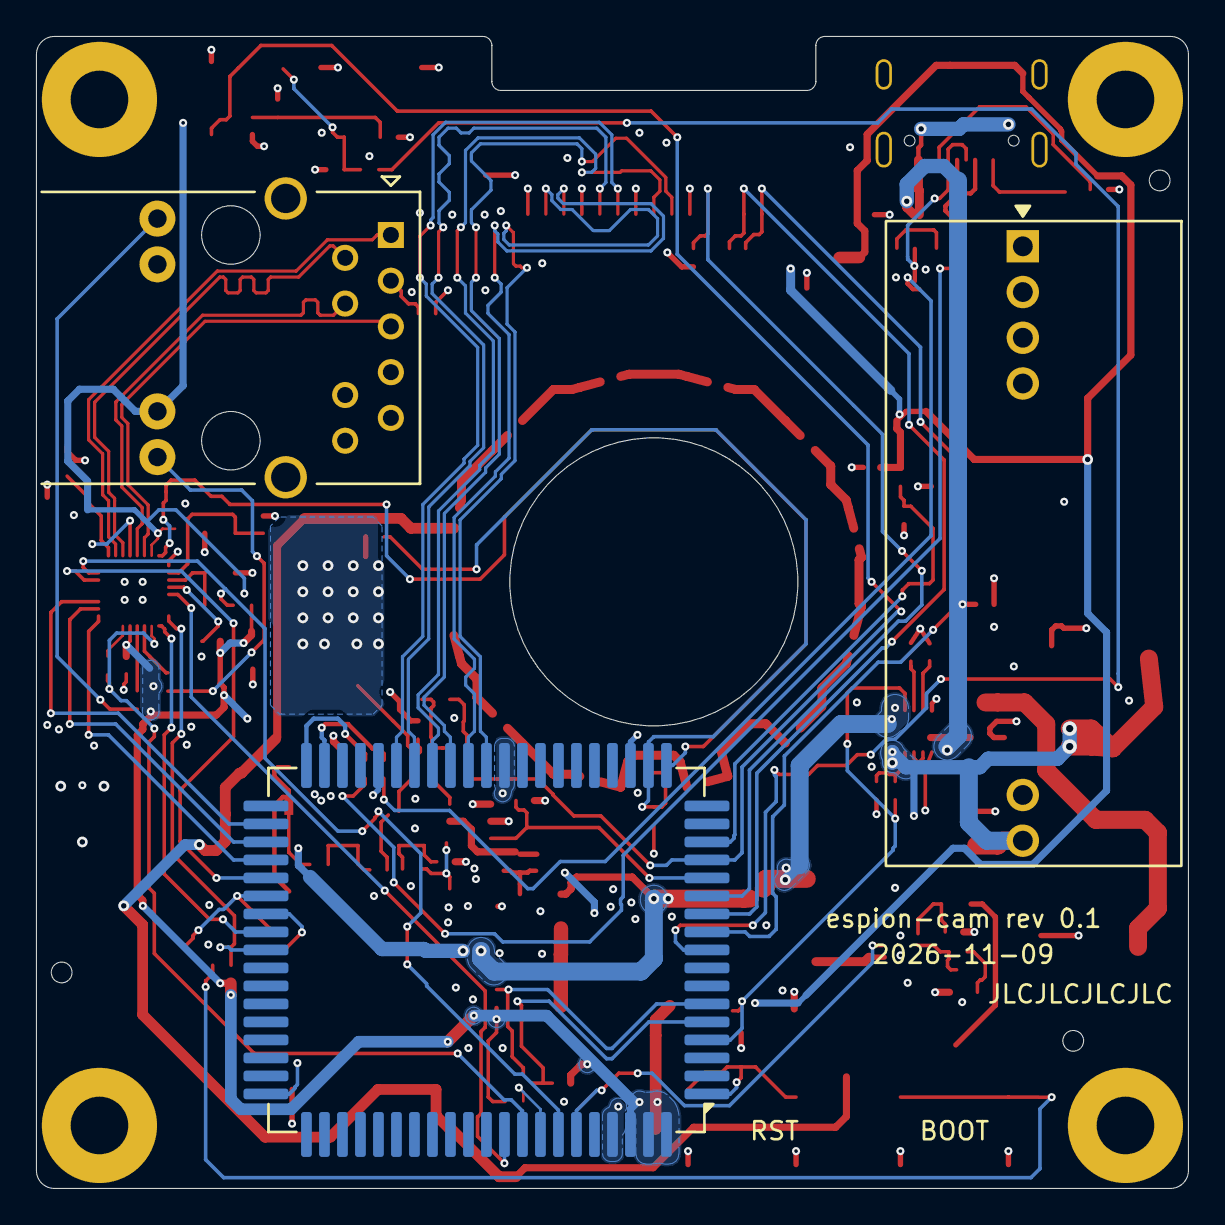
[picture p10: board espion-cam.kicad_pcb from below]

Board: 4 copper layers, 64.0 x 64.0 mm, 138 parts (3 on the bottom side), 96 nets.

Other parts of the board:
TOOL1, TOOL2, TOOL3: ToolingHole_1.152mm_JLCPCB
