azais-corentin/espion/.omp/extensions/kicad/test/fixtures/layout/layout.kicad_pcb

## KiCad design .omp/extensions/kicad/test/fixtures/layout/layout.kicad_pcb (2026-10-30)

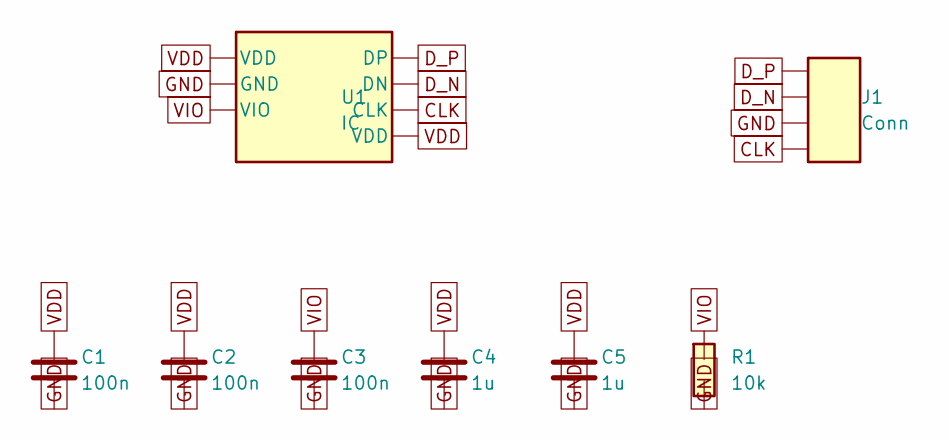
[picture p11: schematic layout.kicad_sch]

Parts:
C1, C2, C3: 100n; C
C4, C5: 1u; C
J1: Conn; J
R1: 10k; R
U1: IC

Connections:
CLK: J1.4, U1.6 (CLK)
D_N: J1.2, U1.5 (DN)
D_P: J1.1, U1.4 (DP)
GND: C1.2, C2.2, C3.2, C4.2, C5.2, J1.3, R1.2, U1.2 (GND)
VDD: C1.1, C2.1, C4.1, C5.1, U1.1 (VDD), U1.7 (VDD)
VIO: C3.1, R1.1, U1.3 (VIO)

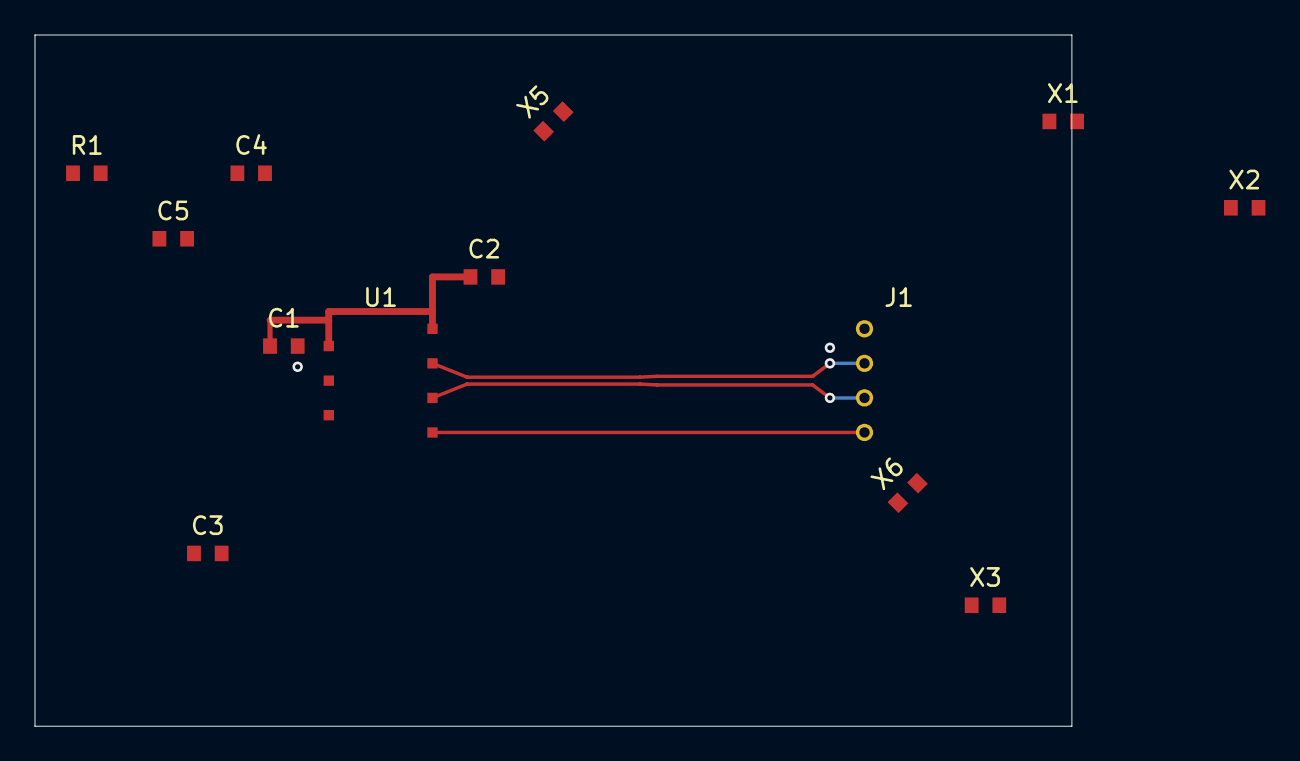
[picture p12: board layout.kicad_pcb from above]

Board: 4 copper layers, 60.0 x 40.0 mm, 14 parts (1 on the bottom side), 6 nets.

Other parts of the board:
X1: edge; C
X2: off; C
X3: keepout; C
X4: bottom; C
X5, X6: rotated; C
