azais-corentin/espion/.omp/extensions/kicad/test/fixtures/board/copper.kicad_pcb

## KiCad design .omp/extensions/kicad/test/fixtures/board/copper.kicad_pcb (2026-10-30)

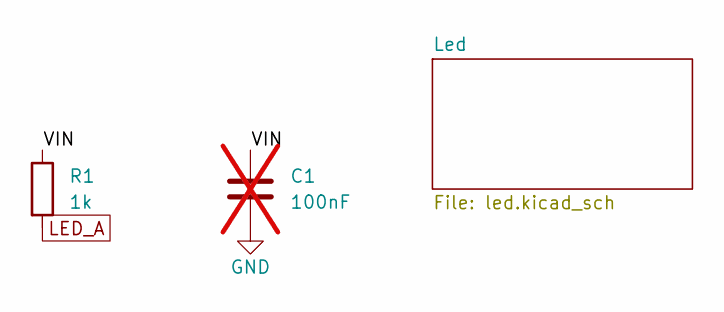
[picture p13: schematic board.kicad_sch]

Parts:
C1: 100nF; C_0603_1608Metric; MPN CC0603KRX7R9BB104; LCSC C14663; not fitted
R1: 1k; R_0603_1608Metric; MPN 0603WAF1001T5E; LCSC C21190

Connections:
/VIN: C1.1, R1.1
GND: C1.2; also elsewhere on the board
LED_A: R1.2; also elsewhere on the board

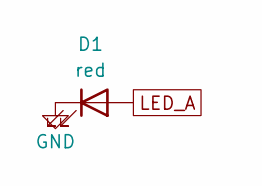
[picture p14: schematic led.kicad_sch]

Parts:
D1: red; LED_Fixture_0603; MPN 19-217/R6C-AL1M2VY/3T; LCSC C72044

Connections:
GND: D1.1 (K); also elsewhere on the board
LED_A: D1.2 (A); also elsewhere on the board

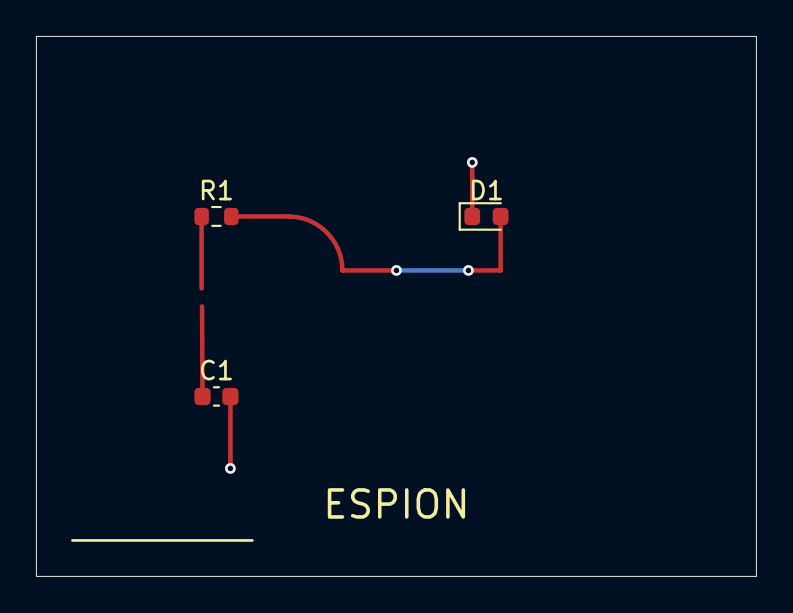
[picture p15: board copper.kicad_pcb from above]

Board: 2 copper layers, 40.0 x 30.0 mm, 3 parts (0 on the bottom side), 3 nets.
