azais-corentin/espion/(commit log)

2026-10-27 chore: Created the initial repository skeleton
    - Nix flake (rust-overlay, Rust 1.99.1 with riscv32imafc/riscv32imac,
    espflash, probe-rs, KiCad) and direnv
    - Host workspace: espion-proto, p4-c5-link (host tests), espion-server,
    espion-viewer, espion-calib, espion-sync (stubs)
    - Firmware stubs: cam-p4 (ESP32-P4) and radio-c5 (ESP32-C5) on esp-hal
    1.2.2 + esp-rtos/embassy, each with its own target, runner, toolchain
    - Vendored esp-wifi-sys-esp32c5 0.3.0 with esp32-wifi-lib 9e91edc (FTM fix)
    - Docs: architecture (incl. esp-hal gaps, version pins), protocol, timing
    - Licenses: MIT OR Apache-2.0 (code), CERN-OHL-P-2.0 (hardware)
    [build.rs, lib.rs, main.rs]
2026-10-27 docs: Recorded hardware, sync and protocol decisions
    - Board: P4 with in-package PSRAM, C5 module on 5 GHz, USB hub to both
    chips, passive markers at 2-5 m, dark frame every N, 500 us exposure
    - Timing: 10 Hz SYNC (was PPS) captured on the P4 via ETM; automatic
    master election with failover and timescale continuity; espion-sync
    only observes
    - Protocol: Announce from every C5, dark-frame flag, Q11.5 blob coords,
    exact version match, boards identified by C5 MAC
    - New firmware/esp32p4-csi stub crate used by cam-p4
    - Drop build-time FTM_MASTER_MAC
    [lib.rs, main.rs]
2026-10-27 chore(skills): Added the kicad-mcp-pro MCP server and its skills for omp
    Register kicad-mcp-pro 4.4.0 (uvx, default profile, readonly mode) in
    .omp/mcp.json, pointed at hardware/espion-cam with the workspace root
    limited to hardware/. Vendor its six KiCad skills from tag
    mcp-server-v4.4.0 into .omp/skills (MIT, provenance in VENDORED.md).
    Ignore the server's output dir and incremental cache.
2026-10-27 feat(espion-cam): Created the espion-cam KiCad project
    [espion-cam.kicad_pcb, espion-cam.kicad_sch]
2026-10-28 feat: Replaced the ESP32-C5 with Ethernet on a Waveshare ESP32-P4-Core
    The camera board becomes a baseboard for the Waveshare ESP32-P4-Core
    module (ESP32-P4NRW32X rev v3, 32 MB PSRAM, 16 MB flash). Wi-Fi and the
    C5 co-processor give way to the P4's own EMAC with an IP101GRI PHY.
    - Remove firmware/radio-c5, firmware/p4-c5-link, the vendored
    esp-wifi-sys-esp32c5, .envrc.local.example and the riscv32imac target;
    cam-p4 now depends on espion-proto directly
    - Power: 802.3af PoE PD OR-ed with USB-C 5 V; USB-C goes straight to
    the P4's USB Serial/JTAG (no hub)
    - Timing: PTPv2 with EMAC hardware timestamps via statime, grandmaster
    elected by BMCA (join without disruption, no preemption, hol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
    [build.rs, lib.rs, main.rs]
2026-10-28 feat(hardware-lib): Added a KLC-compliant symbol and footprint for the ESP32-P4-Core
    MCU_Module_Waveshare:ESP32-P4-Core and
    Module_Waveshare:Waveshare_ESP32-P4-Core, registered in the espion-cam
    project's sym-lib-table and fp-lib-table with ${KIPRJMOD}-relative paths.
    - Written through KiCad: the footprint with the pcbnew API, the symbol
    with kicad-library-utils and re-saved by kicad-cli
    - Symbol: pin names from Waveshare's pin description; alternates from
    ESP32-P4 datasheet Tables 2-3/2-5/2-7; strapping pins named per TRM
    chapter 12; native pin stacks for GND and ESP_3V3
    - Footprint: 76 castellated pads per the Waveshare outline, no pads
    under the module; 0.6x1.5 mm land pattern is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
2026-10-28 docs(espion-cam): Replaced the Ag9905M-class PoE PD with the SDAPO DP1435-5V
    - Parts table: SDAPO DP1435-5V (LCSC C5380097), 802.3af, isolated
    1.5 kV flyback, 5.15 V out, fixed Class 0, THT SIP-6
    - Hardware tasks: pinout and mechanical data from the datasheet, the
    datasheet's output LC filter before the 5 V OR-ing, MagJack
    requirements (both centre taps and spare pairs 4/5, 7/8; Bob-Smith
    termination in the jack or discrete), and a power budget of ~10.5 W
    (12.95 W x 84 %), since the 12.4 W rating exceeds 802.3af
    - Drop the discrete-flyback alternative
2026-10-28 docs(espion-cam): Selected the board BOM and the 850 nm LED ring, dropped LED_FORCE
    Add hardware/espion-cam/BOM.md with the selected LCSC parts: HR871150C
    MagJack, IP101GRI and its crystal, TPS2116 OR-ing, TLV62569 3.3 V buck,
    PoE LC filter, USB-C, buttons, and the OV9281 camera module with its FPC
    and XVS/STROBE pigtail.
    LED ring: 12 x Amicc A-SC880IR3C-P03-1T (LCSC C5355470), 850 nm, 90°,
    380 mW/sr at 1 A, 4.6 W/sr on axis against a 2.3 W/sr target for 14 mm
    markers at 5 m with the 79° lens. One series string on a ~30 V boost
    with a storage capacitor and a fixed 1 A current sink. Sizing,
    assumptions and driver numbers are in docs/architecture.md (LED ring).
    Remove LED_FORCE: the gate i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
2026-10-28 docs(espion-cam): Selected the LED driver and rechecked LCSC stock for the BOM
    Recheck all 20 LCSC parts on their product pages: all in stock, MPNs and
    prices unchanged, stock figures refreshed.
    LED driver, all parts in LCSC stock: TPS61170 boost to 32 V into
    2 x 220 uF/50 V, TLV9061 + IRLR024N + 0.1 ohm sink at 1 A, gated by an
    SN74LVC1G97 AND (STROBE and LED_EN) with an RC timeout that ends each
    pulse after about 1 ms. New board signal LED_PWR_EN enables the boost.
    Update the power budget (about 2.3 W average for the ring) and the
    hardware tasks; the on-time limit question is settled.
2026-10-28 feat(hardware-lib): Added KLC-checked library parts and 3D models for the BOM parts
    Symbols, footprints and STEP models for the LCSC parts that KiCad lacks
    or gets wrong, registered in the espion-cam lib tables with
    ${KIPRJMOD}-relative paths. Each was written through KiCad tooling
    (pcbnew API, kicad-library-utils + kicad-cli), checked against the
    manufacturer drawings and reviewed until approved.
    New: DP1435-5V (symbol, footprint, model), HR871150C (symbol,
    footprint derived from the Abracon ARJP11A, model), IP101GRI (symbol),
    Amicc A-SC880IR3C LED (footprint, model), XFCN F1004-H-15 FPC
    (footprint, model), AISHI 6.3x9 and JIERR 8x10.5 cans (footprints).
    From stock, corrected: TPS61170DRV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
2026-10-28 feat(hardware-lib): Added a 3D model for the Waveshare ESP32-P4-Core
    Built in SolidCraft from hardware/lib/3d-src/Waveshare_ESP32-P4-Core.json
    and referenced from the footprint as
    ${KIPRJMOD}/../lib/Module_Waveshare.3dshapes/Waveshare_ESP32-P4-Core.step,
    like the other project models (the old ${KICAD10_3DMODEL_DIR} path never
    resolved).
    - 24 x 20 x 0.85 mm PCB with 76 castellated half-holes on the footprint
    pads, shield can up to the drawing's 3.30 mm overall height
    - Can size, half-hole and pad size estimated from Waveshare's product
    photos (noted in the README)
    - KLC checker: only F9.3 for the project model path
2026-10-28 docs(espion-cam): Designed the espion-cam schematic architecture
    Add hardware/espion-cam/SCHEMATIC.md: hierarchical sheets (power, mcu,
    ethernet, camera, led_driver, led_ring), the hierarchical pins and power
    nets between them, GPIO groups, firmware rules, and per-sheet pin-level
    connections, component values with derivations, layout constraints and
    open checks.
    Decisions folded into the docs and BOM:
    - OV9281 XVS/STROBE at 1.8 V: XVS through a divider, STROBE through an
    SN74LV1T34 to the LED gate and a P4 GPIO (ETM capture of exposures).
    - TPS22918 load switch (LED_PWR_EN) ahead of the LED boost, which gets
    its own BST_EN, to stop the 440 uF storage charging at power-up.
    - Epson TSX-32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
2026-10-28 feat(espion-cam): Added the espion-cam hierarchical sheets
    Split the root schematic into Power, MCU, Camera, Ethernet, LED driver
    and LED ring sheets (empty for now). Ignore KiCad's local history
    directory (.history/).
    [camera.kicad_sch, espion-cam.kicad_sch, ethernet.kicad_sch, led_driver.kicad_sch, led_ring.kicad_sch, mcu.kicad_sch, power.kicad_sch]
2026-10-28 feat(espion-cam): Placed every espion-cam part and consolidated the passives
    Place all components from SCHEMATIC.md on the six sheets with their
    values, footprints (plain reflow land patterns) and MPN/LCSC fields.
    Bare-pad test points and the ISNS net tie are excluded from the BOM.
    Cut the passive BOM from 58 to 35 distinct lines with one part per
    position: the TPS22918 CT shares the 10 nF C0G timeout cap (ramp
    ~27 ms, firmware waits >= 50 ms before BST_EN), the buck uses the
    FXL0630 inductor and a 10 uF output cap, the LED set point is
    47k/1.5k, the XVS divider 1.5k/1.8k, the VLED divider 255k/10k, the
    boost compensation 10 nF/220 pF, and duplicate spellings of the same
    part are merged. SC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
    [camera.kicad_sch, ethernet.kicad_sch, led_driver.kicad_sch, led_ring.kicad_sch, mcu.kicad_sch, power.kicad_sch]
2026-10-28 feat(espion-cam): Laid out every espion-cam sheet for wiring
    Move each component to its final position following SCHEMATIC.md:
    signal flow left to right, rails up and GND down, decoupling at its
    power pin, series parts in line with the pins they join, and free
    edge bands for the hierarchical labels. Positions, rotations and
    field placement only; parts, values and BOM are unchanged.
    [camera.kicad_sch, ethernet.kicad_sch, led_driver.kicad_sch, led_ring.kicad_sch, mcu.kicad_sch, power.kicad_sch]
2026-10-28 feat(espion-cam): Wired the espion-cam schematic
    Draw the wires, power symbols, local and hierarchical labels and
    no-connect flags on all six sheets, following SCHEMATIC.md, and add
    the matching sheet pins on the root sheet. Every cross-sheet net joins
    the sheets it should, and ERC reports no violations at any severity.
    GPIO assignments follow the doc's suggested map. CAM_IO1 (J3 pad 4)
    is wired to its DNP 0 ohm option instead of carrying a no-connect.
    [camera.kicad_sch, espion-cam.kicad_sch, ethernet.kicad_sch, led_driver.kicad_sch, led_ring.kicad_sch, mcu.kicad_sch, power.kicad_sch]
2026-10-28 refactor(espion-cam): Grouped the espion-cam cross-sheet signals into buses
    Carry the multi-signal sheet interfaces as buses instead of one
    hierarchical pin per signal: POE (PoE pairs), PHY (RMII, MDIO and PHY
    reset), CSI (camera lanes), CAMCTL (SCCB, CAM_EN, XVS) and LEDCTL (LED
    supply, boost and channel enables). Each bus is an unnamed alias group,
    so member nets keep their bare names; only the sheet prefix of the
    cross-sheet nets changes. STROBE, PWR_SRC, LED_K, VLED_SENSE and
    NTC_SENSE stay single wires.
    The root sheet becomes a block diagram with buses and wires drawn
    between the sheet symbols. Pin connectivity is unchanged and ERC is
    clean.
    [camera.kicad_sch, espion-cam.kicad_sch, ethernet.kicad_sch, led_driver.kicad_sch, mcu.kicad_sch, power.kicad_sch]
2026-10-28 docs(espion-cam): Documented the espion-cam buses and fixed the CAM_IO1 note
    Add a Buses section to SCHEMATIC.md listing each bus alias, its
    members, the sheets it joins and its label shape, and explain why the
    labels use unnamed alias groups. Show the buses in the block diagram,
    add a Bus column to the cross-sheet signal table and name each sheet's
    labels above its pin table.
    J3 pad 4 (CAM_IO1) is wired to the DNP 0 ohm R36, so it has no
    no-connect flag; correct the connector table to match.
2026-10-28 style(espion-cam): Tidied the espion-cam schematic drawing style
    Apply three drawing rules on every sheet, with no electrical change:
    - Every wired pin leaves on at least 50 mil of straight wire before
    any junction, branch or bend. Parts that sat on rails or junctions
    moved 50 mil away.
    - Power symbols are upright. One wired to a single pin sits on a
    straight 50 mil wire from a vertical pin, or 50 mil out then 50 mil
    to the symbol from a horizontal pin. GND symbols stay sideways on
    pins whose neighbouring pin wire would run through an upright one
    (J3 pads 6/9/12, J4 pin 2, U6 TXER, U10 IN1).
    - Local net and bus labels sit on a wire that runs under their whole
    text; labels on v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
    [camera.kicad_sch, espion-cam.kicad_sch, ethernet.kicad_sch, led_driver.kicad_sch, led_ring.kicad_sch, mcu.kicad_sch, power.kicad_sch]
2026-10-28 chore(espion-cam): Resaved espion-cam KiCad schematic sheets
    - Reordered wire entries across camera, ethernet, LED driver, MCU, and power sheets.
    [camera.kicad_sch, ethernet.kicad_sch, led_driver.kicad_sch, mcu.kicad_sch, power.kicad_sch]
2026-10-29 chore(skills): Removed the kicad MCP server and its vendored skills
    Drop the kicad-mcp-pro entry from .omp/mcp.json, the six skills vendored from it with their license, its VENDORED.md section and its .gitignore entries. The solidcraft server and skills stay.
2026-10-29 docs: Updated AGENTS.md and README.md for the captured schematic and SolidCraft
    README: the schematic is captured and ERC clean, PCB layout not started;
    link SCHEMATIC.md and BOM.md; list KiCad 10 and SolidCraft in the dev shell;
    replace the hardware placeholder with the open, ERC and 3D-model commands.
    AGENTS.md: describe hardware/espion-cam, hardware/lib/3d-src and .omp in the
    repo map; keep SCHEMATIC.md and BOM.md in step with the schematic and ERC at
    0 violations; follow the library README and build 3D models with SolidCraft;
    ignore KiCad .history/ but commit the generated STEP models; add ERC and KLC
    checks to the finishing steps.
2026-10-29 docs(hardware): Updated the espion-cam and library READMEs for the captured schematic
    espion-cam README: the schematic is captured and ERC clean (root sheet plus
    six hierarchical sheets, buses between them), PCB layout not started; the
    board list follows BOM.md and SCHEMATIC.md (single-contact JUSHUO camera FPC
    connector, TLV9061 + IRLR024N sink, SN74LVC1G97 gate, 2 x 220 uF storage, USB
    ESD and VBUS TVS, BOOT and RESET buttons); conventions add the SCHEMATIC.md and
    BOM.md upkeep, ERC at 0 and the library README.
    lib README: mark the XFCN FFC library as no longer used by espion-cam and say
    why.
    AGENTS.md: a part change also updates the espion-cam README board list; a
    library Parts entry sa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
2026-10-29 fix(espion-cam): Applied the espion-cam review changes and generated the BOM from KiCad
    Schematic (scripted edits, to be re-saved in KiCad):
    - Power: C17 becomes a JIERR MA25V100M6x6 100 uF/25 V polymer (C46550465),
    so +5V holds ~121 uF effective at 5.67 V (was ~42 uF), meeting the TPS2116
    ~100 uF advice. D2 becomes a TI TSD05DYFR (C22396185, SOD-323): <= 50 nA at
    5.5 V instead of the SMBJ5.0A's 800 uA.
    - MCU: VBUS sense on GPIO20 (R62 47k / R63 75k, C49 10 nF), so firmware can
    drop the USB D+ pull-up when VBUS is absent.
    - Camera: R37 (CAM_3V3 link) is DNP for the first build.
    - Root: H1-H4, plated M3 mounting holes on GND.
    - Every local net named in SCHEMATIC.md now carries that la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
    [camera.kicad_sch, espion-cam.kicad_sch, ethernet.kicad_sch, led_driver.kicad_sch, led_ring.kicad_sch, mcu.kicad_sch, power.kicad_sch]
2026-10-29 feat(espion-cam): Added an LSM6DS3TR-C IMU to espion-cam
    Schematic (scripted edits, re-saved with kicad-cli sch upgrade --force):
    - New imu sheet: ST LSM6DS3TR-C (U12, LCSC C967633), the cheapest
    in-stock 6-axis IMU on LCSC, with the stock Sensor_Motion:LSM6DS3
    symbol and LGA-14 footprint. 100 nF on Vdd and Vdd_IO (C50, C51),
    10 kOhm I2C pull-ups (R64, R65). CS high (I2C), SA0/SDx/SCx to GND
    (address 0x6A, sensor hub unused), INT2 not connected.
    - New {IMU} bus (IMU_SDA, IMU_SCL, IMU_INT1) between mcu and imu: its own
    I2C bus on GPIO3/GPIO4 and INT1 on GPIO54.
    - mcu: the {LEDCTL} hierarchical label moves down one row to make room
    for the GPIO3/4 wires; connectivity is unchanged.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
    [espion-cam.kicad_sch, imu.kicad_sch, mcu.kicad_sch]
2026-10-29 chore(espion-cam): Re-saved the espion-cam sheets in KiCad's canonical form
    kicad-cli sch upgrade --force on every sheet. The netlist and ERC are
    unchanged; the libraries and the other sheets were already canonical.
    [ethernet.kicad_sch, led_driver.kicad_sch, power.kicad_sch]
2026-10-29 build(nix): Added the KiCad toolkit's tools to the dev shell
    - kicad-library-tools (flake input, at $KICAD_LIBRARY_TOOLS): the official
    KiCad symbol/footprint generators and the KLC checker scripts, which
    replaced kicad-library-utils.
    - Python with the generators' and checkers' packages.
    - bun, to run the toolkit's tests.
    - poppler-utils and imagemagick, for datasheet pages and crops.
2026-10-29 feat(kicad-toolkit): Added a KiCad toolkit for agents and made KiCad files toolkit-only
    omp extension in .omp/extensions/kicad with five tools:
    - kicad_query: hierarchy, symbols, nets, labels, net classes, rules, BOM,
    free space, and library parts (search, symbols and footprints with their
    graphics, lib_diff between two parts, lib_fp_filter).
    - kicad_edit: schematic, hierarchy (new sheets), project, rule and library
    ops (create, generate with the official generators, copy from stock,
    draw from primitives, edit pads/pins/graphics/3D model placement) in one
    transaction. It is verified in a temporary copy (KiCad re-save, expected
    connectivity, no new ERC, drawing-style or KLC findin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
2026-10-29 feat(kicad-toolkit): Added decoupling, pulls and BOM-line checks
    decoupling: every power_in pin's net needs a capacitor to ground on the same sheet. pulls: open-collector/open-emitter and SDA/SCL/MDIO nets need pull resistors, I2C pairs on one rail. bom_lines: one MPN per value and footprint, one value per R/C/L MPN, merge candidates as info. erc: exclusions without a comment are warnings. Exemptions in .omp/kicad.json carry a reason and report as info.
2026-10-29 docs(skills): Reworked the schematic review skill around a checklist
    kicad-schematic-review gets review modes (change, standard, full), an architecture pass, per-sheet and cross-cutting topic reviewers, JSON verdicts with item coverage, and an optional fix loop. The new checklist.md holds the items, drawn from the Memfault, Schemalyzer and Altium checklists and Espressif's design guidelines. kicad-schematic-edit gains a checklist self-check; kicad-library-review shares the verdict format.
2026-10-29 fix(espion-cam): Fixed the espion-cam schematic review findings
    Power: replace the TPS2116 power mux (U4) with a TPS2121RUXR (LCSC
    C485916). Its current limit (R68, 36 k) bounds the PoE-to-USB
    switchover current, and soft start (C52) cuts USB attach inrush to
    ~0.1 A. PoE priority now uses an XREF threshold: PR1 divider R17/R18
    (100 k / 47 k) against a CP2 divider from +3V3 (R66/R67, 100 k / 60.4 k).
    New project symbol Power_Management_TI:TPS2121RUX, and project
    footprint Package_DFN_QFN_TI:Texas_RUX0012A with a SolidCraft 3D model.
    Parts: remove C10; C9/C26 to 4.7 uF; C49 to 100 nF; C38/C39 to
    1 uF 100 V 1206; R58 to a +/-100 ppm/K shunt; swap the out-of-stock
    100 nF and 10 k parts board-wi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
    [camera.kicad_sch, espion-cam.kicad_sch, ethernet.kicad_sch, imu.kicad_sch, led_driver.kicad_sch, led_ring.kicad_sch, mcu.kicad_sch, power.kicad_sch]
2026-10-29 feat(kicad-toolkit): Added LCSC part data, datasheet page search and scoped connectivity diffs
    - kicad_query lcsc: LCSC's live product data (part, manufacturer,
    package, stock, price breaks, datasheet) for LCSC codes, with a
    per-code error and a small request cap.
    - kicad_datasheet: `pages` for the text of a page list and `find` for
    regex matches with page and line numbers.
    - connectivity check: `sheets` limits the diff to parts and nets on the
    given sheets; renames collapse into one count line and a net that kept
    its name shows its pin delta, `detail` restores the full lists.
    - klc check: symbol positions in mm as well as mils, the shift that
    centres a symbol for S3.1, and an in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
2026-10-29 feat(kicad-toolkit): Added library sources, library descriptions and pad settings
    - Every library entry says where it comes from (project, stock or the
    user's global libraries); ops refuse to write stock and user libraries.
    - New libraries need a description; lib_set_library sets one on an
    existing project library, with libraryDescriptionSuffix from
    .omp/kicad.json appended. Lib tables are written one line per library.
    - lib_symbol reports legacy hidden pin stacks (KLC S4.3) and their
    KiCad 10 form.
    - lib_footprint reports pad corner radii, chamfers and mask, paste,
    clearance and zone overrides, and footprint-level overrides; the pad
    inputs of lib_create_footprint and the pad edi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
2026-10-29 feat(kicad-toolkit): Added change_symbol, the wires and next_ref queries and junction cleanup
    - change_symbol swaps a placed part for another library symbol in
    place (or refreshes it from its edited library), keeping the sourcing
    fields and reporting the wiring it no longer meets.
    - remove_wire takes a from/to stretch inside one segment.
    - Junctions follow KiCad's connection count: edits drop the ones left
    joining fewer than 3 connections, and the wiring check warns on
    redundant junctions.
    - New queries: wires (a region's segments with what sits at their ends
    and middles) and next_ref, which previews exactly the references
    add_symbol assigns.
2026-10-29 feat(kicad-toolkit): Added bus editing, multi-part set_fields and field filters
    - add_bus, remove_bus, add_bus_entry and remove_bus_entry, with the
    junctions a bus T needs and none on bus entries (KiCad's
    IsExplicitJunctionNeeded); the wiring check reports bus Ts without a
    junction.
    - set_fields takes `refs` to set the same fields on several parts.
    - The symbols query filters on any field pattern and adds fields as
    columns; the rules query returns each rule's comment.
2026-10-29 fix(kicad-toolkit): Parsed shell lines in the hook and ignored stale KiCad locks
    - Hook: shell lines are split into commands outside quotes, with
    command substitutions, `sh -c` payloads and `eval` arguments read as
    commands; quoted words of ordinary commands and pkill/killall targets
    no longer count as running KiCad.
    - kicad_edit ignores a stale KiCad lock file (this host and user, no
    KiCad running) and says so; it still refuses while KiCad has the
    project open.
    - kicad_datasheet resolves an LCSC code or lcsc.com page to the part's
    PDF.
    - set_rule writes, keeps or replaces the comment lines above a rule.
2026-10-29 docs(skills): Clarified KiCad toolkit rules across agent skills and guidelines
    - KiCad files may be changed only through the toolkit, and lock file handling is described.
2026-10-29 feat(hardware): Drove the MagJack LEDs from the IP101GRI PHY
    J2's green LED shows link/activity (LED0, sinks to +3V3) and the yellow one
    shows a 100 Mb/s link (LED3, sources to GND), each through 220 ohm (R69, R70).
    R71 (5.1k) pulls CRS/LEDMOD up for LED mode 2. The wiring keeps the PHY_AD0/AD3
    straps (address 1) as IP101G DS Fig. 12 shows. SCHEMATIC.md gains a Jack LEDs
    section and the +3V3 budget the LED current (total 0.78 A).
    [ethernet.kicad_sch]
2026-10-29 docs(skills): Defined design assumptions for KiCad schematic reviews
    The review skill gains a Design assumptions section that reviewers get
    verbatim: sources within their standard, the project's accessories
    working, rails within ±5 % of nominal in spec, no TCR or 85 °C leakage
    stacking, latest silicon revision, and no firmware rules that only guard
    against misconfiguration. The merge step drops findings that rest on
    excluded cases. The checklist scopes worst case, IC-1, ANA-3, PWR-1 and
    PROT-1…4 accordingly, and the edit skill's checklist walk follows it.
2026-10-29 fix(hardware): Applied the espion-cam schematic review fixes
    - Camera: R37 fitted (the module is powered at 3.3 V from J3); XVS/STROBE
    nets renamed XVS_CAM/STROBE_CAM since the module's level is unknown;
    R31/R32 documented as an assembly option (1.8 V default, 2.8 V, 3.3 V)
    with a bring-up step; notes on J3 pad numbering and the divider.
    - MCU: D2 (VBUS TVS) moved from the Power sheet to J1; notes on U2 pin 5
    and the R27 PPS loop-back.
    - LED driver: R72 1 k in series before C43, so U7 no longer drives the
    10 nF timeout cap directly (STROBE_RC); timeout 0.78-1.32 ms.
    - Ethernet: C5/C7 drawn at pins 13/31, R11/R12 labels separated, TP14 on
    PHY_RST_N; MDI spacing rule exempts U6's c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
    [camera.kicad_sch, ethernet.kicad_sch, imu.kicad_sch, led_driver.kicad_sch, mcu.kicad_sch, power.kicad_sch]
2026-10-30 docs(hardware): Replaced SCHEMATIC.md with plain-language docs in docs/hardware
    The schematic is now the source of truth for connections and parts. docs/hardware/ keeps what it can't hold: decisions, derived values with their reasons, accepted risks, layout constraints and firmware rules (one doc per block plus layout.md and firmware-rules.md). architecture.md, protocol.md and timing.md got a shorter, plain-words pass. AGENTS.md, the READMEs, the kicad skills, the review checklist and the camera sheet notes point at the new docs. The KiCad toolkit gains set_rules_header and a header field in the rules query.
    [camera.kicad_sch]
2026-10-30 docs(skills): Counted accessible passive pads as probe points in the review checklist
    FW-4 no longer asks for a test point on a net that already has an accessible series resistor, pull, divider or decoupling capacitor: its pad is the probe point.
2026-10-30 fix(hardware): Drew PHY_3V3 with power symbols instead of labels
    The four PHY_3V3 labels on the Ethernet sheet become power symbols (stock power:+3V3 with Value PHY_3V3, mapped in .omp/kicad.json powerSymbols, as +32V uses power:+36V). The net is now the global PHY_3V3 with the same pins; the PWR_3V3 net class pattern follows it.
    [ethernet.kicad_sch]
2026-10-30 feat(hardware): Added 22 Ω series resistors on the RMII TX lines at the P4
    R73 (TXD0), R74 (TXD1) and R75 (TX_EN) terminate the P4-driven RMII lines at the source, like R11-R14 on the PHY-driven ones. The BOOT strap (R2, R3, SW2) stays on the P4 side of R74 via RMII_TXD1_MCU. The {PHY} bus moved right to make room; the RMII net class takes the new /MCU/RMII_TX*_MCU nets.
    [mcu.kicad_sch]
2026-10-30 refactor(espion-cam): Removed unused PWR_FLAG symbols and stale buses from schematics
    - Removed embedded PWR_FLAG library symbols from the Ethernet schematic.
    - Removed stale bus segments from the MCU and IMU sheets.
    - Updated KiCad project settings to match the cleaned-up schematic state.
    [espion-cam.kicad_sch, ethernet.kicad_sch, imu.kicad_sch, led_driver.kicad_sch, mcu.kicad_sch]
2026-10-30 feat(hardware): Lengthened the ESP32-P4-Core pads to 1.5 mm past the edge for hand soldering
2026-10-30 feat(hardware): Split the ESP32-P4-Core footprint into reflow and hand-soldering variants
    The reflow footprint is back to 0.6 x 1.5 mm pads with paste. The new _HandSolder variant has 0.6 x 2.5 mm pads reaching 1.5 mm past the module edge and no paste, so the stencil leaves the module out; U1 uses it. KLC F6.1 is waived for the variant only.
    [mcu.kicad_sch]
2026-10-30 feat(hardware): Added 3D models for the WS2812B-2020, AFA07-S15ECA-00 and TS-1187A
    KiCad ships no model for the stock footprints of D1, J3 and SW1/SW2. Copied
    them into project libraries (LED_SMD_Worldsemi, Connector_FFC-FPC_JUSHUO,
    Button_Switch_SMD_XKB) with pads unchanged and SolidCraft models built from
    the manufacturers' drawings (scripts in hardware/lib/3d-src). J3's copy is
    named after the fitted top-contact ECA part and keeps the stock anchor (KLC
    F6.2 waived). README Parts entries and the mcu/camera docs updated.
    [camera.kicad_sch, mcu.kicad_sch]
2026-10-30 chore(espion-cam): Re-annotated the whole schematic in sheet order
    Reset every reference designator and re-annotated the project from scratch,
    following the sheet order (root, Ethernet, Power, MCU, Camera, LED driver,
    LED ring, IMU). The numbering had drifted through additions and removals;
    it now runs without gaps.
    - Parts: R, C, U, J and TP were renumbered (now R1-74, C1-51, U1-12, J1-4,
    TP1-14). The Ethernet sheet now starts each series (U6 -> U1, J2 -> J1,
    TP14 -> TP1), the ESP32-P4 module moved U1 -> U6 and the camera
    connectors J3/J4 swapped. D, L, Q, SW, H, TH, NT and Y kept their numbers.
    - Power and flag symbols: the per-sheet hundreds blocks (#PWR1xx on the
    root, #PWR2xx o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
    [camera.kicad_sch, espion-cam.kicad_sch, ethernet.kicad_sch, imu.kicad_sch, led_driver.kicad_sch, led_ring.kicad_sch, mcu.kicad_sch, power.kicad_sch]
2026-10-30 feat(espion-cam): Added board layout and project settings for espion-cam
    - Populated the KiCad PCB with stackup, general, and plotting configuration.
    - Expanded project design defaults and adjusted differential pair via gap settings.
    [espion-cam.kicad_pcb]
2026-10-30 feat(kicad-toolkit): Added PCB support
    The toolkit could only change schematics, project settings and libraries, so
    the board could not be set up without bypassing it. Board edits now go through
    the same transaction: ops in memory, KiCad re-saves a staged copy, then gates
    (no new DRC violation, no new schematic-parity issue, netlist unchanged).
    - Ops (group board): set_stackup, set_board_rules, set_board_edges (outline and
    cutouts, per-vertex fillets incl. concave), update_from_schematic, place_footprint,
    set_footprint_field.
    - Queries: board, footprints, footprint. Check: drc (DRC + schematic parity).
    kicad_render takes board: true (2D plot or 3D raytrace).
    - A new violation confined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
    [board.kicad_pcb, board.kicad_sch, four-layer.kicad_pcb, led.kicad_sch]
2026-10-30 feat(hardware): Added a 3D model of the SZYTF OV9281 camera module
    The module is not on the board: the enclosure holds it 10 mm behind the PCB.
    The STEP is for the full enclosure assembly. Built with SolidCraft from the
    seller's drawing WX-1M-9281-79-V1.0 (board, mounting holes, lens block, FFC
    connector height); undimensioned features (board edge position, small holes,
    back pads, connector depth) are estimated from the product photos and marked in
    the script. New Module_SZYTF.3dshapes library and a README Parts entry.
2026-10-30 docs(espion-cam): Updated part references after the re-annotation
    06fda6a renumbered the schematic but the docs, the custom design rules,
    .omp/kicad.json and two MCU sheet notes still named the old references (e.g. the
    P4 module as U1, now U6; the PHY as U6, now U1; the CSI 0 ohm links as R38-R43,
    now R45-R47 and R49-R51). Every reference now names the same part as before.
    - espion-cam.kicad_dru: MIPI_CSI spacing, MDI spacing and PoE isolation name the
    new references, so they apply to the right parts again.
    - .omp/kicad.json: fieldExempt and decouplingExempt follow the renames.
    - The PHY_3V3 rail and its 0 ohm link were removed from the schematic in 827851f;
    the ethernet and firmware-ru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
    [mcu.kicad_sch]
2026-10-30 feat(espion-cam): Set up the board
    The camera module now sits in the enclosure 10 mm behind the board, looking
    through a cutout, and every part goes on the top side.
    - Stack-up JLC04161H-7628 (7628 prepreg, NP-155F core) with OSP finish.
    - Board-wide minimums at JLCPCB's no-surcharge multilayer limits.
    - All 183 footprints imported (schematic parity 0).
    - 90 x 86 mm outline, R1 corners, a 16 mm lens cutout sized to the 79 deg view
    cone, and an 18 x 3 mm notch in the bottom edge for the camera FFC.
    - Placed and locked: H1-H4 in the corners, J1 (RJ45) and J2 (USB-C) on the top
    edge, D4-D15 on r = 11.5 mm round the lens, J4 above the notch. U2 and U6
    placed, not locked.
    - J4 rewired to p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
    [camera.kicad_sch, espion-cam.kicad_pcb]
2026-10-30 feat(kicad-toolkit): Added PCB copper model, layout ops, board checks and kicad_export
    Copper model (tracks, arcs, vias, zones, rule areas, board graphics; KiCad 10 connectivity and length rules), queries (copper, routing, lengths, zones, board_free_space, distance, board_graphics, stats), render overlays (nets, ratsnest, copper preset), board ops (tracks, diff pairs, vias, DRC-checked stitching, zones, rule areas, texts, drawings, board-only footprints, side flip, board setup), gate with committed zone fills and routing-in-progress reporting, board checks (track_widths, return_path, via_return, decoupling_placement, placement, layout) with a layout config section, and kicad_export (JLCPCB g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
    [copper.kicad_pcb, layout.kicad_pcb, layout.kicad_sch]
2026-10-30 docs(skills): Added kicad-pcb-layout and kicad-pcb-review skills
2026-10-30 feat(espion-cam): Moved the lens, LED ring and J4 to 27 mm from the right and bottom edges
    Lens axis (165, 159) -> (163, 159); the FFC notch moves with it. Updated layout.md and the lens view cone height zone.
    [espion-cam.kicad_pcb]
2026-10-30 fix(espion-cam): Kept the LED current under the LEDs' 1 A maximum and fixed review findings
    - R60 47k -> 51.1k 1% (0402WGF5112TCE, C25904): sink 0.892 A typ, 0.78-0.99 A worst case
    (was up to 1.08 A); docs updated for every value derived from the current.
    - Firmware rule 5: on a thermal/NTC fault keep LED_EN high to drain C46/C47 through the ring.
    - Doc corrections: LC filter bound and mux margins, boost capacity at minimum input, shield
    resistor ratings, LEDMOD reference, GPIO36 pull-up R46, 100 ns RMT tick, IMU current,
    U5 not on VBUS.
    - Review checklist FW-2: firmware code compliance is out of scope for schematic reviews.
    [led_driver.kicad_sch]
2026-10-30 feat(espion-cam): Placed every part and drew the keep-out rule areas
    - Placed all 183 footprints on the top side; U6 moved 3 mm down for a
    routing corridor under J2. Buttons and status LED at the top edge,
    J3 beside the FFC notch, C11 at the end of U2's pin row (near limit
    relaxed to 4 mm).
    - Rule areas: FFC notch, lens cutout, PoE cable side.
    - Settled the library-footprint DRC errors: U1 and U10 use the
    footprints without 0.2 mm thermal vias (0.3 mm vias at routing);
    custom rules `U12 LGA pads` and `J2 USB pins` exempt the land patterns.
    - Fixed the placement review: hand-soldering room around U6, U1
    bottom-row escapes, RD escape, TLV62569 and TPS61170 per TI's layout
    example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
    [espion-cam.kicad_pcb, ethernet.kicad_sch, led_driver.kicad_sch]
2026-10-30 fix(espion-cam): Excluded the DNP link R52 from the BOM
    R52 drops its sourcing fields; camera.md names the 0805 0 Ω to fit if a module needs it.
    [camera.kicad_sch, espion-cam.kicad_pcb]
2026-10-31 fix(espion-cam): Fixed the placement review findings
    Placement:
    - U5 turned 180° so the USB pair lands on R31/R32 without a P/N swap;
    the pair runs north of R34–R39, leaving U6 pins 40–47 their via strip.
    - R6 right, C4 turned: room for the RD swap vias at 0.55 mm. C7 up for
    the crystal guard; R10 down to free the via corner left of R4.
    - C15/C16 turned and raised to free U4's OUT pad exits; R18–R21 up.
    - R61/C40/C44 turned so ISET and U11's ground route cleanly; C38 at
    TI's input-cap position above U10.
    - R31/R32 1 mm from C47; R70/R72/C48/C49 turned parallel to C46.
    - C1 and R3 swapped (C1 away from H1); C34 parallel to the right edge;
    C28/C29 ≥ 1.3 mm from U6's pad ends;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
    [espion-cam.kicad_pcb, led_driver.kicad_sch]
2026-10-31 fix(kicad-toolkit): Skipped a footprint's own rule areas in the placement check
    The placement check flagged a footprint whose courtyard overlaps its own
    keep-out (the stock ToolingHole_1.152mm carries an r 0.7 mm ring on every
    copper layer). It now skips rule areas the checked footprint owns; other
    footprints' and board-level rule areas are still errors. KiCad's DRC
    already behaves this way.
2026-10-31 fix(espion-cam): Fixed the second placement review findings
    Assembly (JLCPCB Economic PCBA, user decisions 2026-10-31):
    - CSI links R45–R47/R49–R51 0201 → 0402 0 Ω (UNI-ROYAL 0402WGF0000TCE,
    LCSC C17168): Economic places 0402 and larger only.
    - Finish OSP → leaded HASL (Economic offers HASL/ENIG only); flatness
    for U1's 0.4 mm QFN and U12's LGA accepted.
    - Tooling holes TOOL1–TOOL3 (1.152 mm NPTH, stock footprint).
    - Chip parts ≥ 1.0 mm from U1, U4, U10 and U12 (JLCPCB QFN spacing):
    C50, C51, C15, C16, R22, C21, C38, C45, R62, C39, R66, R9, R11, R15,
    C9, C6 moved; TP2, C20, R65, C41, R14 moved to make room.
    - Every reference designator moved from the silkscreen to F.Fab.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
    [camera.kicad_sch, espion-cam.kicad_pcb]
2026-10-31 feat(kicad-toolkit): Added a hand-assembly list and assembly drawings to kicad_export
2026-10-31 feat(espion-cam): Listed the hand-assembled parts for kicad_export
2026-10-31 fix(espion-cam): Added switchover hysteresis and a CP2 filter to the TPS2121 mux
    [power.kicad_sch]
2026-10-31 fix(espion-cam): Added an ESD clamp on the BOOT button
    [mcu.kicad_sch]
2026-10-31 fix(espion-cam): Retuned the STROBE timeout for 0.5 ms pulses and fixed the U8 description
    [led_driver.kicad_sch]
2026-10-31 fix(espion-cam): Changed J4 to the bottom-contact AFA07-S15FCA-00 for the module's cable
    [camera.kicad_sch]
2026-10-31 feat(hardware-lib): Added the Yongyu YY-0807 RGB LED and the JUSHUO AFA07-S15FCA-00 footprint with their 3D models
2026-10-31 fix(espion-cam): Changed D1 to the Economic-placeable Yongyu YY-0807RGBJ26-07-FJ and J4 to its own FCA footprint
    [camera.kicad_sch, mcu.kicad_sch]
2026-10-31 feat(espion-cam): Brought the schematic fixes onto the board
    [espion-cam.kicad_pcb]
2026-10-31 fix(espion-cam): Lowered the LED current to 0.83 A to stay on the LED derating curve at 30 °C
    [led_driver.kicad_sch]
2026-10-31 fix(espion-cam): Replaced the Standard-only +32 V bulk capacitors and the out-of-stock 10 nF C0G parts with Economic-placeable ones
    [led_driver.kicad_sch]
2026-10-31 feat(espion-cam): Set the ENIG JLC04161H-7628 stack-up and re-derived the board rules, net classes and custom rules
    [espion-cam.kicad_pcb]
2026-10-31 fix(espion-cam): Replaced the Standard-only LSM6DS3TR-C IMU with the Economic-placeable MEMSensing MSA3S02 accelerometer
    [espion-cam.kicad_pcb, imu.kicad_sch]
2026-10-31 feat(espion-cam): Placed every part on the 64 × 64 mm outline with the lens cutout and FFC notch
    - Board outline 64 × 64 mm with r1 corners, an 18 × 3 mm FFC notch at the top
    edge and a Ø16 cutout on the lens axis (129.7, 130.3); M3 holes at 3.5 mm
    from both edges; three Ø1.152 tooling holes (top left, bottom right, bottom
    left).
    - U2, J1 and U6 on the back (J1 opening on the right edge, U2 along the left
    edge, U6 with its CSI side north); every other part on the front, inside the
    outline, with JLCPCB's recommended SMD spacing (one exception: C15 at U4).
    References moved onto the fab layers, centred on each part.
    - Rule areas replaced: lens cutout, FFC notch, PoE pin fields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
    [espion-cam.kicad_pcb]
2026-10-31 fix(espion-cam): Fixed the placement review findings
    U1 moved next to J1 so MDI stays on F.Cu without vias. The buck was re-placed to TLV62569 Fig. 20 (U3 turned 180°), the boost SW node was tightened and C47 moved off Q1. The CSI crossing zone moved north of the PoE lane. In2 is now solid GND, and In1 is GND except the PoE lane. J1 pads were trimmed to 1.45/2.35 mm for PoE creepage. The tooling holes now use the JLCPCB 0.148 mm mask part. Added a power neck-down DRC rule, RMII length limits, BOOT stub path, Q1 copper area and CSI via parity. Silkscreen: J4 pin 1 and contacts, USB/TRIG/BOOT/RST, PoE warnings, date.
    [espion-cam.kicad_pcb]
2026-10-31 docs(hardware-lib): Pointed the tooling hole's source at the JLCPCB article
2026-11-01 fix(espion-cam): Fixed the second placement review findings
    The In1 PoE lane is redrawn as one channel at least 2.2 mm wide, south of a new CSI link field. The six 0 ohm links move north-east in U6 order with via strips, and the CSI crossing moves to B.Cu. R52, TP10 and C3 moved clear of the lane. C7, C6, R12, R10, R14 and R7 now keep at least 1.0 mm to U1's pads, with R8 and R6 shifted up to make room. The PoE marks moved to the top silkscreen beside the U2 and J1 PoE pins, and the J4 pin-1 mark moved. The Q1 copperArea is set to the copper that fits, and the CSI/CAM viaParity notes are updated.
    [espion-cam.kicad_pcb]
2026-11-01 feat(kicad-toolkit): Added ERC and DRC exclusion editing
2026-11-01 fix(kicad-toolkit): Told stale ERC exclusions from live ones by an ERC run without the exclusions
2026-11-01 fix(espion-cam): Fixed the third placement review findings
    [espion-cam.kicad_pcb]
2026-11-01 feat(espion-cam): Routed the CSI and CAM pairs with their return vias
    [espion-cam.kicad_pcb]
2026-11-01 fix(espion-cam): Centred the CSI bus on the In2 neck past J1
    [espion-cam.kicad_pcb]
2026-11-01 feat(espion-cam): Routed the power block
    [espion-cam.kicad_pcb]
2026-11-01 fix(espion-cam): Fixed the round-3 review findings at the notch and the CSI bus
    [espion-cam.kicad_pcb]
2026-11-01 fix(espion-cam): Swapped the MDI pairs at J1 for a via-free route
    [espion-cam.kicad_pcb, ethernet.kicad_sch]
2026-11-01 feat(espion-cam): Routed the Ethernet MDI pairs and the U1 north-row escapes
    [espion-cam.kicad_pcb]
2026-11-01 fix(espion-cam): Cleared the CSI_D0 bump off the coupling threshold
    [espion-cam.kicad_pcb]
2026-11-01 feat(espion-cam): Routed the Ethernet PHY east escapes, RX lines and crystal
    [espion-cam.kicad_pcb]
2026-11-01 fix(espion-cam): Straightened the power block routing to 45° and 90° bends
    [espion-cam.kicad_pcb]
2026-11-01 fix(espion-cam): Straightened the ETH_CT routing to 45° and 90° bends
    [espion-cam.kicad_pcb]
2026-11-01 fix(espion-cam): Straightened the CSI and CAM via-field jogs to 45° and 90° bends
    [espion-cam.kicad_pcb]
2026-11-01 fix(espion-cam): Straightened the CSI bus through the D29 neck to 45° and 90° bends
    [espion-cam.kicad_pcb]
2026-11-01 fix(espion-cam): Straightened the PoE lane routing to 45° bends
    [espion-cam.kicad_pcb]
2026-11-01 fix(espion-cam): Chamfered the remaining 90° and 135° track bends into 45° bends
    [espion-cam.kicad_pcb]
2026-11-01 fix(espion-cam): Restored the J1 shield chamfer on the In1 PoE lane rule area
    [espion-cam.kicad_pcb]
2026-11-01 feat(espion-cam): Routed the remaining Ethernet signal nets and moved C9 and R13 for the LED3 trunk
    [espion-cam.kicad_pcb]
2026-11-01 fix(kicad-toolkit): Joined a clipped track chain to its via or pad at the clipped end, so a path runs through a track wholly inside a via
2026-11-01 feat(espion-cam): Routed the Ethernet +3V3 supply and U1.1 ground and reworked the REF_CLK split
    [espion-cam.kicad_pcb]
2026-11-01 feat(espion-cam): Routed the USB block and moved D2, R24, R25, R31 and R32 for it
    [espion-cam.kicad_pcb]
2026-11-01 feat(espion-cam): Routed the LED ring, the Q1 drain copper and the boost stage
    [espion-cam.kicad_pcb]
2026-11-01 feat(espion-cam): Routed the +32V corridor north and east of Q1, the LED pad joins and the LED driver sense nets
    [espion-cam.kicad_pcb]
2026-11-01 fix(espion-cam): Moved PHY_RST_N to GPIO21 for routing
    [espion-cam.kicad_pcb, mcu.kicad_sch]
2026-11-01 feat(espion-cam): Routed the Q1 gate drive, the NTC sense line and PHY_RST_N to GPIO21 and moved R63, R64 and R14
    [espion-cam.kicad_pcb]
2026-11-01 feat(espion-cam): Routed the rest of the LED driver nets and moved VLED_SENSE to GPIO21, PHY_RST_N to GPIO22, XVS to GPIO7 and LED_EN to GPIO11
    [espion-cam.kicad_pcb, mcu.kicad_sch]
2026-11-01 fix(espion-cam): Moved IMU_INT1 to GPIO51 for routing
    [espion-cam.kicad_pcb, mcu.kicad_sch]
2026-11-01 feat(espion-cam): Routed the first block-5 camera and strobe links
    [espion-cam.kicad_pcb]
2026-11-01 feat(espion-cam): Routed the west camera bundle, XVS, STROBE and STATUS_LED and moved LED_PWR_EN to GPIO20 and VBUS_SENSE to GPIO6
    [espion-cam.kicad_pcb, mcu.kicad_sch]
2026-11-01 feat(espion-cam): Routed the block-5 GND vias, moved U12 0.4 mm west and gave IMU_INT1 a via under U12
    [espion-cam.kicad_pcb]
2026-11-01 feat(espion-cam): Routed the last block-5 nets (+3V3 islands, CAM_3V3, BOOT_SW, U5 supply) and reworked D- at U5, TX_EN and REF_CLK for them
    [espion-cam.kicad_pcb]
2026-11-01 fix(espion-cam): Fixed the step-6 schematic drawing and field findings
    [camera.kicad_sch, espion-cam.kicad_pcb, ethernet.kicad_sch, imu.kicad_sch, mcu.kicad_sch, power.kicad_sch]
2026-11-01 fix(hardware-lib): Shortened the MSA3S02 corner lands for JLCPCB's 0.15 mm pad-to-pad clearance
2026-11-01 fix(espion-cam): Updated U12 to the shortened corner lands and raised the U12 LGA pads rule to 0.15 mm
    [espion-cam.kicad_pcb]
2026-11-01 feat(kicad-toolkit): Added a footprint graphics width op to kicad_edit
2026-11-01 fix(espion-cam): Removed the remaining 90° corners and the D39 off-angle MDI escapes
    [espion-cam.kicad_pcb]
2026-11-01 fix(espion-cam): Switched D1 to the YY-0807BRGK26-07-FI and moved J2 0.25 mm towards the board edge
    [espion-cam.kicad_pcb, mcu.kicad_sch]
2026-11-01 fix(espion-cam): Matched the MDI pair lengths and opened the RX/TX corridor north of U1
    [espion-cam.kicad_pcb]
2026-11-01 fix(espion-cam): Separated REF_CLK from the RMII data lines, added RMII return vias and moved R12 off U1
    [espion-cam.kicad_pcb]
2026-11-02 fix(espion-cam): Fixed the step-6 power and MCU layout findings
    [espion-cam.kicad_pcb]
2026-11-02 fix(espion-cam): Fixed the step-6 LED driver layout findings
    [espion-cam.kicad_pcb]
2026-11-02 fix(espion-cam): Labelled the test points on the silkscreen
    Partial: TP3, TP5, TP6, TP10, TP12, TP14 labelled; the other test points have no room yet.
    [espion-cam.kicad_pcb]
2026-11-02 fix(espion-cam): Routed the IMU bus away from the buck switch node
    [espion-cam.kicad_pcb]
2026-11-02 fix(espion-cam): Labelled the remaining test points on the silkscreen
    [espion-cam.kicad_pcb]
2026-11-02 fix(espion-cam): Raised the silkscreen line widths to JLCPCB's 0.15 mm minimum
    [espion-cam.kicad_pcb]
2026-11-02 fix(espion-cam): Spread the MDI swap vias and confined the MDI spacing exemption to U1's escape area
    [espion-cam.kicad_pcb]
2026-11-02 fix(espion-cam): Narrowed the U10 switch-node exit to TI's land spacing
    [espion-cam.kicad_pcb]
2026-11-02 fix(espion-cam): Cleared the polarity marks and labels of neighbouring pads
    [espion-cam.kicad_pcb]
2026-11-02 fix(espion-cam): Corrected the silk rule comment on pad-to-silkscreen checking
2026-11-02 feat(kicad-toolkit): Added a schematic field placement op to kicad_edit
2026-11-02 fix(espion-cam): Moved ISET clear of the MDI escape and labelled TP9
    [espion-cam.kicad_pcb]
2026-11-02 fix(kicad-toolkit): Kept pad-to-pad paths on every piece of a track line, so no short piece is skipped where copper overlaps across it
2026-11-02 fix(espion-cam): Moved the D1 value text off the +3V3 wire
    [mcu.kicad_sch]
2026-11-02 docs(espion-cam): Rewrote the board design documentation from the verified design
2026-11-02 fix(espion-cam): Added the MDI pair-to-pair and skew rules and pointed the rule comments at the board docs
2026-11-02 feat(kicad-toolkit): Added LCSC-code keys to the JLCPCB placement corrections
    JLCPCB's rotation follows its library entry per LCSC part, so parts on one footprint can need different corrections (SOT-23-5/-6 on espion-cam). A key that is an LCSC code matches the parts with that LCSC field and wins over any footprint pattern; other keys stay footprint patterns, first match wins.
2026-11-02 fix(espion-cam): Added the JLCPCB placement corrections
    Checked in JLCPCB's placement preview of the 7b318e1 export: J4 and J2 offset to their land-pattern centres, Q1 rot 90 and offset, U1, U4 and U12 rot -90, the LED ring rot 180, SOT-23 parts by LCSC code (U3, U7, U8, U9 rot 180; U5, U11 rot -90), 21 footprint types confirmed without correction. D1 has no JLCPCB model and stays unconfirmed (JLCPCB placement confirmation ordered).
2026-11-02 fix(espion-cam): Revised PoE isolation and MIPI clearance rules in camera layout
    - Rewrote the PoE cable-side clearance rule and tightened MIPI_CSI clearance to cover XVS, STROBE and RMII nets.
    - Trimmed the REF_CLK length constraint to the MAC branch and updated hardware documentation to match the layout.
    [espion-cam.kicad_pcb]
2026-11-02 fix(espion-cam): Poured the grouped power pins and routed track ends to pad and via centres
    [espion-cam.kicad_pcb]
2026-11-02 fix(espion-cam): Poured the remaining short power links and rerouted more track ends to pad centres
    [espion-cam.kicad_pcb]
2026-11-02 fix(espion-cam): Rerouted the LED ring so every link leaves and enters its pads along a pad axis
    [espion-cam.kicad_pcb]
2026-11-02 fix(espion-cam): Routed the fine-pitch PHY pins and short pad links to pad centres
    [espion-cam.kicad_pcb]
2026-11-02 fix(espion-cam): Centred the CAM_EN, STROBE_HP, SS and ETH_SHIELD pad and via entries
    [espion-cam.kicad_pcb]
2026-11-02 fix(espion-cam): Poured the boost switch node, the LED cathode and the current-sense source
    [espion-cam.kicad_pcb]
2026-11-02 fix(espion-cam): Centred the FB_3V3, RMII_TXD0 and shield-bleed pad entries; moved the two ETH_SHIELD_R vias
    [espion-cam.kicad_pcb]
2026-11-02 fix(espion-cam): Centred the PHY supply, regulator-output and crystal entries around U1
    [espion-cam.kicad_pcb]
2026-11-02 fix(espion-cam): Centred the BST_EN, VBUS_SENSE, CP2 and PR1 pad entries
    [espion-cam.kicad_pcb]
2026-11-02 fix(espion-cam): Rerouted NTC_SENSE to the pad centres and moved its via and C48 GND via
    [espion-cam.kicad_pcb]
2026-11-02 fix(espion-cam): Routed XVS from the U6.9 pad centre and moved the +32V via beside it
    [espion-cam.kicad_pcb]
2026-11-02 fix(espion-cam): Centred the USB D+ tee at U5, the J2.B7 entry and dropped a dangling D- stub at R32
    [espion-cam.kicad_pcb]
2026-11-02 fix(espion-cam): VBUS leaves J2.A4/B9 from the pad centre
    [espion-cam.kicad_pcb]
2026-11-02 fix(espion-cam): Centred CSI and RMII-pair pad entries where lengths stay matched
    [espion-cam.kicad_pcb]
2026-11-02 fix(espion-cam): CAM_D0 pair enters J4, its vias and R47/R51 on axis, skew kept within 0.127 mm
    [espion-cam.kicad_pcb]
2026-11-02 fix(espion-cam): CAM_D1 pair enters J4, its vias and R46/R50 on axis
    [espion-cam.kicad_pcb]
2026-11-02 fix(espion-cam): CAM_CLK pair turns outside the J4 pads
    [espion-cam.kicad_pcb]
2026-11-02 fix(espion-cam): CAM_CLK and CSI_CLK vias at R45/R49 moved onto the pad axes
    [espion-cam.kicad_pcb]
2026-11-02 fix(espion-cam): MDI pairs enter J1.1, J1.2 and their PHY-side vias on axis
    [espion-cam.kicad_pcb]
2026-11-02 fix(espion-cam): Removed acute track junctions and dead stubs inside pads and vias
    [espion-cam.kicad_pcb]
2026-11-02 fix(espion-cam): ETH_RD_P back on its coupled lane, entering J1.4 radially
    [espion-cam.kicad_pcb]
2026-11-02 fix(espion-cam): Joined the ETH_TD_P and LED_PWR_EN track ends that missed by a fraction of a micron
    [espion-cam.kicad_pcb]
2026-11-02 fix(espion-cam): Kept the CAM_3V3, R41/R42 +3V3 and U5 GND pours 1.0 mm off the In1 PoE copper
    [espion-cam.kicad_pcb]
2026-11-02 fix(espion-cam): Kept the LED_K pour as far from the crystal as Q1's tab (1.42 mm from C2.1)
    [espion-cam.kicad_pcb]
2026-11-02 fix(espion-cam): 90° turns at CAM_EN, SCCB_SDA, LED_EN and ETH_TD_P keep a 45° leg at least the track width
    [espion-cam.kicad_pcb]
2026-11-02 fix(espion-cam): Kept the BST_SW pour 0.4 mm off U10's other pads and the U1 GND pour as far from the MDI pins as U1's exposed pad
    [espion-cam.kicad_pcb]
2026-11-02 fix(espion-cam): Removed the +3V3 neck past H1, the CC2 and ETH_SHIELD_R detours and the XVS_CAM and GND-stub hooks; JLCPCB fab rules
    - +3V3 north loop 0.4 mm throughout, east of J2's NW shield pad (3.901 mm from H1); CC1 alongside it
    - CC2 direct under J2's pad row (4.81 mm); R23 moved 0.24 mm south, its GND via replaced by a pour to the shield pad
    - XVS_CAM leaves TP8 in one radial segment; LED_ON into TP12 straightened
    - GND stub vias of C11.2, C14.2, C22.2, R19.2 and J4's east MP pad on the pad axis; C37.2 loop removed
    - R2 turned: ETH_SHIELD_R one 1.675 mm link (was 13.3 mm, two vias)
    - +3V3 feeds widened (B.Cu camera feed 0.4, R41/R42 feed 0.5)
    - Rules: hole_to_hole and text size as er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
    [espion-cam.kicad_pcb]
2026-11-03 fix(espion-cam): Routed +32V off the copper under U6 and cleaned up overlapping joints, U1 pin stubs and split straight tracks
    Routing review follow-up (user decisions 2026-11-03):
    - +32V: the boost-to-C47 leg no longer hops to B.Cu under the module.
    It runs on F.Cu from D3.1 under SW1, between SW1.2 and C29.1
    (0.43 mm, LED_PWR pad spacing 0.4 mm) and along the bottom edge to
    C47, 0.4 mm wide (recharge current only, about 0.22 A peak).
    No +32V copper is left on B.Cu under U6.
    - Geometry: ten overlapping joints rebuilt on centrelines or shared
    points, the stubs inside U1.1 and U1.32 removed, and straight runs
    of one width merged. The ETH_TD_P split that keeps the
    "U1 MDI escape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
    [espion-cam.kicad_pcb]
2026-11-03 feat(espion-cam): Boost headroom control: PWM on BST_EN and an LED_K divider (R70/R76, LED_K_SENSE on GPIO23) replacing the NTC
    Firmware sets +32V just above the LED string from Q1's drain voltage (FW-8, FW-22), cutting Q1's dissipation from up to 0.73 W to <= 0.083 W. TH1 becomes R76 10.0k, R70 100k from LED_K, C48 1 nF C0G; board updated in place, docs and parts list updated.
    [espion-cam.kicad_pcb, espion-cam.kicad_sch, led_driver.kicad_sch, mcu.kicad_sch]
2026-11-03 fix(espion-cam): Removed 43 dead track stubs inside pads and vias; layout.md via, fill and track_widths figures re-measured
    Every removed piece lay wholly inside one pad or via of its net with an end joined to nothing (16 in vias, 27 in pads,
    among them the floating USB_C_D_N diagonal in U5.3). No connectivity change; DRC clean, track_widths 58 -> 56 (the
    +5V 0.5/0.3 mm and LED_K 0.5 mm groups were these stubs), return_path 8 and via_return 3 unchanged.
    [espion-cam.kicad_pcb]
2026-11-04 fix(espion-cam): MDI pairs P/N-inverted between U1 and J1, swap vias and B.Cu hops removed, both pairs on F.Cu only; docs updated
    [espion-cam.kicad_pcb, ethernet.kicad_sch]
2026-11-04 fix(espion-cam): Board review 2026-11-04: XVS off U2's magnetics, C38 at U10, R24 turned, 0402 pour reliefs, via and TP3 moves, buttons locked, ${ISSUE_DATE} silk, legible fab drawings; docs re-measu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
    [espion-cam.kicad_pcb]
2026-11-04 docs(hardware): KiCad files are the source of values; docs keep requirements, decisions and formulas
    Removed from docs/hardware/, the board README and the kicad.json/.kicad_dru texts every value
    the schematic or layout holds or that is calculated from it: positions, measured distances,
    lengths and counts, via/track/pour inventories, rule values, passive values, MPNs and LCSC
    codes, and calculated results. Derivations become requirement + formula with datasheet
    constants and the refdes they take; accepted risks name the limit they break; first-board
    checks give the requirement and the formula. The Rails table gives required ranges; the parts
    table gives way to the Order BOM preset. Datasheet/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
2026-11-04 feat(kicad-toolkit): Added an update-footprint-from-library board op to kicad_edit
2026-11-04 fix(espion-cam): J2 shell overhangs the top edge by HRO's recommended amount, with a JLCPCB order note; footprint silk shortened, +3V3 loop and CC1 re-stepped round the shield pad, U5–J2.A6 near limi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
    [espion-cam.kicad_pcb]
2026-11-06 ci(espion-cam): Published the espion-cam schematic and PCB to GitHub Pages with Ferrite's web viewer
2026-11-09 feat(espion-cam): rev 0.1 release for JLCPCB: release date in the title block, JLCJLCJLCJLC order-number placeholder on the bottom silk; layout.md records the placeholder decision
    [espion-cam.kicad_pcb]
2026-11-09 feat(espion-cam): cut the JLCPCB Economic PCBA cost with Basic and Preferred parts
    Swap passives and protection parts to JLCPCB Basic/Preferred-Extended parts on the same footprints (14 fewer $3 loading-fee lines), with re-derived worst cases: 100nF 16V decoupling, Basic 10k, SS16, SCCB/XVS resistors, boost and +3V3 feedback dividers, TPS2121 ILIM and CP2 dividers, X7R COMP/ISET/sense caps, 2.2uF 50V boost HF caps, H7VHD3UA TVS (D2/D16), SRV05-4 USB ESD (U5) and ACMECON GVZ 330uF bulk. Remove the J1 shield RC network (C1, R2, R3): the shield is tied straight to GND (user decision 2026-11-09). docs/hardware updated for the changed formula inputs, decisions and risks.
    [camera.kicad_sch, espion-cam.kicad_pcb, ethernet.kicad_sch, imu.kicad_sch, led_driver.kicad_sch, mcu.kicad_sch, power.kicad_sch]
2026-11-09 feat(espion-cam): cut the BOM to 56 parts and 19 JLCPCB fee lines
    Economic PCBA for 5 boards: 64 → 56 distinct parts, loading fees $81 → $57, order
    $207.58 → $179.82 (JLCPCB API prices, 2026-11-09). User decisions 2026-11-09.
    Value swaps: R60/R61 47k/1.2k (LED current −7 %, worst case 853 mA), Basic R69 sense
    resistor, X7R 10 nF for C33/C35/C41 with R55 100k (timeout 0.61–1.79 ms, FW-7 wait
    60 ms), R14/R41/R42 1.2k, R27/R28 20k/33k, R73/R74 5.1k, U7 TP74LV1T34S5, C13 on
    C22's 100 uF part.
    Footprint changes: C14 on the C46/C47 330 uF 50 V 10x10 part (filter column moved,
    PoE filter pours replaced by tracks), R6 6.2k 0603, R34/R53 0402, Q1 HL2310A SOT-23.
    The headroom loop becomes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
    [camera.kicad_sch, espion-cam.kicad_pcb, ethernet.kicad_sch, imu.kicad_sch, led_driver.kicad_sch, mcu.kicad_sch, power.kicad_sch]
2026-11-09 feat(espion-cam): remove D16, the BOOT button clamp; BOOT_SW runs straight from SW2 to its via, near entry dropped, the unclamped button recorded as an accepted risk
    [espion-cam.kicad_pcb, mcu.kicad_sch]
2026-11-09 docs(hardware): drop values computed from part values from led.md and the README, note VLED_SENSE back-feeding an unpowered P4 pin, fix the IP101G TXD3/TXD2 pin order
2026-11-09 feat(espion-cam): apply the schematic review: R14 to the 5.1k strap part, sheet notes removed, D1 footprint description
    - R14 (MDIO pull-up) moves to the strap resistors' part (one BOM line), cutting the
    low-level sink current; ethernet.md drops the edge-rate reading of R14 and adds the
    P4 -> PHY logic-level check, with its zero-margin VIH as an accepted risk.
    - The six text notes on the Camera, Ethernet and MCU sheets are removed (the XVS one
    was stale); the docs no longer point to them.
    - camera.md, FW-17: SCCB pull-ups into an unpowered module through reset and boot as
    an accepted risk; firmware holds GPIO8/9 low while the camera is off; first-board
    check 2 measures DOVDD and SD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
    [camera.kicad_sch, espion-cam.kicad_pcb, ethernet.kicad_sch, mcu.kicad_sch]
2026-11-09 feat(espion-cam): SCCB pull-ups R41/R42 to the 5.1k part
    1.2k drew 2.75 mA at 3.3 V, close to the I2C 3 mA sink limit before any pull-ups on the camera module; 5.1k draws 0.65 mA and reuses the board's 5.1k part. Board footprints updated from the schematic.
    [camera.kicad_sch, espion-cam.kicad_pcb]
2026-11-09 fix(espion-cam): JLCPCB placement corrections for U5, U7 and Q1
    Checked in JLCPCB's placement preview on 2026-11-09: U5 (C7420376) was
    turned 90 degrees, U7 (C47117591) and Q1 (C7420347) 180 degrees. With
    the new assembly.corrections entries all three sit on their pads with
    pin 1 at the silk mark. D1 and the C14/C46/C47 can have no 3D model in
    the preview; layout.md now says to check them in the order's DFM
    Analysis. Also record the user's acceptance of the +3V3 west-edge loop
    on B.Cu under U2.
2026-11-09 style(espion-cam): merge collinear wire segments on the IMU, MCU and power sheets
    Joins 8 pairs of collinear wire segments into single wires (IMU 4, MCU 3,
    power 1); the drawn wires and the netlist are unchanged. KiCad also wrote
    (embedded_fonts no) to the top-level sheet on save.
    [espion-cam.kicad_sch, imu.kicad_sch, mcu.kicad_sch, power.kicad_sch]
2026-11-10 fix(espion-cam): JLCDFM findings: M3 holes without via ring, vias off their pads
    H1-H4 move to MountingHole_3.2mm_M3_Pad, which clears JLCDFM's via-to-PTH spacing. Fifteen same-net vias move to a copper gap of at least 0.1 mm from their pads; C18.2's, the U9.1/U6.27 via and C40.2/U11.2's have no site that holds the clearances. layout.md records the remaining JLCDFM finding classes and extends the stock-silk decision to silk over tented vias.
    [espion-cam.kicad_pcb, espion-cam.kicad_sch]
2026-11-10 build(nix): bump Ferrite for the 3D board view, baked into the espion-cam viewer site
2026-11-10 build(nix): bump Ferrite for the WebGL2 reload on a lost WebGPU device
2026-11-10 feat(esp32p4-csi): minimal CSI-2 receiver for two lanes of RAW8 with the ISP bypassed
    Clocks and resets, the D-PHY supply LDO, D-PHY rate setup, host and bridge
    configuration, DW-GDMA capture into two to four caller buffers swapped in the
    interrupt handler, an async wait_frame, counters and status readouts for
    debugging. Ported from the ESP-IDF sources and the TRM; builds, but has not
    run on hardware yet.
    [lib.rs]
2026-11-10 feat(poc-p4-eth): bring-up firmware for the ESP32-P4-ETH with an onboard detector benchmark
    Boot report (chip, caches, PSRAM test and read speed, SCCB scan, OV9281 chip
    ID), OV9281 register tables for four 120 fps RAW8 modes, a blob detector that
    works on whole frames or line strips, synthetic frames, and a benchmark of the
    detector from PSRAM and from internal RAM. No camera capture yet.
2026-11-10 feat(poc-p4-eth): capture OV9281 frames over CSI-2 in all four modes, with a still dump over UART
    All four modes deliver whole frames at 119.92 fps with no receiver errors on
    the ESP32-P4-ETH. The still dump and tools/still.py exist to check the pixels
    on a host; the test pattern and live stills are correct.
    esp32p4-csi: take the received length from the DMA destination address; on
    rev v3.2 the completed-block register reads one item short.
    [camera.rs, lib.rs, main.rs]
2026-11-10 feat(esp32p4-csi): line-strip capture into a ring of internal-RAM buffers
    The bridge cuts each frame into DMA blocks of a set number of lines; a
    circular list delivers them in order with back-pressure, and the short last
    block marks the frame end. Builds; not run on hardware yet.
    [lib.rs]
2026-11-10 feat(poc-p4-eth): 120 fps soak with onboard blob detection on whole frames from PSRAM
    Per mode: a 30 s live run and 10 s runs on synthetic frames with 0, 16 and 64
    blobs while capture keeps running. Measured: 640x480 and 640x400 keep 120 fps
    (worst case 4.6 ms per frame); 1280x800 and 1280x720 need 9.3-11.9 ms per
    frame and fall to 85-106 processed frames per second.
2026-11-10 feat(esp32p4-csi): RAW10 in the frame and strip paths
    Config carries the data type; frame, buffer and strip sizes follow the packed
    line length. Strip heights are checked against the burst size per format.
    Builds; RAW10 has not run on hardware yet.
2026-11-10 fix(esp32p4-csi): resynchronise strips on a verified frame after a stall
    On hardware a DMA stall makes the bridge emit a short block mid-frame and
    shifts the blocks of the next frame, so restarting at the next short block
    delivered rows of the wrong frame. After any damage the driver now waits for a
    frame end and checks one whole frame's block sizes before delivering again.
    Adds interrupt and cache-invalidation timing counters.
    Strip capture verified on the ESP32-P4-ETH in the four 120 fps RAW8 modes:
    frames assembled from strips equal whole-frame captures byte for byte.
2026-11-10 feat(poc-p4-eth): faster RAW8 modes, RAW10 modes and detector input, strip soak
    ov9281: 1280x800 and 1280x720 at 144 fps, 640x400 at 210 and 253 fps, 320x200
    at 454 fps in RAW8; 1280x800 and 1280x720 at 120 fps and 640x400 at 210 fps in
    RAW10. vision: packed RAW10 rows through the same row API. camera: capture
    path for every mode, a detector check per mode, RAW10 still dump. strip_soak:
    the detection soak on line strips in internal RAM. The new modes, RAW10 and
    the strip soak have not run on the board yet. README: capture and whole-frame
    soak results.
2026-11-10 feat(poc-p4-eth): strip soak passes in all four 120 fps modes
    The ring is split per width (4 strips at 1280 wide, 8 at 640 wide) and rebuilt
    on a width change; runs start on a fresh frame; rates use the 64-bit time
    base. Measured with every pixel processed from line strips in internal RAM:
    1280x800 4.3-5.2 ms per frame, 1280x720 3.9-4.8 ms, 640x480 1.6-2.5 ms,
    640x400 1.3-2.3 ms on synthetic frames, no frame lost. README: strip capture
    and strip soak results.
2026-11-10 feat(poc-p4-eth): decoded sensor readback and worst frame gap in the capture check
    First board run of the new modes: 1280x800 and 1280x720 at 144 fps, 640x400 at
    210 and 253 fps (RAW8), and the three RAW10 modes capture whole frames with no
    errors. 320x200 at 454 fps gives no frames (frame start/end pairing errors),
    not investigated. Stills, the RAW10 byte layout check and RAW10 strips are not
    done.
    [camera.rs]
2026-11-10 fix(poc-p4-eth): keep the capture check's logging under the stack-frame limit
    [camera.rs]
2026-11-10 feat(poc-p4-eth): stills of the fast and RAW10 modes, frame rate predicted from the measured frame period, 1280x720 at 144 fps on the 96 MHz clock
    The sensor's frame lasts (VTS - 1) x HTS + 1730 SCLK cycles, not VTS x HTS; the capture check now prints the first-to-last rate against that prediction. The unbinned 1280x720 window gives a wrong picture below VTS 814 at 80 MHz, so mode 5 runs at 96 MHz with VTS 915. New plans dump a scene still and test-pattern stills per mode.
    [camera.rs, main.rs]
2026-11-10 fix(poc-p4-eth): 320x200 mode delivers frames and a whole picture at 453 fps
    The common block's VFIFO read start (0x4601 = 0x30, 384 B) is longer than a 320 B line, so the frame never ended; its PSV mode (0x4F00 = 0x0C) blanked 188 of 200 rows in the short frame. Mode 8 sets both to the datasheet defaults and runs at VTS 241.
2026-11-10 feat(poc-p4-eth): RAW10 through the strip path: strip check against whole frames and RAW10 strip soak
    The strip check captures the sensor's random test pattern (same seed every frame) as whole
    frames for reference, then checks every strip row against it. The RAW10 strip soak uses a
    ring of 3 strips of 102 400 B in the same 320 KiB; the receiver and the sensor stream are
    restarted for every run, because a RAW10 DMA stall of about 30 ms crashes the board.
    [camera.rs, main.rs, strip_soak.rs]
2026-11-10 fix(poc-p4-eth): 320x200 at its measured 453 fps, PSV and VFIFO notes, mode stills over all 12 modes at gain 2x
    The 320x200 mode's name and nominal rate follow the frame-period formula (453.386 fps at
    VTS 241), its exposure limit is 216 lines. The register docs record what power-saving mode
    does to short frames and that the VFIFO read start must not exceed one line.
    MODE_STILLS_PLAN now covers all 12 modes at gain 2x for the brighter bench scene.
    [camera.rs, main.rs]
2026-11-10 docs(esp32p4-csi): record the RAW10 stall fault of the strip path and the consumer rule until it is solved
2026-11-10 docs(poc-p4-eth): results of all 12 modes, RAW10 strips and the final board runs
    The README now answers the third question (the Inno-Maker mode list): capture, stills and
    frame period of all 12 modes in the brighter scene at gain 2x, the RAW10 byte layout, the
    mode 8 and mode 5 findings (VFIFO read start, PSV, minimum VTS), the 96 MHz picture cost,
    the RAW10 strip check and soak, the RAW10 stall fault, findings for the camera board and the
    open points. The strip soak's module doc words the stall fault as the driver docs do.
    [strip_soak.rs]
2026-11-10 feat(ov9281): OV9281 sensor driver with a mode builder for format, size, readout and frame rate
    The builder solves clock, HTS and VTS from the measured frame period and refuses requests outside the sensor's limits or the caller's rate tolerance; the device layer writes a mode over embedded-hal-async I2C. Requests equal to the PoC's 12 board-verified modes give the same register writes. The limits are provisional until the board characterisation is in.
    [device.rs, lib.rs, limits.rs, mod.rs, mode.rs, rate.rs, regs.rs]
2026-11-10 fix(esp32p4-csi): restart the ISP and the bridge before resuming a stalled strip DMA
    The CSI bridge is the DMA's flow controller and alone ends DMA blocks. After a halt on a held strip it cut the following blocks in the wrong place; in RAW10 it never ended the next block, and the DMA wrote over the ring, the statics and the stack. The driver now resets and reprograms the ISP and the bridge before it resumes a halted channel or restarts one after a DMA error.
    [lib.rs]
2026-11-10 test(poc-p4-eth): stall test for the strip path: provoked DMA halts in RAW8 and RAW10 with content and guard checks
    [camera.rs, main.rs, strip_soak.rs]
2026-11-10 feat(ov9281): measured sensor limits, line-length search for the requested rate, README with the characterisation
    Minimum VTS crop h + 51 and binned h + 31 plus 4 lines of margin; PSV on only from h + 95 / h + 75; HTS 728..2912 with the link minimum for wide RAW10 at 96 MHz; widths in multiples of 8 (RAW8) or 64 (RAW10) from 128; x origin in multiples of 8; VFIFO read start w / 16. The solver keeps HTS 728 when the rate is inside the tolerance, lengthens the line minimally otherwise, and uses 96 MHz only above the 80 MHz maximum. Error::Alignment gains height_multiple.
    [lib.rs, limits.rs, mode.rs, regs.rs, requests.rs]
2026-11-10 feat(ov9281): single register read and write in the device layer
    Ov9281::read_register for diagnostics (the PoC logs the window, timing, VFIFO and PSV
    registers after a mode is written) and Ov9281::write_register for settings the driver does not
    model (the gated MIPI clock lane, PSV forced off for a reference capture). Both go through the
    driver's address and error type; the next configure undoes any such write.
    [device.rs]
2026-11-10 feat(poc-p4-eth): sensor modes and control from the ov9281 crate, request verification plan
    The 12 hand-built register tables (src/ov9281.rs) are gone. The modes are 12 named requests
    to the ov9281 mode builder, solved in const context (src/modes.rs), and every sensor access
    goes through ov9281::Ov9281: identify, configure, exposure, gain, test patterns, start, stop,
    and the register readback in the log. The receiver configuration comes from the mode, the
    frame-period check from the crate's frame_cycles, and each mode logs the solver's choice
    (clock, HTS, VTS, PSV, predicted rate, rate error). New REQUESTS_PLAN (src/requests.rs):
    requests built at run time on the P4 and timed with the cycle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
    [camera.rs, main.rs, modes.rs, requests.rs, soak.rs, strip_soak.rs]
2026-11-10 docs(poc-p4-eth): the stall fault as fixed, the ov9281 crate and what its measured limits settle
2026-11-10 feat(proto): camera stream in protocol version 2: requests, responses and frame chunks
    Host-initiated UDP over IPv6 link-local on port 5009: camera and stream settings with the sensor driver's errors, the applied state with counters, and self-describing frame chunks of RAW8 or packed RAW10 on a 1409-byte grid in datagrams of at most 1452 bytes.
    [cam.rs, lib.rs]
2026-11-10 feat(poc-viewer): live camera viewer with every sensor setting, and a fake camera to test against
    egui application for the camera stream of protocol version 2: frames uploaded as raw bytes and expanded on the GPU, settings checked locally with the ov9281 crate before they are sent, link and frame statistics. poc-fake-cam speaks the protocol with synthetic frames, a rate limit and datagram loss.
2026-11-10 feat(poc-p4-stream): Ethernet and IPv6 on the ESP32-P4-ETH at the wire rate, with throughput and RX tests
    New throwaway crate: EMAC and IP101 PHY through esp-hal's Ethernet driver with three workarounds (TX threshold mode instead of store-and-forward, UDP and ICMPv6 checksums in smoltcp, DMA storage placed where the driver's address check accepts it), embassy-net on the fixed link-local fe80::4553:9281. Measured: 11.8 MB/s of UDP payload to the host from internal RAM, PSRAM and camera frames with nothing lost, and 60 s of checked reception at the wire rate.
    [bench.rs, build.rs, camera.rs, cpu.rs, device.rs, ip101.rs, main.rs, mod.rs]
2026-11-10 feat(esp32p4-jpeg): greyscale JPEG encoder driver for the ESP32-P4 with the 2D-DMA it needs
    One baseline JPEG file per 8-bit frame, read and written by the 2D-DMA, with the header and the IJG quality table built on the CPU. The 2D-DMA has no register block and no interrupt sources in the PAC: both are defined here. Measured on the board: 171 Mpixel/s (1280x800 in 5.99 ms), unchanged while the CSI receiver captures into the same PSRAM.
2026-11-10 test(poc-p4-eth): JPEG encoder plan: correctness against libjpeg-turbo, speed alone and while capturing, recovery
    [camera.rs, jpeg_bench.rs, main.rs, modes.rs]
2026-11-10 feat(poc-p4-stream): camera stream service: the espion-proto camera protocol on UDP 5009 with the OV9281, raw frames at the wire rate
    The Stream service (now the default; Bench stays selectable) answers state, camera, stream
    and poll requests, checks SetCamera in the protocol order and applies all or nothing,
    restarts the receiver for a new mode with the lanes checked in stop state, recovers from a
    failed start or a stalled sensor, and sends the newest frame in chunks to the last
    requester, RAW10 packed or as its high 8 bits. A repeat of the last request is answered
    without executing it again (docs/protocol.md). Test hooks on UDP 5010 (CPU report, fault
    injection, stall) with tools/streamdia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
    [bench.rs, camera.rs, capture.rs, check.rs, cpu.rs, diag.rs, main.rs, mod.rs]
2026-11-10 feat(poc-viewer): board test against the real camera, one-column side panel, frames cut by a mode change counted apart
    tests/board.rs (ignored by default) checks every format, readout, size, rate range, origin,
    refusal, control, pattern, encoding, max_fps, the timeout and the error paths against the
    board, and soaks it. The fake camera answers a repeated request without executing it again,
    as the board does. README with the measured display figures.
    [app.rs, board.rs, e2e.rs, fake.rs, net.rs]
2026-11-10 build(nix): bump Ferrite for single-wall plated bores and smooth STEP shading in the 3D view
2026-11-10 feat(proto): JPEG frames in protocol version 3: encoding, quality and automatic quality, encoder state, refusals
2026-11-10 test(poc-viewer): JPEG frames reassembled and checked, board test for the JPEG stream
2026-11-10 feat(poc-viewer): the fake camera streams JPEG like the board: encoder thread, waiting slots, automatic quality, refusals
2026-11-10 feat(poc-viewer): JPEG decoded off the UI thread, only what can be shown; encoding, quality and automatic quality controls; compression and decoder statistics
2026-11-10 test(poc-viewer): the decoding stage decodes only the frames taken and drops a frame that does not decode
2026-11-10 test(poc-viewer): board test: room for automatic quality from the scene at gain 2x, bars against the codec's own error
    [board.rs]
2026-11-10 fix(poc-viewer): compressed frame size and ratio from JPEG frames only, a distinct label for the board's quality row
    [app.rs, net.rs]
2026-11-10 fix(poc-viewer): the self-test names a decoded JPEG frame as JPEG with its file size
    [app.rs]
2026-11-10 fix(poc-viewer): follow a board that restarts its frame numbers instead of taking its frames as stale
    [e2e.rs, net.rs]
2026-11-10 docs(poc-viewer): JPEG stream, decoding stage and decoder choice, controls, measurements against the fake camera, tests
2026-11-10 docs: poc-p4-stream, esp32p4-jpeg and poc-viewer in the repo map, layout and architecture; the camera stream implemented; host crate pins
2026-11-10 feat(poc-p4-stream): JPEG stream from the hardware encoder, newest frame at each stage, automatic quality, encoder test hooks
2026-11-11 docs(poc-p4-stream): JPEG soak, live window on the desktop and the final board test
2026-11-11 fix(poc-viewer): automatic JPEG quality brings the quality back up
    With automatic quality on, the viewer sent the slider's value as the
    ceiling, so after setting the quality to 1 automatic quality could never
    raise it. Automatic quality now sends a fixed ceiling of 90
    (AUTO_QUALITY_CEILING) and the slider, disabled, shows the quality the
    board has in use; with it off the slider sets the quality. The manual
    quality is kept apart (stream::StreamEdit), so automatic on and off
    returns to it, and a board reporting automatic quality never replaces it
    with its ceiling. The board's settings are adopted again after the link
    was lost or the board restarted. --quality is the manual quality.
    No wire or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
    [app.rs, lib.rs, main.rs, stream.rs]
2026-11-11 docs: timer capture and PTP register facts from the P4 reference manual
    SYSTIMER has no ETM capture task; timer 0 of each timer group has one (TG1's
    is free), and MCPWM capture is the alternative. The PTP reference clock can be
    the crystal or PLL_F80M. The esp32p4 0.3 PAC has no block for the EMAC PTP
    registers. The VDMA, CSI, ISP, EMAC and RMT have no ETM event or task.
2026-11-11 feat(esp32p4-perf): performance counters of the P4 HP cores
    Cycles, instructions, conditional branches, mispredictions and stores from the
    CSRs (the event selectors count nothing until written), and the L1/L2 cache
    hit and miss counters. Raw reads, no lock and no esp dependency, so a bare
    second core can use it. From the counter code of the 2026-11-11 measurement
    run; not yet run on the board as a crate.
    The workspace exclude list and the lockfile ignores also name esp32p4-pie and
    espion-vision, which follow.
2026-11-11 refactor(espion-vision): the blob detector in its own crate
    The detector and the synthetic frame generator move from poc-p4-eth into
    firmware/espion-vision, with no esp dependency, so their tests run on the host
    with cargo test. One flood-fill reference serves the unit tests and a new
    randomised comparison (widths 64 to 1280, 0 to 64 discs, thresholds around
    127..129, RAW8 and RAW10, random strip splits); it also checks the blob order.
    No change to the detector's code. poc-p4-eth depends on the crate.
2026-11-11 feat(esp32p4-pie): PIE instruction encoders, the per-core token and the dark-skip kernel
    rustc has no support for the P4's PIE vector extension, so const fn encoders
    build the instruction words and asm! emits them with .insn. A host test
    compares every encoder with words from Espressif's assembler. Pie::enable
    turns PIE on for the calling core (CSR 0x7F2), hands out one token per core
    and refuses silicon before rev 3.0, whose encodings differ.
    first_bright scans for the first 64-byte block with a byte at or above a
    threshold: the pipelined unsigned-max kernel measured on 2026-11-11 (0.41
    cycles per pixel on a cold strip against 1.35 scalar), changed so it never
    reads past the slice. This ve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
    [check.rs, encode.rs, lib.rs, pie.rs]
2026-11-11 docs(poc-p4-stream): baseline of the stream phase and where the datagram copies are misaligned
    Baseline, committed tree b47fe4c with SERVICE = Bench, netbench tx 20 s each
    (cycles per datagram; before = README figures of 2026-11-10, after = today):
    - internal: busy 88.7 -> 89.5 %, copy_cyc 13 044 -> 13 076, tx_stack 10 169 -> 10 165
    - psram: busy 90.8 -> 91.4 %, copy_cyc 16 251 -> 16 276, tx_stack 10 218 -> 10 276
    - camera: busy 91.9 -> 92.6 %, copy_cyc 16 706 -> 16 738, tx_stack 10 242 -> 10 302
    Host rates unchanged (11.796 to 11.801 MB/s, 0 lost).
    Copy alignment, measured with a temporary histogram build:
    - bench: every application copy is unlike modulo 4 (source 0, destination 2: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
2026-11-11 feat(poc-p4-stream): interrupt-handler, wake and sleep accounts, polls per task, accounting feature
    - src/irq.rs: wrappers in the vector table in front of the CSI, JPEG, 2D-DMA,
    EMAC and esp-rtos tick handlers (calls and own cycles per handler and core,
    nesting left out), the handler time outside executor passes, the wake path
    (handler end to the next pass) and, with idle-counter, the sleep path.
    - Reports: bench `busy_all_pct`, `| irq ...`, `copy_misaligned`; stream diag
    `coreN_<task>_polls`, `coreN_busy_all_pct`, `coreN_irq_pct`,
    `coreN_irq_outside_pct`, `coreN_wake_*`, new command `I` (per handler).
    Existing field names unchanged; streamdiag.py gets `irq`.
    - Feature `accountin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
2026-11-11 build(cam-p4): L2 cache size 128 KiB, as the bootloader sets it
    The ESP-IDF v6.1 bootloader bundled with espflash 4.7.0 programs a 128 KiB L2
    cache; esp-hal assumes 256 KiB unless ESP_HAL_CONFIG_L2_CACHE_SIZE says
    otherwise, so cam-p4 left 128 KiB of L2MEM unused. Same setting and comment
    as poc-p4-eth and poc-p4-stream.
    Checked in the linked ELF (readelf -S, nm), release build:
    - before: .rwtext at 0x4FF4_0C48, stack 0x4FF4_38C8..0x4FFA_DFC0 (0x6A6F8 B)
    - after: .rwtext at 0x4FF2_0C48, stack 0x4FF2_38C8..0x4FFA_DFC0 (0x8A6F8 B)
    The RAM region now starts 128 KiB lower (0x4FF2_0000), 568 KiB in all.
    Not flashed: the boot report was not read on the board.
2026-11-11 feat(esp32p4-pie): RAW10 dark-skip kernel
    Pie::first_bright10 finds the first 80-byte pass (16 groups, 64 pixels)
    of CSI-2 RAW10 data that holds a pixel byte at or above a threshold,
    ignoring the low-bit byte of each group: five loads, five ANDs with
    constant masks, four unsigned maxima and one horizontal maximum per pass.
    Whole groups are scanned one at a time until the data reaches a 16-byte
    boundary, so every pass starts on a group boundary and the masks stay
    constant; the tail is scanned the same way. Nothing outside the slice is
    read.
    first_bright10_scalar is the reference with the same contract,
    self_test10 compares the two on the chip, and the host tests cover the
    reference, the case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
    [check.rs, encode.rs, lib.rs, pie.rs, split.rs]
2026-11-11 feat(esp32p4-pie): copy kernel for any alignment
    Pie::copy copies like copy_from_slice (and panics like it when the
    lengths differ) at any alignment of source and destination. Up to 15
    bytes go one at a time until the destination reaches a 16-byte boundary;
    then an aligned source is copied 64 bytes per pass with plain loads and
    stores, and a misaligned one by loading the aligned words that hold it,
    each once, and joining each two neighbours with esp.src.q, the byte shift
    set by esp.movx.w.sar.bytes. Every PIE load and store is at an aligned
    address, so the result does not depend on the CFG misaligned-access
    modes. The first and last word read may extend past the source slice by
    up to 15 byte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
    [check.rs, encode.rs, lib.rs, pie.rs, split.rs]
2026-11-11 feat(esp32p4-pie): Internet checksum sum kernel
    Pie::sum16_be returns the one's-complement sum of a slice taken as
    big-endian 16-bit words (an odd last byte is the high byte of a last
    word), fully folded into 0..=0xFFFF, equal to sum16_be_scalar, for any
    alignment and length. The aligned middle goes through
    esp.vmulas.u16.xacc against a vector of ones, with the load of the next
    16 bytes fused into each accumulate as in esp-dsp's dotprod_u16; it is
    fed in pieces of at most 64 KiB, whose lane sum stays below 2^31, so the
    40-bit XACC never saturates and esp.movx.r.xacc.l reads the whole sum.
    The little-endian lane sum becomes the big-endian word sum with one byte
    swap of the folded value when t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
    [check.rs, encode.rs, lib.rs, pie.rs, split.rs]
2026-11-11 feat(poc-p4-eth): detector benchmark with the core's counters, row cost and blob cost
    The benchmark reads esp32p4-perf's counters around every timed window
    (instructions, IPC, conditional branches, mispredictions, stores, L1
    instruction and data miss events) and logs them per case as a second table.
    Two new sections follow: all-dark rows through begin_frame + push_rows at
    widths 32..1280, warm and cold, with a least-squares fit per row + per pixel;
    and the 1280x800 strip path with 64 discs of radius 2, 4, 8 and 12 drawn over
    the synth background, cost per blob from the difference to the dark frame.
    The existing per-case lines and time table are unchanged. The whole run takes
    about 15 s after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
2026-11-11 docs(poc-p4-eth): cache-line alignment of the detector statics tried, not kept
    Plan step 0.3 put the detector state, its blob output and the benchmark
    buffer on 64-byte boundaries and moved them with one added static. Cycles per
    1280x800 frame (log /tmp/p4perf-logs/BenchFlags/*.log, frame pointers on):
    strip 0 strip 16 strip 64 psram 0
    unaligned 1 728 342 1 830 331 2 104 554 3 972 087
    unaligned, moved 1 729 010 1 833 263 2 104 686 3 972 091
    aligned 1 728 338 1 850 132 2 143 145 3 972 232
    aligned, moved 1 728 312 1 851 266 2 143 649 3 972 120
    Moving the data changes nothing beyond 0.16 %. The aligned build is 1.1 to
    1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
2026-11-11 perf(poc-p4-eth): no frame pointers; .cargo/backtrace.toml brings them back
    Dropping -C force-frame-pointers removes the save and set-up of s0 in every
    call. Same source, measured 2026-11-11 (logs /tmp/p4perf-logs/BenchFlags/
    A-unaligned.log with, C-nofp.log without):
    1280x800 strip 0 blobs 4320 -> 4238 us cycles -1.9 % instructions -1.3 %
    1280x800 strip 64 blobs 5261 -> 5107 us cycles -2.9 % instructions -1.4 %
    1280x800 psram 0 blobs 9930 -> 9833 us cycles -1.0 % instructions -1.3 %
    640x400 strip 0 blobs 1323 -> 1280 us cycles -3.2 % instructions -2.2 %
    dark row (warm) 470.3 -> 429.0 cycles, 229.6 -> 214.6 instructions
    mispredictions, dark frame 1603 -> 1618; 64 di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
2026-11-11 build(poc-p4-stream): no frame pointers; .cargo/backtrace.toml brings them back
    As in poc-p4-eth (f6f1a52), where dropping -C force-frame-pointers made the
    detector 1 to 3 % faster with 1.3 to 2.2 % fewer instructions. Same comment
    and same .cargo/backtrace.toml: `cargo build --release --config
    .cargo/backtrace.toml` restores them for a frame-pointer backtrace; without
    them a panic prints its message, location and a stack dump that espflash
    monitor decodes (not with --no-addresses). The stream itself was not
    measured.
    Checked 2026-11-11: clippy with zero warnings for the default features,
    --no-default-features and --features idle-counter; flashed once: boots to
    "stream: ready" and "net: lin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
2026-11-11 build(cam-p4): no frame pointers; .cargo/backtrace.toml brings them back
    .cargo/backtrace.toml` restores them for a frame-pointer backtrace. Builds
    and passes clippy with zero warnings; not flashed (cam-p4 only boots and
    idles today).
    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
2026-11-11 feat(esp32p4-cache): cache maintenance behind one cross-core lock, and cache prefetch
    Both HP cores share one set of cache-sync registers, and the ROM cache functions program
    them without a lock. The new crate holds the merged maintenance code of esp32p4-csi and
    esp32p4-jpeg (invalidate, write_back, writeback_invalidate, line_size, in_l2mem,
    non_cacheable, L1_LINE) and runs every ROM cache call under one spinlock on an atomic word,
    taken with mstatus.MIE cleared on the calling core and released before MIE is restored. No
    esp-hal, esp-rtos or critical-section dependency, so a bare second core can call it.
    It also sets up the hardware prefetch over the PAC: L1 data and L2 autoload (four secti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
2026-11-11 feat(poc-p4-eth): PIE kernel self-tests at bench boot, busy-row bench cases
    The bench build enables PIE on core 0 (esp32p4_pie::Pie::enable) and runs
    the four kernel self-tests against their scalar references, 12 288 cases
    each, and logs failures and time. First run on the board (rev v3.2):
    first_bright, first_bright10, copy and sum16_be: 0 failures each, in
    612, 887, 816 and 322 ms.
    The bench adds busy rows at 1280 wide: a bright pixel in the same column of
    every row (one run per row linked to the row above) and of every 8th row
    (a one-pixel blob between dark rows), warm and cold. They keep the cost of
    rows near blobs visible once dark rows are skipped in whole spans.
    Baseline (log /tmp/p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
    [bench.rs, main.rs]
2026-11-11 docs(esp32p4-pie): the four self-tests passed on the board
    First board run, 2026-11-11, poc-p4-eth bench build (commit dfeddcf), 12 288
    cases per kernel: first_bright, first_bright10, copy and sum16_be 0 failures.
    Log /tmp/p4perf-logs/DetectorOneCore/s0b-base.log. Timing of the last three
    on the board is still to be done.
2026-11-11 perf(espion-vision): one skip interface for the dark skip
    The dark skip becomes the trait Skip (first_bright, first_bright10), passed
    to each call through the new push_rows_with, process_frame_with and
    process_frame_raw10_with; the calls without _with use Scalar. The contract
    is exact at window level: no bright pixel before the answer and one within
    the next 64 bytes (RAW10: 80 bytes), unless the slice ends.
    Scalar tests 64 bytes per step on the OR of 16 words (the same loads per
    byte as before, fewer instructions), then tests the words of a block that
    passes and goes on if none is hot, so a dark block whose OR reaches the
    threshold no longer stops it. RAW10 does the same on 80 bytes with t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
    [lib.rs]
2026-11-11 perf(poc-p4-stream): datagram copy through PIE, the chunk header written apart
    Plan step 7.1. The application's copy into the socket ring is esp32p4-pie's Pie::copy, at
    any alignment. PIE is enabled once on core 0, where the thread-mode executor runs; its tasks
    share the token. The boot self-tests ran on the board: copy 0 of 4096 cases failed, sum 0
    of 4096.
    espion-proto gets FrameChunk::encode_header: it writes everything but the data bytes and
    returns their offset, so the send task copies the bytes itself (RAW10 as RAW8 writes its
    high bits there directly). Message::encode uses it; the bytes on the wire are unchanged, a
    new test compares both paths with the derived encoding.
    The stream's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
    [bench.rs, cam.rs, diag.rs, main.rs, mod.rs, send.rs]
2026-11-11 perf(espion-vision): skip whole spans of dark rows while idle
    When no component crosses the row above (no run in it), push_rows_with runs
    the skip once over the rest of the strip instead of row by row. The rows
    before the answer are counted as passed (row counter only: a dark row with
    an empty row above changes no other state and no Stats counter), and row by
    row work resumes in the row of the answer, from the answer, so the row is
    not skipped twice. A strip that ends while idle leaves the detector idle.
    For RAW10 the span is whole rows, so whole groups. Results and Stats are
    unchanged.
    Tests: the randomised equivalence test now leaves out one strip in eight
    (first_row jumps), compares with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
    [lib.rs]
2026-11-11 perf(espion-vision): lean row entry for the rows near blobs
    The rows of one push_rows_with call run in one strip loop, monomorphised per
    pixel format and RAW8 threshold class (a Format trait: Raw8<HIGH>, Raw10),
    so no match on runtime flags per row. The run builder (Scan) is built once
    per call and kept in locals; the two run buffers swap by reference; the
    pixel, run and overflow counters are folded into Stats once per call.
    link and end_row are not called when the row and the row above have no
    run. The stride is a NonZeroUsize and the span slice is cut at
    o - o % stride, so neither the division nor that slice is checked; the
    remaining checks are the run-count slices (one compare each, on ro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
    [lib.rs]
2026-11-11 perf(espion-vision): blob centroids without 64-bit divisions
    emit divided two u64 sums by the u64 weight sum, a __udivdi3 call each on
    RV32. q5 now gets the same value, min((32 s + sw / 2) / sw, u16::MAX), from
    a compare for a saturating quotient (n >= sw * 2^16), one 32-bit division
    when n fits 32 bits, else one step of long division in base 2^16 (Knuth's
    algorithm D, a two-digit divisor) from 32-bit operations, with the proof in
    its comment. sw == 0 (only if the u32 sum wrapped) keeps the u64 division.
    Blobs are unchanged.
    A test compares q5 with the u64 division at the edges of each path, at
    every divisor size from 1 to 32 bits and on the largest sums of an
    all-bright 1280x800 frame, RAW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
2026-11-11 perf(espion-vision): component table indexed by slot, without bounds checks
    The component table is indexed by Slot<COMPS>, a u16 below COMPS by
    construction: only Slot::all (the free list at reset) and Slot::FIRST make
    one, and parents, run labels (Label<COMPS>, a slot or NONE) and merged
    entries are copies. The table (Comps) implements Index and IndexMut with
    get_unchecked under that invariant, so find, union, alloc, link, end_row and
    emit no longer check the index. Run and Comp carry COMPS as a type
    parameter so a slot cannot index a table of another size. The free-list
    and merged stacks keep their checks; they are the stacks' guards.
    No change in results. Detector instructions per blob o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
    [lib.rs]
2026-11-11 perf(poc-p4-stream): own EMAC DMA ring, completion interrupt every 8th frame
    esp-hal 1.2.2 now only brings the EMAC and the PHY up (blocking driver).
    src/net/eth.rs takes its DMA over: 16 RX + 16 TX descriptors read and
    written through the non-cacheable alias, one cache call per frame through
    esp32p4-cache, TX threshold mode and CIC 0 from the start, a TX completion
    interrupt on every 8th frame only, its own ETH_MAC handler and the
    embassy-net driver.
    Measured 2026-11-11, same session and flags, step 1 build (7e303f2) ->
    this build. Bench, 20 s per source, 0 lost or bad datagrams in both:
    - runner cycles/datagram: internal 27143 -> 14736, PSRAM 27287 -> 15776,
    camera 27400 -> 15637
    - CPU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
2026-11-11 docs(poc-p4-eth): detector steps on the board, scalar restructure kept
    The five espion-vision commits, each measured with the bench build in its
    own board session (logs /tmp/p4perf-logs/DetectorOneCore/s1..s5-*.log),
    all kept. 1280x800 strip frames against the baseline (s0b-base.log):
    dark 4235 -> 3145 us, 1 694 165 -> 1 258 221 cycles (-25.7 %),
    909 557 -> 628 569 instructions; 64 blobs 5098 -> 4578 us,
    2 039 229 -> 1 831 278 cycles (-10.2 %). Busy rows: column 2626.8 ->
    2672.5 cycles (+1.7 %, instructions -4.8 %), every 8th -20.3 %.
    The skip interface alone made rows near blobs and blobs dearer (column
    row +5.6 %, blob +14 %); it is kept with the span skip and lean row entry
    built on it.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
2026-11-11 feat(espion-vision): PIE dark skip behind the feature pie
    impl Skip for esp32p4_pie::Pie, compiled for riscv32 only; the optional
    dependency comes with the cargo feature pie. The host build and the 32
    tests are the same with and without it. On the board (poc-p4-eth bench,
    same build, log /tmp/p4perf-logs/DetectorOneCore/s6-pie.log), 1280x800
    strip frames, Scalar -> Pie: dark 3170 -> 986 us (1 268 214 -> 394 642
    cycles), 64 blobs 4616 -> 2675 us (1 846 724 -> 1 070 360 cycles).
    [lib.rs]
2026-11-11 feat(poc-p4-eth): PIE dark skip in the bench and the soaks
    app enables PIE once on core 0 (the rule for the token is stated there) and
    passes it to the bench, the frame soak and the strip soak (DarkSkip,
    with_skip!: one monomorphised call per strip or frame). SOAK_SKIP chooses
    the soaks' skip (default Pie). The bench runs every case with Scalar and
    Pie in one build, and at boot checks them against each other on 320 RAW8
    and 320 RAW10 random frames with random strip splits: 0 mismatches of 640
    (log /tmp/p4perf-logs/DetectorOneCore/s6-pie.log). Busy rows with 4, 16 and
    64 runs per row added; not yet run on the board.
    1280x800 strip, Scalar -> Pie in the same build: dark 3170 -> 986 us,
    64 blo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
    [bench.rs, camera.rs, main.rs, soak.rs, strip_soak.rs]
2026-11-11 docs(poc-p4-eth): skip cost against run density, Scalar and Pie
    Busy rows with 1, 4, 16 and 64 one-pixel runs per row on the board (log
    /tmp/p4perf-logs/DetectorOneCore/a-density.log, the bench of aedcd8e), warm
    cycles per 1280-pixel row, Scalar -> Pie: 1 run 2694.9 -> 2102.2 (-22 %),
    4 runs 4720.2 -> 5329.9 (+12.9 %), 16 runs 11956.2 -> 11268.2 (-5.8 %),
    64 runs 41582.9 -> 42357.5 (+1.9 %). No single break-even density; Pie stays
    the RAW8 skip (64-blob frame -42 %).
2026-11-11 perf(esp32p4-pie): feature ram puts the dark-skip kernels in internal RAM
    Pie::first_bright, Pie::first_bright10, skip_dark and skip_dark10 go to
    .rwtext with the cargo feature ram (about 0.5 KB). Measured as part of
    espion-vision/ram in firmware/poc-p4-eth/README.md, "Hot code in RAM and
    Zb/Zcb" (logs /tmp/p4perf-logs/DetectorOneCore/b-*.log).
    [pie.rs]
2026-11-11 perf(espion-vision): feature ram puts the hot detector functions in internal RAM
    push_rows_with (the strip loop), the Scalar skip methods, link, end_row,
    emit, find, union, alloc, release, finish, flush and the centroid division
    get link_section .rwtext with the cargo feature ram, which also turns on
    esp32p4-pie/ram. Checked with nm: all in the RAM text range. On the board,
    1280x800 strip frame with 64 blobs, max - mean: Scalar 316 -> 16 us, Pie
    416 -> 19 us; mean cycles -2.0 % (Scalar) and -0.3 % (Pie); instructions
    unchanged. RAM cost with both skips linked 22 428 B (from flash build to
    RAM build, no Zb); Pie path 9.3 KB, Scalar 12.7 KB (with Zb/Zcb).
    [lib.rs]
2026-11-11 perf(poc-p4-eth): detector hot code in RAM and Zba/Zbb/Zbs/Zcb
    espion-vision with the feature ram and -C target-feature=+zba,+zbb,+zbs,+zcb
    in .cargo/config.toml (+zcmp and +zicond stay off). Four builds on the
    board (logs /tmp/p4perf-logs/DetectorOneCore/{a-density,b-ram,b-zb,b-ramzb}.log),
    1280x800 strip frame with 64 blobs, neither -> both:
    Scalar 4707/5023 -> 4513/4533 us mean/max, 1 882 956 -> 1 805 336 cycles,
    969 048 -> 947 777 instructions; Pie 2653/3069 -> 2586/2603 us,
    1 061 582 -> 1 034 404 cycles, 518 910 -> 500 336 instructions. Dark frames
    unchanged in cycles (Scalar 1 259 253 -> 1 257 900, Pie 394 801 -> 395 863).
2026-11-11 perf(poc-p4-stream): chunk datagrams beside smoltcp, one PIE copy into the TX buffer
    net/chunk.rs writes the Ethernet, IPv6 and UDP headers, the chunk's
    header and a PIE copy of the bytes straight into a TX descriptor's buffer
    and computes the UDP checksum with Pie::sum16_be; smoltcp keeps answers,
    neighbour discovery, ping and RX. The peer's MAC is learned from received
    frames; until then chunks go through the socket. The bench checks the
    checksum against smoltcp's on 4096 random datagrams at boot (0 failed).
    The driver now counts TX errors and underflows from the written-back
    descriptors.
    Measured 2026-11-11, same session and flags, step 2 build (64d4b17) ->
    this build, cycles per datagra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
    [bench.rs, chunk.rs, diag.rs, eth.rs, mod.rs, send.rs]
2026-11-11 feat(poc-p4-eth): RAW10 bench, and L1 data autoload over each strip
    Bench: RAW10 1280x800 strip frames and dark or false-hit RAW10 rows with
    both skips, and the strip path with the L1 data autoload over the strip
    buffer (off, miss, hit, miss+hit). Log
    /tmp/p4perf-logs/DetectorOneCore/c-raw10.log (RAM placement and Zb/Zcb on):
    RAW10 Scalar -> Pie: dark 4032 -> 1617 us, 64 blobs 5925 -> 3653 us;
    skip 1.50 -> 0.52 cycles per pixel warm. A false hit (top 8 bits at the
    threshold, value below) costs 650 to 800 cycles. Pie is the RAW10 skip too;
    RAW10 thresholds should be multiples of 4.
    Autoload miss+hit: Scalar dark 1 258 286 -> 1 146 025 cycles (-8.9 %),
    Pie dark 394 310 -> 301 263 (-23.6 %, 75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
    [bench.rs, strip_soak.rs]
2026-11-11 docs(poc-p4-eth): live strip soak in the final detector configuration
    1280x800 RAW8 at 120 fps, build 0f6a093 (RAM placement, Zb/Zcb, autoload
    miss+hit per strip), live 120 s then synthetic 0 and 64 blobs, logs
    /tmp/p4perf-logs/DetectorOneCore/e-scalar.log and e-pie.log. Detect per
    frame mean/max, before (2026-11-10, strip-soak4.log) -> after:
    live 4351/4889 -> Scalar 2873/2916, Pie 762/806 us;
    synth 64 blobs 5185 -> Scalar 4112, Pie 2228 us.
    14 406 live frames per skip, 0 truncated, skipped, discarded, stalls,
    overruns or errors, 120.052 fps. The live scene gave 0 blobs.
    Also lists the RAW10 and autoload bench cases in the file table, and the
    live strip check's row sum (10 874 992, misstat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
2026-11-11 feat(poc-p4-stream): frame-path counters; steps 7.5 and 7.6 measured, not kept
    The test hooks' P reply times the JPEG encode's driver set-up (first
    poll), its wake-up after the 2D-DMA RX handler saw the file's end, and
    the driver's end work (last poll); N adds the body copy alone
    (direct_copy_cyc), as the bench report does. irq records each handler's
    last end; cpu::Timed books count, cycles and longest.
    Measured 2026-11-11 (logs /tmp/p4perf-logs/StreamFrames/s1-*, s3-*):
    - whole-frame invalidate 1450-2200 cycles (4-5.5 us) a frame, at most
    0.2 % of core 0 (558 fps); CSI DMA handler 1170-1270 cycles a frame
    - step 7.5a (no invalidate for JPEG frames) tried: capture task 6207 ->
    4776 cycl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
2026-11-11 docs: measured PSRAM and detector figures, crate table and esp-hal gaps of 2026-11-11
    architecture.md: the memory section's unverified 200 MB/s is replaced by the
    measured PSRAM read rate and detector times (poc-p4-eth README sections named in
    the text), with what they mean for whole frames in PSRAM against strips; the
    vision budget gets the live 1280x800 detector time as reference; the crate table
    follows the crates (PIE kernels, Skip and features of espion-vision, users of
    esp32p4-cache, poc-p4-eth, poc-p4-stream's own EMAC rings); the esp-hal gaps and
    pinned versions list PIE, cache locking, prefetch, performance counters and the
    ROM memcpy, each with the crate that works around it.
    timi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
2026-11-11 docs(esp32p4-cache): prefetch under live DMA, and what is still untested
    The per-strip L1 autoload of poc-p4-eth and the next-chunk L1 preload of
    poc-p4-stream ran under live DMA with their figures; open points: prefetch
    beside the other core's cache-sync operations, two owners of the one register
    set, whole-frame PSRAM autoload under capture. The rule and build sections
    name the stream's own Ethernet rings and the direct users.
2026-11-11 feat(esp32p4-csi): split CsiStrips into a control half and a polling reader
    CsiStrips::split turns the strip driver into a StripControl for the core
    that created it (start, stop, configuration, counters, DMA error and
    stall handling with service()) and a Send StripReader for a bare second
    core. The reader polls each list item's BLOCK_TFR_DONE write-back bit
    through the non-cacheable alias, classifies the blocks as the interrupt
    path does (shared Tracker), gives each item back to the DMA at once and
    invalidates the strip through esp32p4-cache. The per-strip interrupt is
    masked after the split.
    A strip the DMA overwrites before its release (the reader was lapped)
    releases false, is counted, a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
    [lib.rs, split.rs]
2026-11-11 feat(poc-p4-eth): blob detector on a bare core 1 (RUN_CORE1)
    Core 1 starts through esp-hal's CpuControl::start_app_core with a static
    16 KiB stack and runs no scheduler: it clears mstatus.MIE, installs its
    own trap vector (mcause, mepc and mtval into atomics, no stack, no
    logging, then waits) and initialises its performance counters. Its loop
    polls the split strip reader, runs the detector on each strip
    (core1::detect_rows, the one detector call), checks the release and
    publishes one result per frame (blobs, detector Stats, cycles,
    instructions, late strips, worst latency) in an overwrite-never
    single-producer single-consumer queue of atomics (spsc.rs, with host
    tests). A heartbeat and a cou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
2026-11-11 feat(esp32p4-cache): per-core lock statistics behind feature `stats`
    With the feature `stats`, every operation that takes the cross-core cache
    lock records, per core, the number of operations, the longest wait for the
    lock and the longest hold (mcycle). `stats::get(core)` reads them and
    `stats::reset_max()` clears the maxima. Without the feature nothing changes.
    poc-p4-eth uses it to measure lock contention between core 0 and core 1.
    [lib.rs, stats.rs]
2026-11-11 feat(poc-p4-eth): core-1 test plans: pixel check, holds, stalls, contention
    The bare core-1 runner gets a second job, the pixel check: each strip's row
    checksums against whole-frame random-test-pattern references, through the
    split reader on core 1. On it run the test plans of `core1_soak` (chosen by
    `PLAN`): BRINGUP and MEASURE (detector, Pie or Scalar, live and synthetic),
    CHECK_PLAN (four modes), FAULTS (lap sweep with a timeline of the list items
    and of the held strip's first bytes, order errors, stall holds with the
    guard check, stop/start cycles), CONTENTION and LONG (core 0 running cache
    operations in a tight loop and from a 10 kHz TIMG1 interrupt while core 1
    checks). L1 data-cache a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
    [camera.rs, core1.rs, core1_soak.rs, main.rs, strip_soak.rs]
2026-11-11 docs(poc-p4-eth): board results of the detector and the strip reader on core 1
    Results of 2026-11-11, logs in /tmp/p4perf-logs/TwoCore/: four 120 fps modes
    with the reader and the detector on a bare core 1, pixel check in all four
    modes (0 bad rows), lap and stall holds (no changed strip released true in
    3752 holds, item timeline after the take), Pie and Scalar 2-minute
    measurements against the core-0 figures, the call-graph walk, cache lock
    statistics. The checklists in the esp32p4-csi and poc-p4-eth READMEs record
    each item as pass, not run or deferred to the co-load step.
2026-11-11 fix(poc-p4-eth): stop/start cycles with the stream off between runs
    The cycle test restarted the receiver while the sensor kept streaming.
    `StripControl::start` (as `CsiStrips::start`) must run before stream-on:
    `stop` holds the D-PHY and the CSI host in reset, and with the stream on the
    clock lane never synchronised again. Seen on the board
    (/tmp/p4perf-logs/TwoCore/h2-cycles.log): after the first restart no block
    at all (strips done stayed 39, DMA completed items 0), PHY clock lane
    neither in stop state nor receiving HS, so every cycle waited the full
    300 ms for a good frame and 1000 cycles took over 5 minutes.
    Each cycle now starts the receiver, turns the stream on, waits for the first
    g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
    [core1_soak.rs]
2026-11-11 test(poc-p4-eth): contention plan of 2 + 10 minutes, long plan of 10 minutes at 1280x800
    CONTENTION: the detector live for 2 minutes, then the pixel check for 10 minutes, core 0 running cache operations from thread mode and a 10 kHz timer interrupt. LONG: the pixel check on 1280x800 RAW8 for 10 minutes without contention.
2026-11-11 docs(esp32p4-csi): core-1 board checks: cycles, order check, contention, soak
    Outcomes of 2026-11-11 (logs in /tmp/p4perf-logs/TwoCore/), recorded in the
    esp32p4-csi, poc-p4-eth and esp32p4-cache READMEs:
    - 1000 stop/start cycles with the reader polling (h3-cycles.log): ReaderBusy
    0, strips of a stopped run released true 0 (false 772), rows bad 0, every
    run's first good frame 33.56 ms at most after start.
    - Lap order check (i-faults.log): in all 1178 holds where the strip's first
    bytes changed, item k - 1's done bit read set right after them; the lap
    flag comes about 20 us before the first write into k. The [INFERENCE] on
    the write-back order is replaced by this measurement.
    - Tra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
2026-11-11 docs(esp32p4-cache): lock statistics before Build; prefetch beside cache-sync on the other core
    The rebase onto main put the lock-statistics section after Build; it now comes before it. The open point on prefetch beside cache-sync operations of the other core records the 2-minute contention run with core 1's per-strip autoload (no hang or trap, data not checked on that path).
2026-11-11 docs(esp32p4-cache): prefetch beside the other core's cache-sync operations ran
    The module docs of prefetch said running prefetch on one core beside cache-sync operations on the other was not tested; poc-p4-eth's 2-minute contention run did that (core 1 autoload per strip, core 0 about 444 000 lock operations per second) without a hang or trap. The data on that path was not checked.
2026-11-11 feat(espion-core1): the bare core-1 runner as a library, poc-p4-eth moved onto it
    poc-p4-eth's RUN_CORE1 runner moves into a new no_std crate so poc-p4-stream
    can run the same code beside the network: core 1's entry, trap vector and
    poll / detect / publish loop (src/runner.rs, from poc-p4-eth's core1.rs), the
    frame-result queue on atomics with its host tests (src/spsc.rs), and core 0's
    handle and monitor (src/monitor.rs: reader hand-over, mailbox wait, service and
    drain every millisecond, the once-a-second lines, the run's totals, trap and
    stall reports). The dark skip is now a start parameter (SkipChoice), and the
    pixel check takes the per-strip L1 data autoload too when the run asks for it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
    [core1_soak.rs, lib.rs, main.rs, monitor.rs, runner.rs, spsc.rs, strip_soak.rs]
2026-11-11 feat(poc-p4-stream): Service::BenchVision, the detector on a bare core 1 beside the bench
    The bench service runs on core 0 unchanged (sources internal and psram; camera
    and capture are refused with an answer), while core 1, started bare through
    espion-core1 at the first V request, runs the blob detector or the pixel check
    on live 1280x800 RAW8 64-row strips at 120 fps (3 strips in internal RAM, PIE
    skip on core 1's own token, the per-strip L1 data autoload switchable). Core 0
    calls service() and drains the results every millisecond and logs core 1's
    lines once a second (src/vision.rs). The pixel check's reference is taken once
    from whole frames of the sensor's random test pattern before core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
    [bench.rs, camera.rs, diag.rs, main.rs, prefetch.rs, vision.rs]
2026-11-11 docs(poc-p4-stream): co-load results, the detector on core 1 beside the wire rate
    poc-p4-stream README: Service::BenchVision, how to run it, and the dated
    "Co-load" section: detector mean / max 754 / 779 us idle, 769 / 805 beside
    PSRAM TX at 11.794 MB/s, 0 late, lapped or dropped; 10 min of PSRAM TX beside
    core 1's pixel check: 4 879 045 datagrams, lost, duplicate, reordered and bad
    0, 57 824 000 rows, 0 bad; host-to-board RX 20 s, every byte checked, 0 bad
    or lost. Core 0's TX cycles per datagram 6 589 without core 1, 7 360 beside
    the detector; core 0's manual L1 preload waits while core 1's autoload
    section is open (15 183 against 6 898 beside the check, co2.log).
    esp32p4-cache: the open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
2026-11-11 feat(esp32p4-perf): marker pins through the cores' dedicated-IO CSRs
    `marker::enable` clears the calling core's cpu_gpio_oen bits (active low, as esp-hal and ESP-IDF have it; the TRM says the opposite), `marker::toggle` inverts channels with csrr/xor/csrw of cpu_gpio_out, `marker::outputs` reads them. No memory access and no lock, so core 1's bare runner can use it. Measured on core 0: 16 back-to-back toggles 175 cycles against an empty window of 15, 10 cycles and 3 instructions each.
    [lib.rs, marker.rs]
2026-11-11 feat(espion-core1): marker pins: core 1's strip and frame channels, routing and boot read-back
    Feature `markers` (off by default): core 1's entry enables its dedicated-IO channels MARKER_STRIP and MARKER_FRAME and its loop toggles them when a strip of a detector run comes in and when a frame's blobs are final, a CSR read and write each. The module `markers` (core 0) routes a channel of either core to a pad through the GPIO matrix (esp-hal's DedicatedGpioOutput only routes the calling core's channels) and runs the boot self-check: the pads read back through GPIO_IN under a GPIO interrupt on any edge, edges counted for 1 s of a run and logged once the markers rest. Walk with the feature: 24 fu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
2026-11-11 feat(poc-p4-eth): marker pins at strip taken and frame done on both cores, STROBE on
    Feature `markers` (off by default): the strip soak toggles core 0's channels on GPIO22 (strip taken, before the detector) and GPIO23 (centroids final), core 1's runner toggles its own on GPIO20 and GPIO21 (header pins 35, 34, 32, 31), and the sensor's STROBE output is turned on after each mode set-up (0x3006 = 0x0C). Toggles rather than pulses: a pulse a few cycles wide escapes most logic analysers. Boot self-check on the board (1280x800 RAW8 120 fps): 1561 strip and 120 frame edges in 1 s on each core, none merged. Cost against the build without it, same session: core 1 detect 754 us mean both, strip soak s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
2026-11-11 feat(poc-p4-stream): marker pin at datagram queued, core 1's markers in BenchVision, STROBE on
    Feature `markers` (off by default): net::chunk::send toggles core 0's channel on GPIO26 when a datagram goes to the TX ring, core 1's strip and frame channels go to GPIO20 and GPIO21, and the sensor's STROBE output is turned on after each mode set-up. Boot self-check in BenchVision: 8189 datagram, 1561 strip and 120 frame edges in 1 s, none merged. Cost, same session: direct_cyc 4212 -> 4245 cycles per datagram, core 1 detect 758 us both. README: wiring, capture, figures to read, what is not measured.
2026-11-11 feat(proto)!: frame timing in the camera stream state (version 4)
    State gains timing: the last frame sent whole, the span of its JPEG
    encode and the span of its send, in µs after the frame's timestamp. The
    host reads it at its poll rate; the chunks do not change.
    poc-p4-stream: the encode task stamps its span into the job, the send
    task books the frame's timing where it counts it as sent. The fake
    camera does the same from its encoder thread and its link.
    BREAKING CHANGE: protocol version 4; the board and the viewer must both
    be built from this commit on.
2026-11-11 feat(poc-viewer): pipeline timing model
    Where a frame's time goes from the start of its exposure to the GPU:
    exposure and readout computed from the mode, encode and send from the
    state's frame timing joined with the frame's arrival here, decode and
    draw from every frame presented. The board's clock is placed against
    this PC's by the fastest datagram of the window. One snapshot a second
    from the last 2 s (median and slowest per step); the self-test prints
    it.
2026-11-11 feat(poc-viewer): redesigned window with the pipeline timing diagrams
    A status bar (link, frame rates, Mbit/s, latency, each with its last
    minute), a settings rail, the picture with the timing strip under it,
    and the counters by stage in a drawer. Every control is painted here
    (src/ui) in one theme: neutral greys, one hue per pipeline stage, red
    for faults only, IBM Plex Sans and Mono (bundled, OFL-1.1).
    New: a sensor window picker (drag to move, corner to resize, on the
    driver's grid; the readout keeps the window's place), zoom and pan on
    the picture with the pixel under the pointer, and the timing ribbon
    (always) and staircase (expanded), redrawn once a second from the
    pipeline timing mod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
    [app.rs, diagram.rs, main.rs, mod.rs, picture.rs, selftest.rs, theme.rs, widgets.rs]
2026-11-11 docs(poc-viewer): pipeline timing measured on the real camera
2026-11-11 fix(poc-viewer): timing strip header and frame labels in a 720p window
    [app.rs, diagram.rs]
2026-11-11 feat(kicad-toolkit): copper follows renamed and merged nets in update_from_schematic
    Tracks, arcs, vias and zones of a net move to the net its surviving pads are on when all of them agree and none is left on the old name (a rename or a merge, chains and swaps included). A split net's copper and copper whose pads are gone or unconnected stay and are noted.
2026-11-11 refactor(espion-cam): remove redundant pulls, bypass capacitors, GND loops and unused options
    Removes R7, R38, R59, R9, R8, C12, C19, C23, C28, C38, C30, TP2, TP3, TP7, TP10 and R52 from the schematic and the board (user decisions 2026-11-11). The PHY now leaves reset on its own pull-up and latches LED mode 1; FW-11 pulses PHY_RST_N before use. GPIO35 straps on the P4's internal pull-up; BST_EN defaults low on the TPS61170's internal pull-down. Module pin 12 (CAM_IO1) is a no-connect. The hand-assembly list is U6, J1, U2. Constraints and docs follow.
    [camera.kicad_sch, espion-cam.kicad_pcb, ethernet.kicad_sch, led_driver.kicad_sch, mcu.kicad_sch, power.kicad_sch]
2026-11-11 feat(kicad-toolkit): bus alias ops and query
    set_bus_alias creates an alias or replaces its members and refuses to remove a member a local label still takes off a bus carrying the alias (vector members by their bits); remove_bus_alias refuses while a label or sheet pin names the alias; kicad_query bus_aliases lists members, uses and unused members.
2026-11-11 refactor(espion-cam): remove the LED power switch, PoE filter, mux reference and sense dividers
    Removes U8, C34, C35, R57 (LED power switch), L1, C14 (PoE output filter), R20, R21, C52 (TPS2121 external reference), R27, R28, C26 (VBUS sense) and R71, R72, C49 (+32V sense); user decisions 2026-11-11. The boost runs straight from +5V and is off by BST_EN; the mux uses its internal reference (CP2 at GND, R19 changed) with the 100 us switchover; C21 grows so the soft start covers the LED bank at plug-in. +5V_POE_F joins +5V_POE (U2.6 feeds the B.Cu trunk directly), +5V_BST joins +5V. GPIO6, GPIO20 and GPIO21 are free. FW-4 is removed; FW-6, FW-7, FW-8, FW-10 and FW-22 follow. New accepted risks: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
    [espion-cam.kicad_pcb, espion-cam.kicad_sch, led_driver.kicad_sch, mcu.kicad_sch, power.kicad_sch]
2026-11-11 refactor(espion-cam): remove the CSI links, RMII series resistors and three single series parts
    Removes R45-R47 and R49-R51 (0 ohm links in the MIPI CSI-2 lanes), R11, R12, R15, R35, R36, R37 (RMII data series resistors), R54 (STROBE timeout), R30 (status LED data) and R53 (camera supply link); user decisions 2026-11-11. Each pair of nets joins under the surviving name (CSI_*, /Ethernet/RMII_*, STROBE, STATUS_LED, +3V3) with a straight track at the former part. The CSI skew rule and the length and via-parity constraints now cover whole lanes (HDG 1.4.6). The BOOT tap is a short branch off RMII_TXD1 with a derived length limit. R13 on REF_CLK stays. New first-board check: overshoot at the RMI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
    [camera.kicad_sch, espion-cam.kicad_pcb, ethernet.kicad_sch, led_driver.kicad_sch, mcu.kicad_sch]
